Tomoshibi-technology/RCJ-Japan2024-Circuit/diagram/Encoder.pdf

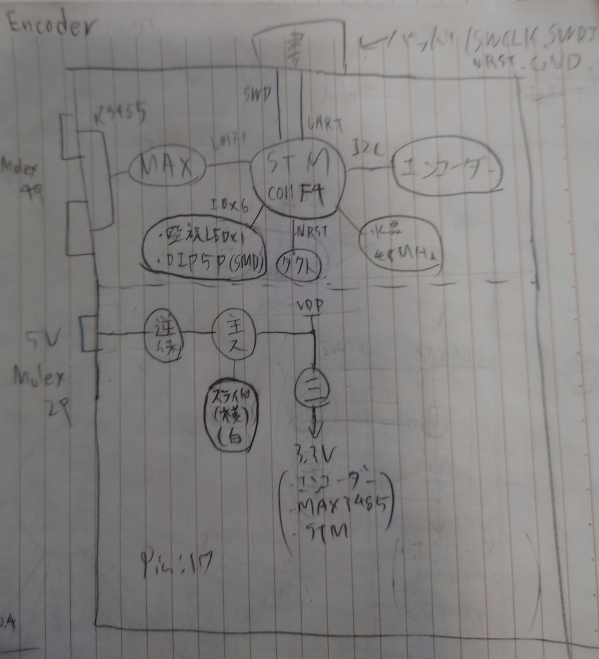
[picture p1: page 1]
