Tomoshibi-technology/RCJ-Japan2024-Circuit/diagram/IR.pdf

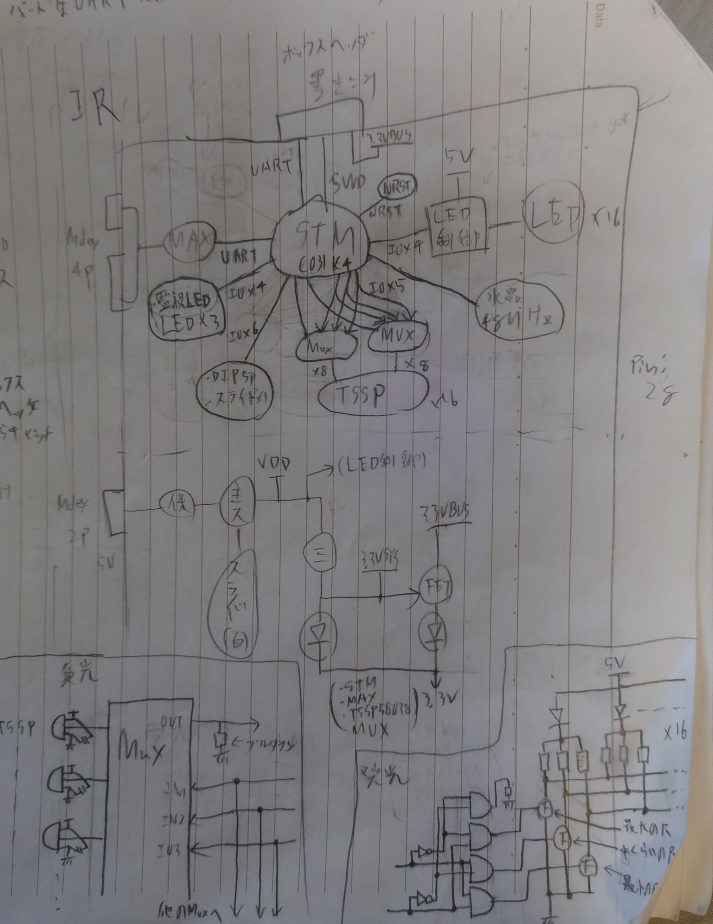
[picture p2: page 1]
