Tomoshibi-technology/RCJ-Japan2024-Circuit/diagram/LargeMD.pdf

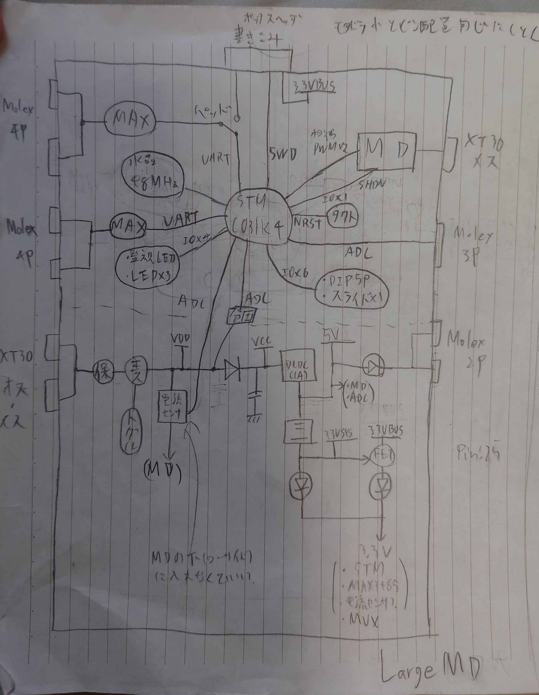
[picture p3: page 1]
