Tomoshibi-technology/RCJ-Japan2024-Circuit/diagram/Mother.pdf

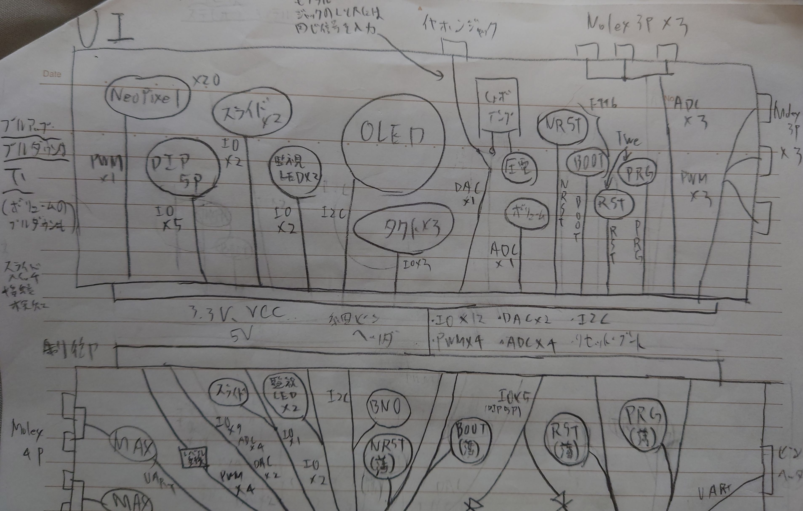
[picture p4: page 1]
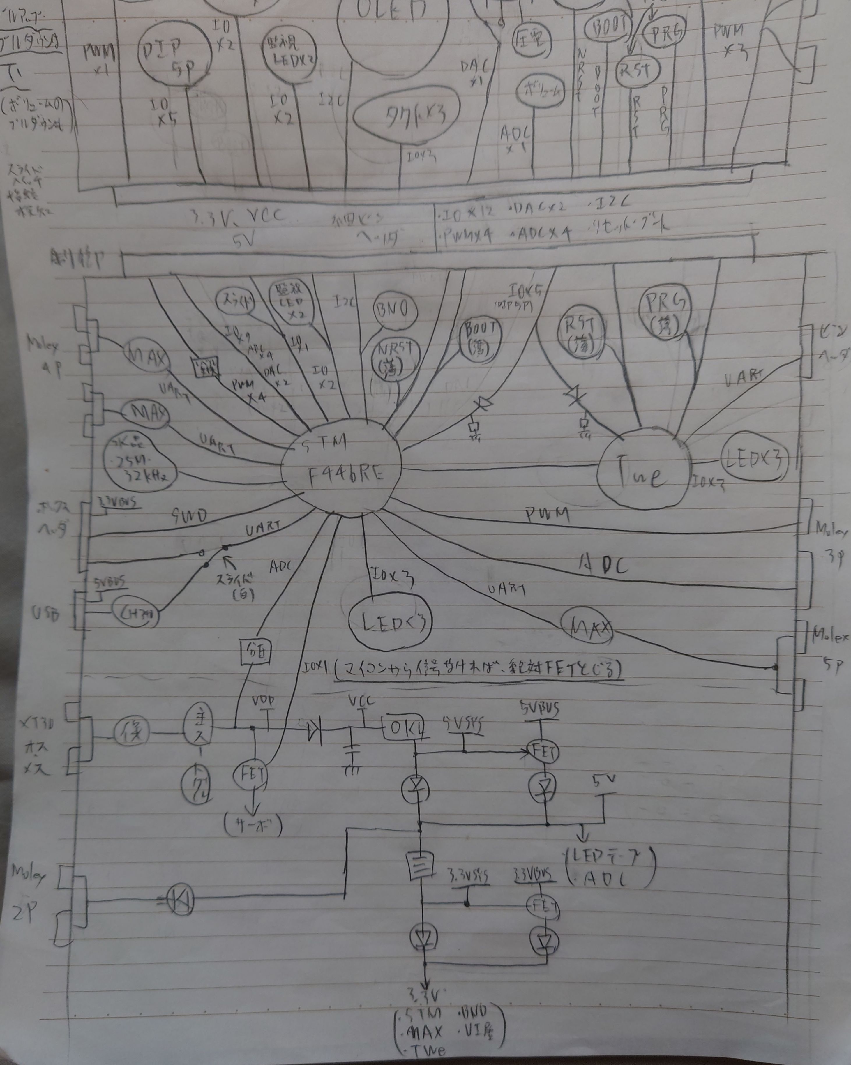
[picture p5: page 2]
