Tomoshibi-technology/RCJ-Japan2024-Circuit/diagram/Pannel.pdf

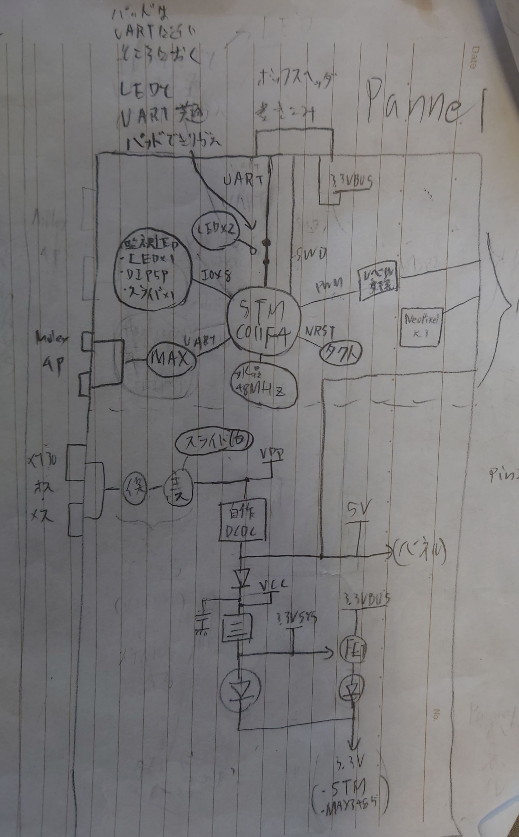
[picture p6: page 1]
