Tomoshibi-technology/RCJ-Japan2024-Circuit/diagram/SmallMD.pdf

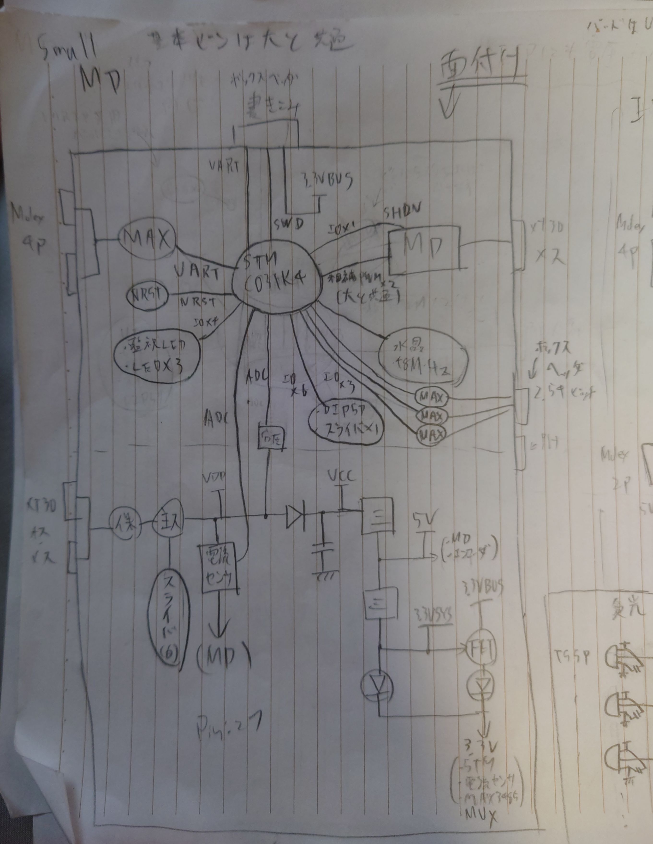
[picture p7: page 1]
