Tomoshibi-technology/RCJ-Japan2024-Circuit/diagram/SmallPW.pdf

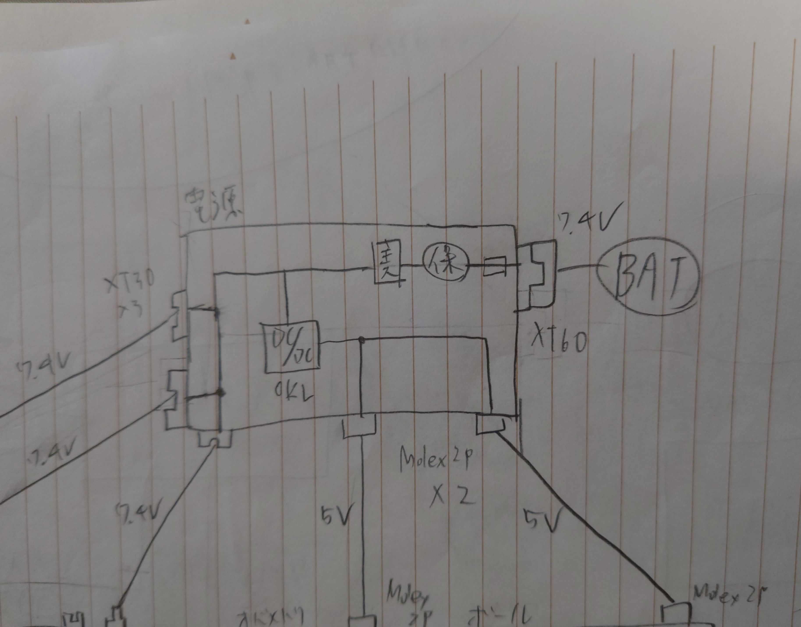
[picture p8: page 1]
