Tomoshibi-technology/RCJ-Japan2024-Circuit/diagram/LEDPole.pdf

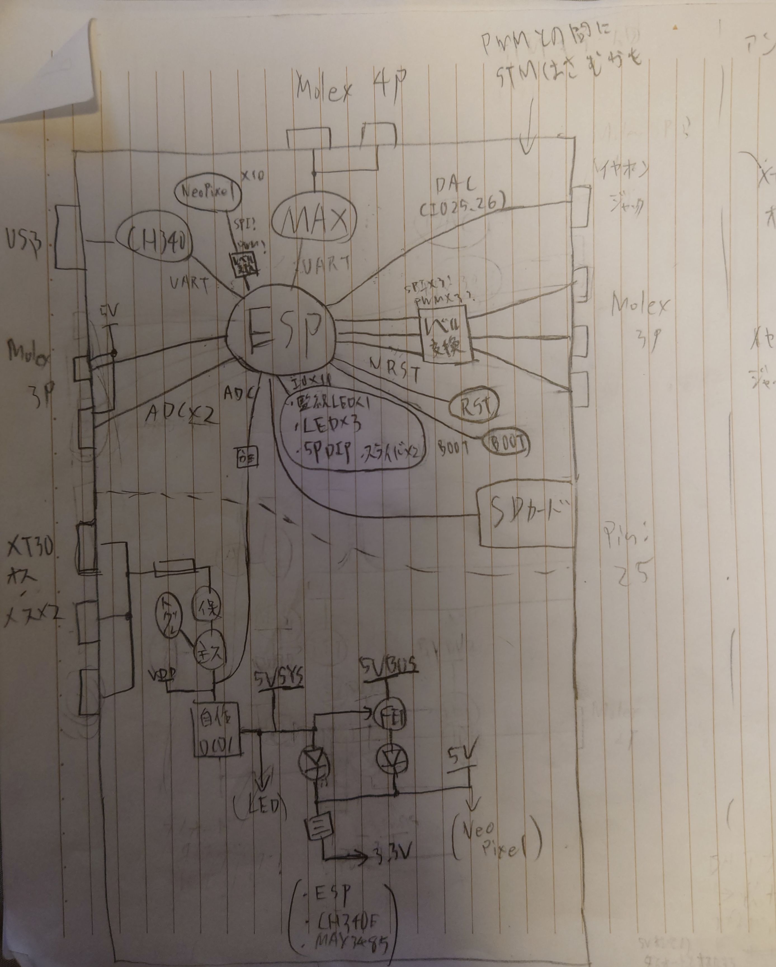
[picture p9: page 1]
