Tomoshibi-technology/RCJ-Japan2024-Circuit/diagram/RobotArm.pdf

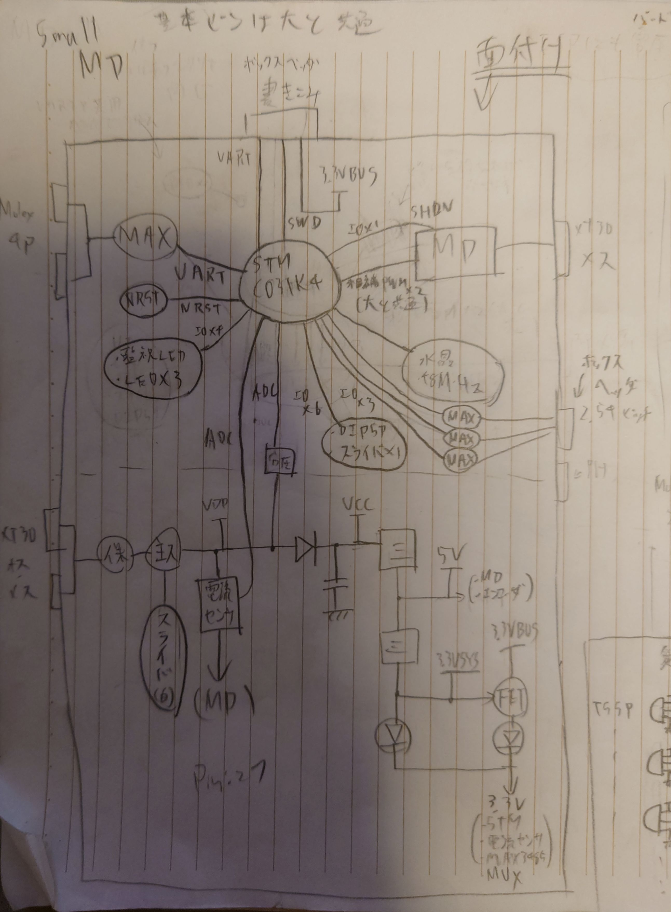
[picture p10: page 1]
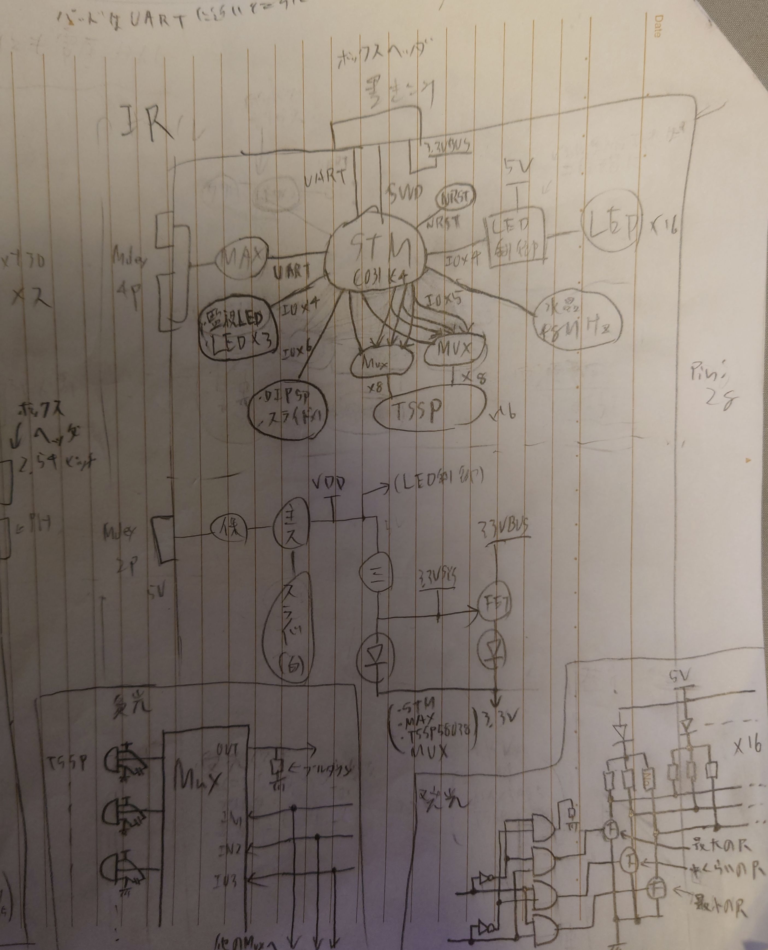
[picture p11: page 2]
