Tomoshibi-technology/RCJ-Japan2024-Circuit/LargeMD/MV2_MD_PIC2.png

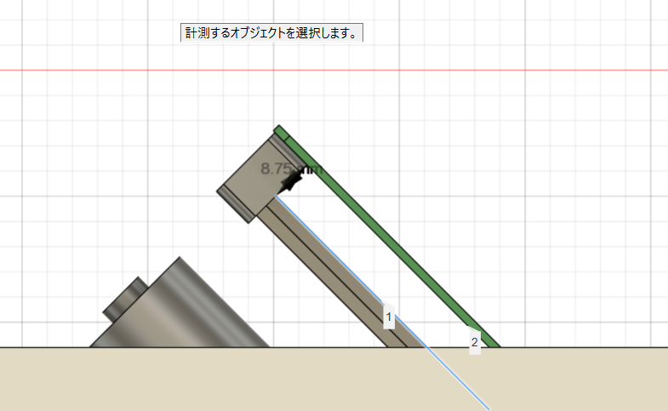
LargeMD/MV2_MD_PIC2.png
