Tomoshibi-technology/RCJ-Japan2024-Circuit/LargeMD/MV2_MD_PIC.png

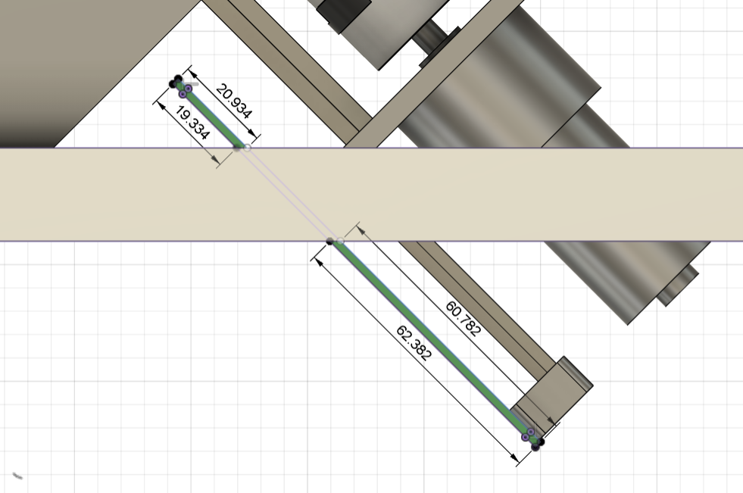
LargeMD/MV2_MD_PIC.png
