Tomoshibi-technology/RCJ-Japan2024-Circuit/Pole/jlcpcb/production_files/BOM-Pole.csv

Comment | Designator | Footprint | LCSC
1k | R1,R18,R19,R22,R23,R27,R29,R33,R42,R43,R44,R45 | R_0402_1005Metric | C11702
SSM3J332R | Q12,Q14,Q4,Q7 | SOT-23W | C146367
ADJ_ST | C7 | C_0603_1608Metric | C14663
100pF | C30 | C_0603_1608Metric | C14858
10uF | C19,C27,C3,C34,C8 | C_0805_2012Metric | C15850
CH340K | U2 | CH340K | C18208922
1N5819WS | D11,D16,D17,D2,D29,D9 | D_SOD-323_HandSoldering | C191023
1.5k | R68 | R_0603_1608Metric | C22843
10 | R59 | R_0603_1608Metric | C22859
2k | R72 | R_0603_1608Metric | C22975
2.2uH | L1 | ETQ-P4M_KVK | C230663
5.1k | R70 | R_0603_1608Metric | C23186
7.5k | R48,R71 | R_0603_1608Metric | C23234
120 | R58 | R_0402_1005Metric | C25079
510 | R32 | R_0402_1005Metric | C25123
100k | R3,R35 | R_0402_1005Metric | C25741
10k | R11,R12,R13,R16,R17,R2,R21,R24,R25,R26,R28,R30,R31,R36,R37,R38,R39,R4,R40,R46,R47,R5,R50,R51,R52,R53,R54,R55,R6,R60,R69,R7,R8 | R_0402_1005Metric | C25744
20k | R49 | R_0402_1005Metric | C25765
10k | R10 | R_0603_1608Metric | C25804
2.2k | R56,R57 | R_0402_1005Metric | C25879
5.1k | R14,R15,R73 | R_0402_1005Metric | C25905
WS2812C-2020-V1 | D18,D19,D20,D21,D22,D23,D24,D25,D26,D27 | WS2812C-2020-V1 | C2976072
S8050 | Q11,Q13,Q15,Q17,Q6 | SOT-23 | C3011093
0.1uF | C14,C15,C16,C21,C22,C23,C24,C25,C26,C29,C31,C4,C5,C6 | C_0402_1005Metric | C307331
33k | R9 | R_0603_1608Metric | C4216
22uF | C13 | C_0805_2012Metric | C45783
BSS138 | Q10,Q16,Q18,Q19,Q2,Q20,Q9 | SOT-23 | C5224274
1uF | C1,C10,C11,C12 | C_0402_1005Metric | C52923
4700pF | C2 | C_0603_1608Metric | C53987
MAX3485 | U5 | SOP-8_3.9x4.9mm_P1.27mm | C558792
MC34063AD | U6 | SOIC-8_3.9x4.9mm_P1.27mm | C71111
USB_C_Receptacle_USB2.0 | J4 | USB_C_Receptacle_G-Switch_GT-USB-7010ASV | C963412
SW_SPDT | SW2 | 3P_SPDT_5Pin_ToggleSwitch
Green | D14 | LED_0603_1608Metric_Pad1.05x0.95mm_HandSolder
Yellow | D7 | LED_0603_1608Metric_Pad1.05x0.95mm_HandSolder
Conn_01x04_Male | J13 | Molex_SPOX_5268-04A_1x04_P2.50mm_Horizontal
R_snub | R67 | R_0603_1608Metric
AudioJack3 | J6 | Jack_3.5mm_Switronic_ST-005-G_horizontal
C_snub | C36 | C_0603_1608Metric
C_snub | C9 | C_0603_1608Metric
Conn_01x03_Male | J11 | Molex_SPOX_5267-03A_1x03_P2.50mm_Vertical
C_snub | C32 | C_0603_1608Metric
TestPoint | TP5 | TestPoint_THTPad_D2.0mm_Drill1.0mm
SW_SPST | SW4 | SW_SPST_Omron_B3FS-100xP
Red | D5 | LED_0603_1608Metric_Pad1.05x0.95mm_HandSolder
AZ1084CD-3.3 | U3 | TO-252-2
SW_SPDT | SW6 | 3P_SPDT_SlideSwitch
M51957B | U1 | SOP-8_3.9x4.9mm_P1.27mm
SS2040FL | D8 | D_SOD-123
C | C17 | C_0603_1608Metric_Pad1.08x0.95mm_HandSolder
470uF | C18 | C_Elec_8x10.2
R_snub | R20 | R_0603_1608Metric
Jumper_2_Open | JP3 | SolderJumper-2_P1.3mm_Open_TrianglePad1.0x1.5mm
MountingHole_Pad | H5 | TestPoint_Pad_1.5x1.5mm
D_Zener | D10 | D_SOD-323_HandSoldering
Conn_01x04_Male | J12 | Molex_SPOX_5268-04A_1x04_P2.50mm_Horizontal
470uF | C28 | C_Elec_8x10.2
MTP4835I3 | Q3 | TO-252-2
Conn_01x03_Male | J10 | Molex_SPOX_5267-03A_1x03_P2.50mm_Vertical
470uF | C35 | CP_Radial_D10.0mm_P2.50mm_P5.00mm
LED | D1 | LED_0603_1608Metric_Pad1.05x0.95mm_HandSolder
MTP4835I3 | Q1 | TO-252-2
SW_SPDT | SW3 | 3P_SPDT_SlideSwitch
Conn_01x03_Male | J9 | Molex_SPOX_5267-03A_1x03_P2.50mm_Vertical
Conn_01x02_Male | J1 | AMASS_XT30PW-M_1x02_P2.50mm_Horizontal
Fuse | F1 | FUC_03A
Green | D12 | LED_0603_1608Metric_Pad1.05x0.95mm_HandSolder
SW_DIP_x05 | SW1 | DIP-10_W7.62mm
Conn_01x02_Female | J3 | AMASS_XT30PW-F_1x02_P2.50mm_Horizontal
MTP4835I3 | Q8 | TO-252-2
CBD20150VCT | D28 | TO-220-3_Horizontal_TabDown
2SC3265 | Q5 | SOT-23
Conn_01x03_Male | J8 | Molex_SPOX_5268-03A_1x03_P2.50mm_Horizontal
Jumper_2_Open | JP2 | PinHeader_1x02_P2.54mm_Vertical
Conn_01x02_Female | J2 | AMASS_XT30PW-F_1x02_P2.50mm_Horizontal
MTP4835I3 | Q21 | TO-252-2
Red | D4 | LED_0603_1608Metric_Pad1.05x0.95mm_HandSolder
470 | RV1 | PVZ3A
Green | D13 | LED_0603_1608Metric_Pad1.05x0.95mm_HandSolder
R_snub | R61 | R_0603_1608Metric
Conn_01x03_Male | J7 | Molex_SPOX_5268-03A_1x03_P2.50mm_Horizontal
Red | D6 | LED_0603_1608Metric_Pad1.05x0.95mm_HandSolder
ESP32-WROOM-32 | U4 | ESP32-WROOM-32
SW_SPST | SW5 | SW_SPST_Omron_B3FS-100xP
Green | D15 | LED_0603_1608Metric_Pad1.05x0.95mm_HandSolder
SS2040FL | D3 | D_SOD-123
MountingHole_Pad | H7 | TestPoint_Pad_1.5x1.5mm
MountingHole_Pad | H6 | TestPoint_Pad_1.5x1.5mm
Jumper_2_Open | JP1 | SolderJumper-2_P1.3mm_Open_TrianglePad1.0x1.5mm
MountingHole_Pad | H4 | TestPoint_Pad_1.5x1.5mm
MountingHole_Pad | H3 | TestPoint_Pad_1.5x1.5mm
