Tomoshibi-technology/RCJ-Japan2024-Circuit/connect/jlcpcb/production_files/BOM-connect.csv

Comment | Designator | Footprint | LCSC
Conn_01x03_Pin | J2 | JST_PH_B3B-PH-K_1x03_P2.00mm_Vertical
Conn_01x03_Pin | J4 | Molex_SPOX_5267-03A_1x03_P2.50mm_Vertical
