Tomoshibi-technology/RCJ-Japan2024-Circuit/部品表.xlsx

 |  |  |  |  |  |  |  |  |  |  | 必要個数 | 必要個数 | 必要個数 | 必要個数 | 必要個数 | 必要個数 | 必要個数 | 必要個数 | 必要個数
 | 種類 | 備考 | 備考 | 備考 | 総必要数 | 在庫 | 購入数 | 単価 | 小計 | URL | SmallPW | SmallMD | Pole | Panel | Mother | LargePW | LargeMD | IR | Encoder
 | 積セラ | 10uF | 2012 |  | 10 | 13 | 1 | 150 | 150 | https://akizukidenshi.com/catalog/g/g113336/ |  |  |  |  | 1
 | 積セラ | 22uF | 2012 |  | 10 | 10 | 1 | 120 | 120 | https://akizukidenshi.com/catalog/g/g108240/ |  |  |  |  | 1
 | 電解コン | 470uF |  |  | 161 | 28 | 10 | 120 | 1200 | https://akizukidenshi.com/catalog/g/g116891/ | 1 | 2 | 2 | 4 | 4 |  | 4 | 2
 | 高分子コン | 470uF | DCDCのみ |  | 19 | 0 | 20 | 80 | 1600 | https://akizukidenshi.com/catalog/g/g108292/ |  |  | 1 | 1
 | LED | 赤外線 | IRうち1枚のみ |  | 16 | 0 | 2 | 200 | 400 | https://akizukidenshi.com/catalog/g/g104313/ |  |  |  |  |  |  |  | 16
 | LED | 赤 |  |  | 222 | 25 | 1 | 980 | 980 | https://akizukidenshi.com/catalog/g/g111809/ |  | 5 | 3 | 3 | 5 |  | 5 | 3
 | LED | 緑 |  |  | 170 | 6 | 10 | 100 | 1000 | https://akizukidenshi.com/catalog/g/g111878/ |  | 2 | 5 | 2 | 4 |  | 2 | 2 | 2
 | LED | 黄 |  |  | 100 | 22 | 5 | 200 | 1000 | https://akizukidenshi.com/catalog/g/g103984/ |  | 1 | 1 | 1 | 5 |  | 1 | 1 | 1
 | ショットキー | 10A |  | MA10EB045 | 15 | 5 | 10 | 80 | 800 | https://akizukidenshi.com/catalog/g/g117496/ |  |  |  |  | 1 |  | 1
 | ショットキー | 20A | DCDCのみ | CBD20150VCT | 19 | 0 | 20 | 50 | 1000 | https://akizukidenshi.com/catalog/g/g106169/ |  |  | 1 | 1
 | ショットキー | 2A |  | SS2040FL | 182 | 14 | 8 | 480 | 3840 | https://akizukidenshi.com/catalog/g/g102073/ |  | 7 | 2 | 3 |  |  | 6
 | ショットキー | 信号用 |  | CUS10F30(1N5819WS) | 210 | 0 | 1 | 150 | 150 | https://akizukidenshi.com/catalog/g/g107687/ | 1 | 4 | 6 | 4 |  | 2 | 5 | 2 | 2
 | XT30 | 基板用 | オス |  | 34 | 27 | 10 | 60 | 600 | https://akizukidenshi.com/catalog/g/g117949/ |  |  | 1 | 1 | 1 |  | 1
 | XT30 | 基板用 | メス |  | 49 | 0 | 50 | 60 | 3000 | https://akizukidenshi.com/catalog/g/g117948/ |  |  | 2 | 1 | 1 |  | 2
 | XT30 | ケーブル用 | オス |  | 101 | 26 | 80 | 50 | 4000 | https://akizukidenshi.com/catalog/g/g117951/ | 5 | 2 | 2 | 1 |  | 12 | 1
 | XT30 | ケーブル用 | メス |  | 101 | 27 | 80 | 50 | 4000 | https://akizukidenshi.com/catalog/g/g117950/ | 5 | 2 | 1 | 1 | 1 | 12 | 1
 | イヤホンジャック | 3.5mm |  |  | 20 | 0 | 20 | 50 | 1000 | https://akizukidenshi.com/catalog/g/g102460/ |  |  | 1 |  | 1
 | ピンソケット | 12P | V | 細ピン | 30 | 0 | 10 | 80 | 800 | https://akizukidenshi.com/catalog/g/g110073/ |  |  |  |  | 3
 | ピンソケット | 10P | H |  | 10 | 5 | 7 | 40 | 280 | https://akizukidenshi.com/catalog/g/g112984/ |  |  |  |  | 1
 | スピーカー |  |  |  | 10 | 0 | 10 | 100 | 1000 | https://akizukidenshi.com/catalog/g/g105723/ |  |  |  |  | 1
 | NPN | 小電流用 |  | 2SC3265-Y | 19 | 0 | 1 | 200 | 200 | https://akizukidenshi.com/catalog/g/g108448/ |  |  | 1 | 1
 | PchFET | 超大電流用 |  | TJ60S04M3L | 14 | 10 | 5 | 90 | 450 | https://akizukidenshi.com/catalog/g/g116297/ |  |  |  |  |  | 4 | 2
 | PchFET | 大電流用 |  | MTP4835 | 116 | 9 | 110 | 30 | 3300 | https://akizukidenshi.com/catalog/g/g116096/ | 2 |  | 4 | 4 | 3
 | PchFET | 中電流用 | 中耐圧 | SSM6J808R | 30 | 23 | 2 | 100 | 200 | https://akizukidenshi.com/catalog/g/g115504/ |  | 2
 | NchFET | 中電流用 | デュアルFET | uPA2753 | 30 | 0 | 8 | 100 | 800 | https://akizukidenshi.com/catalog/g/g100983/ |  | 2
 | NchFET | 中電流用 | 低耐圧 | SSM3K345R | 4 | 0 | 1 | 100 | 100 | https://akizukidenshi.com/catalog/g/g117477/ |  |  |  |  |  |  |  | 4
 | 可変抵抗 | 470 |  | SMD | 19 | 0 | 2 | 200 | 400 | https://akizukidenshi.com/catalog/g/g109364/ |  |  | 1 | 1
 | 可変抵抗 |  |  | THT | 10 | 0 | 10 | 50 | 500 | https://akizukidenshi.com/catalog/g/g106109/ |  |  |  |  | 1
 | シャント抵抗 | 20mΩ | 1W |  | 40 | 0 | 4 | 100 | 400 | https://akizukidenshi.com/catalog/g/g106668/ |  | 2 |  |  |  |  | 2
 | スイッチ | タクト | SPST |  | 85 | 20 | 70 | 15 | 1050 | https://akizukidenshi.com/catalog/g/g103647/ |  |  | 2 | 1 | 4 |  | 1 | 1 | 1
 | スイッチ | タクト | SPST | 薄型 | 55 | 0 | 11 | 100 | 1100 | https://akizukidenshi.com/catalog/g/g106185/ |  | 1 |  |  | 4
 | スイッチ | スライド | SPDT |  | 93 | 23 | 70 | 20 | 1400 | https://akizukidenshi.com/catalog/g/g115707/ |  | 1 | 2 | 2 | 3 |  | 1 | 1
 | スイッチ | スライド | SPDT | 白 | 45 | 0 | 50 | 25 | 1250 | https://akizukidenshi.com/catalog/g/g115367/ |  | 1 |  | 1 | 1 |  |  | 1 | 1
 | スイッチ | トグル | SPDT | 低背 | 25 | 0 | 25 | 80 | 2000 | https://akizukidenshi.com/catalog/g/g112407/ |  |  | 1 |  | 1 |  | 1
 | スイッチ | 5PDIP | SPST*5 | THT | 54 | 0 | 55 | 110 | 6050 | https://akizukidenshi.com/catalog/g/g108924/ |  | 1 | 1 | 1 | 1 |  | 1 | 1
 | スイッチ | 5PDIP | SPST*5 | SMD | 6 | 0 | 6 | 150 | 900 | https://akizukidenshi.com/catalog/g/g118019/ |  |  |  |  |  |  |  |  | 1
 | スイッチ | ロッカー |  |  | 6 | 1 | 5 | 140 | 700 | https://akizukidenshi.com/catalog/g/g115740/ | 1 |  |  |  |  | 1
 | NeoPixel |  |  | WS2812B | 10 | 1 | 4 | 50 | 200 | https://akizukidenshi.com/catalog/g/g107915/ |  |  |  |  | 1
 | OLED |  |  |  | 10 | 2 | 8 | 580 | 4640 | https://akizukidenshi.com/catalog/g/g112031/ |  |  |  |  | 1
 | フォトIC |  |  | TLP2361 | 40 | 0 | 40 | 50 | 2000 | https://akizukidenshi.com/catalog/g/g111004/ |  | 2 |  |  |  |  | 2
 | オペアンプ |  |  | NJM4580 | 10 | 0 | 2 | 120 | 240 | https://akizukidenshi.com/catalog/g/g107100/ |  |  |  |  | 1
 | 水晶発振IC |  |  | NJU6319AE | 34 | 0 | 9 | 100 | 900 | https://akizukidenshi.com/catalog/g/g110494/ |  | 1 |  | 1 |  |  | 1 | 1
 | 電流センサ |  |  | LT6106 | 20 | 0 | 20 | 320 | 6400 | https://akizukidenshi.com/catalog/g/g107300/ |  | 1 |  |  |  |  | 1
 | 電圧監視 |  |  | M51957B | 19 | 0 | 5 | 200 | 1000 | https://akizukidenshi.com/catalog/g/g102284/ |  |  | 1 | 1
 | DCDC IC |  |  | MC34063AD | 19 |  | 5 | 40 | 200 | https://akizukidenshi.com/catalog/g/g117573/ |  |  | 1 | 1
 | 三端子 | 5V |  |  | 15 | 0 | 15 | 50 | 750 | https://akizukidenshi.com/catalog/g/g117599/ |  | 1
 | 三端子 | 3.3V |  |  | 60 | 7 | 50 | 50 | 2500 | https://akizukidenshi.com/catalog/g/g117598/ |  | 1 | 1 | 1 | 1 |  | 1 | 1 | 1
 | DCDC | 5V | 1A | BP5293 | 5 | 5 | 3 | 240 | 720 | https://akizukidenshi.com/catalog/g/g111188/ |  |  |  |  |  |  | 1
 | DCDC | 5V | 6A | OKL | 10 | 2 | 8 | 880 | 7040 | https://akizukidenshi.com/catalog/g/g106187/ |  |  |  |  | 1
 | アンテナ |  |  |  | 10 | 0 |  |  | 0
 | TweLite |  |  | アンテナ別付け | 10 | 0 | 10 | 1450 | 14500 | https://akizukidenshi.com/catalog/g/g108263/ |  |  |  |  | 1
 | BNO055 |  |  |  | 10 | 1 | 5 | 2450 | 12250 | https://akizukidenshi.com/catalog/g/g116996/ |  |  |  |  | 1
 | ESP32 |  |  |  | 10 | 8 | 5 | 480 | 2400 | https://akizukidenshi.com/catalog/g/g115675/ |  |  | 1
 | 水晶 | 48MHz |  | SMD | 6 | 0 | 2 | 100 | 200 | https://akizukidenshi.com/catalog/g/g106573/ |  |  |  |  |  |  |  |  | 1
 | 水晶 | 16MHz |  | SMD | 44 | 0 | 1 | 200 | 200 | https://akizukidenshi.com/catalog/g/g102457/ |  | 1 |  | 1 | 1 |  | 1 | 1
 | 水晶 | 32.768kHz |  | SMD | 10 | 0 | 3 | 200 | 600 | https://akizukidenshi.com/catalog/g/g107195/ |  |  |  |  | 1
 | 電圧計 |  |  |  | 6 | 3 | 3 | 330 | 990 | https://akizukidenshi.com/catalog/g/g108468/ | 1 |  |  |  |  | 1
 | ヒューズホルダー |  | ミゼット |  | 20 | 14 | 10 | 20 | 200 | https://akizukidenshi.com/catalog/g/g110521/ |  |  | 2
 |  |  |  |  |  |  |  |  | 105650
 | 非常停止
 | ボックスヘッダ | 2×5P/1.27mm | H |  | 5 | 0 | 7 | 276.9 | 1938.3 | https://www.mouser.jp/ProductDetail/Wurth-Elektronik/62701021721?qs=1Kr7Jg1SGW%2FQWdVcBDZJJw%3D%3D |  |  |  |  |  |  | 1
マイコン | コイル | 2.2uH |  | JLCに実装頼む | 19 | 0 | 10 | 111.1 | 1111 | https://www.mouser.jp/ProductDetail/Panasonic/ETQ-P4M2R2KVK?qs=DddhjTRTMKxtDEQdd9aMKQ%3D%3D |  |  | 1 | 1
 | ヒューズホルダー |  |  |  | 6 | 0 | 10 | 165.2 | 1652 | https://www.mouser.jp/ProductDetail/Keystone-Electronics/3568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 | 1 |  |  |  |  | 1
 | ヒューズ | ブレード | 15A |  | 5 | 8+α | 0 |  | 0 | https://www.mouser.jp/ProductDetail/Littelfuse/0297015.WXNV?qs=ar9f0rk5DXBnu3UWIatUjA%3D%3D | 1
 | ヒューズ | ブレード | 30A |  | 1 | 3 | 0 |  | 0 | https://www.mouser.jp/ProductDetail/Littelfuse/0297030.WXNV?qs=KOeOmFnJLToFnmcWtFRk4A%3D%3D |  |  |  |  |  | 1
 | NchFET | TPH3R704PL |  |  | 20 | 0 | 30 | 120.1 | 3603 | https://www.mouser.jp/ProductDetail/Toshiba/TPH3R704PLL1Q?qs=vniZgrqwd6g%2Fd%2FpdbCUXQQ%3D%3D |  |  |  |  |  |  | 4
 | AS5600 |  |  | JLCに実装頼む | 6 | 5 | 0 |  | 0 |  |  |  |  |  |  |  |  |  | 1
 | IR2302 |  |  |  | 40 | 0 | 50 | 219.8 | 10990 | https://www.digikey.jp/ja/products/detail/infineon-technologies/IR2302STRPBF/1928470 |  | 2 |  |  |  |  | 2
 | MiniSPOX | ポスト | H/5P | 22057055 | 20 | 28 | 0 |  | 0 | https://www.mouser.jp/ProductDetail/Molex/22-05-7055?qs=xrDmMQn67Z5hmxzhkkBWYQ%3D%3D |  |  |  |  | 2
 | MiniSPOX | ポスト | H/4P | 22057045 | 100 | 19 | 100 | 26.6 | 2660 | https://www.mouser.jp/ProductDetail/Molex/22-05-7045?qs=xrDmMQn67Z7IIk77EGZFzA%3D%3D |  |  | 2 | 2 | 4 |  | 2 |  | 2
 | MiniSPOX | ポスト | H/3P | 22057035 | 105 | 8 | 120 | 21.9 | 2628 | https://www.mouser.jp/ProductDetail/Molex/22-05-7035?qs=Crveo0%2FlhpeTQWWlghVCyA%3D%3D |  |  | 2 |  | 8 |  | 1
 | MiniSPOX | ポスト | H/2P | 22057025 | 16 | 46 | 0 | 17.6 | 0 | https://www.mouser.jp/ProductDetail/Molex/22-05-7025?qs=sGAEpiMZZMvlX3nhDDO4AGLycyQkHHQV4kHU9oALxLo%3D |  |  |  |  | 1 |  |  |  | 1
 | MiniSPOX | ポスト | V/5P | 22035055 | 0 | 6 | 0 |  | 0 | https://www.mouser.jp/ProductDetail/Molex/22-03-5055?qs=AplfTeSvkkD4m3TF5HmOBQ%3D%3D
 | MiniSPOX | ポスト | V/4P | 22035045 | 50 | 0 | 100 | 22 | 2200 | https://www.mouser.jp/ProductDetail/Molex/22-03-5045?qs=ZDXmSm13592ymm0ujoo9aQ%3D%3D |  | 2 |  |  |  |  | 2 | 2
 | MiniSPOX | ポスト | V/3P | 22035035 | 30 | 大量 | 0 |  | 0 | https://www.mouser.jp/ProductDetail/Molex/22-03-5035?qs=VKrXD49J9Ep%252Bv2WwbOoiPA%3D%3D |  |  | 3
 | MiniSPOX | ポスト | V/2P | 22035025 | 11 | 10 | 10 | 15.1 | 151 | https://www.mouser.jp/ProductDetail/Molex/22-03-5025 |  |  |  |  |  | 1 | 1 | 1
 | MiniSPOX | ハウジング | 5P | 50375053 | 20 | 46 | 0 |  | 0 | https://www.mouser.jp/ProductDetail/Molex/50-37-5053?qs=uJX40y%2BSWqiDzEW%2BqN%2BlGA%3D%3D
 | MiniSPOX | ハウジング | 4P | 50375043 | 150 | 0 | 200 | 13.5 | 2700 | https://www.mouser.jp/ProductDetail/Molex/50-37-5043?qs=uJX40y%2BSWqhAd9T97yqkvw%3D%3D
 | MiniSPOX | ハウジング | 3P | 50375033 | 135 | 118 | 30 | 15.1 | 453 | https://www.mouser.jp/ProductDetail/Molex/50-37-5033?qs=AplfTeSvkkCfnVdKv8UuEg%3D%3D
 | MiniSPOX | ハウジング | 2P | 50375023 | 27 | 56 | 0 |  | 0 | https://www.mouser.jp/ProductDetail/Molex/50-37-5023?qs=ZDXmSm13592S7lD6I%2BYObw%3D%3D
 | MiniSPOX | コンタクト |  | 8701039 | 1159 | 400 | 1000 | 8.9 | 8900 | https://www.mouser.jp/ProductDetail/Molex/08-70-1039-Mouser-Reel?qs=Y0K5pK5Q%2FZEpgThNnEYnNQ%3D%3D
 | F446RE |  |  | JLCに実装頼む | 10 | 4 | 0 |  | 0 | https://www.mouser.jp/ProductDetail/STMicroelectronics/STM32F446RET6?qs=Ok1pvOkw6%2FqpQsWf8F4wtQ%3D%3D |  |  |  |  | 1
 | G030K6 |  |  | JLCに実装頼む | 34 | 0 | 10 | 205 | 2050 | https://www.mouser.jp/ProductDetail/STMicroelectronics/STM32G030K6T6?qs=uwxL4vQweFPeOf7U32Wkbw%3D%3D |  | 1 |  | 1 |  |  | 1 | 1
 | C011F6 |  |  |  | 6 | 0 | 10 | 203.5 | 2035 | https://www.mouser.jp/ProductDetail/STMicroelectronics/STM32C011F6P6?qs=IPgv5n7u5Qb445hYVpG9pg%3D%3D |  |  |  |  |  |  |  |  | 1
 |  |  |  |  |  |  |  |  | 0
 | ボックスヘッダ | 2×5P/1.27mm | V |  | 39 | 0 | 50 | 33 | 1650 | https://www.aitendo.com/product/18518 |  | 1 |  | 1 | 1 |  |  | 1
 | マルチプレクサ |  |  |  | 10 | 0 | 10 | 50.8 | 508 | https://www.mouser.jp/ProductDetail/Nexperia/74HC4051PW118?qs=P62ublwmbi9HhBEGmubfjA%3D%3D |  |  |  |  |  |  |  | 2
 | TSSP58038 |  |  |  | 80 | 0 | 100 | 134 | 13400 | https://www.mouser.jp/ProductDetail/Vishay-Semiconductors/TSSP58038?qs=lgjwDzixuo29LR1eAo9EoA%3D%3D |  |  |  |  |  |  |  | 16
 |  |  |  |  |  |  |  | 総計 | 58629.3
