Tomoshibi-technology/RCJ-Japan2024-Circuit/connect/connect.step

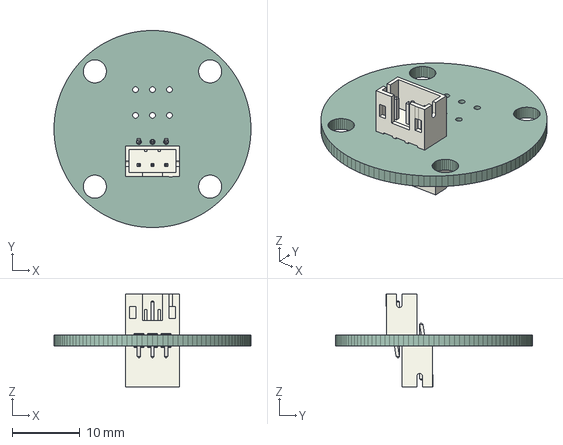
[picture p14: CAD file, 2024-02-10]
connect/connect.step
29.0 x 29.0 x 13.7 mm
PCB
