Tomoshibi-technology/RCJ-Japan2024-Circuit/Encoder/MV2_Encoder_OUTLINE.dxf

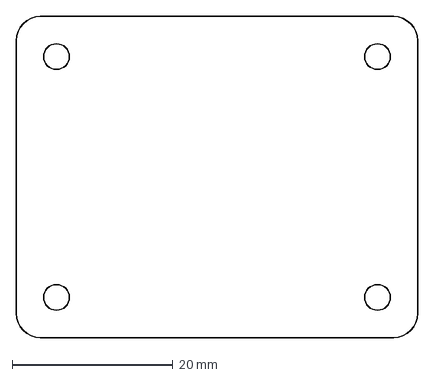
[picture p15: CAD file, 2024-01-30]
Encoder/MV2_Encoder_OUTLINE.dxf
50.0 x 40.0 mm
