Tomoshibi-technology/RCJ-Japan2024-Circuit/IR/IR_Silkscreen.dxf

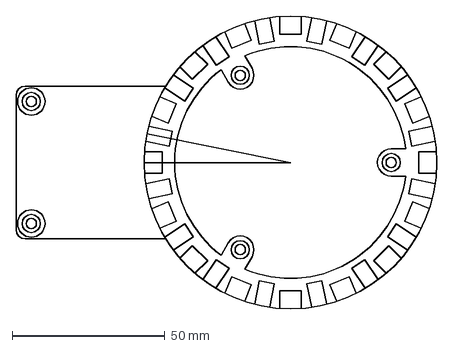
[picture p16: CAD file, 2024-02-07]
IR/IR_Silkscreen.dxf
138.0 x 96.0 mm
