Tomoshibi-technology/RCJ-Japan2024-Circuit/LargeMD/MV2_MD_BK_SILK2.dxf

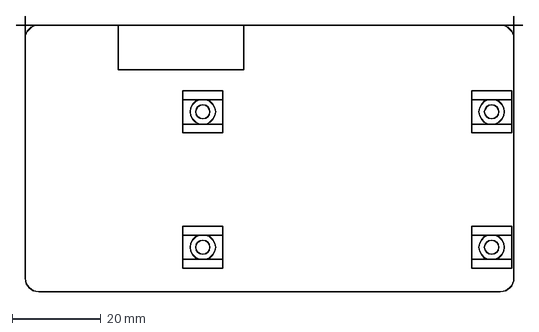
[picture p17: CAD file, 2024-01-30]
LargeMD/MV2_MD_BK_SILK2.dxf
114.0 x 62.0 mm
