Tomoshibi-technology/RCJ-Japan2024-Circuit/LargePW/MV2_PW_OUTLINE.dxf

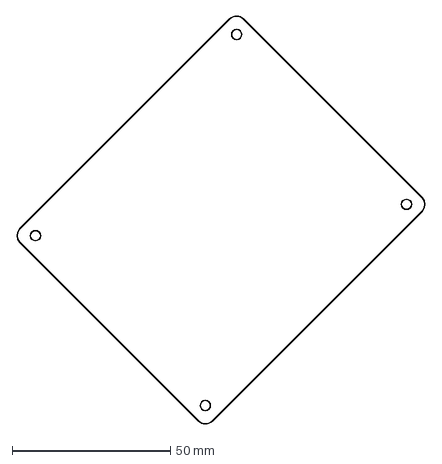
[picture p18: CAD file, 2024-02-16]
LargePW/MV2_PW_OUTLINE.dxf
129.6 x 129.0 mm
