Tomoshibi-technology/RCJ-Japan2024-Circuit/LED_lighting_large/LED_lighting_large.step

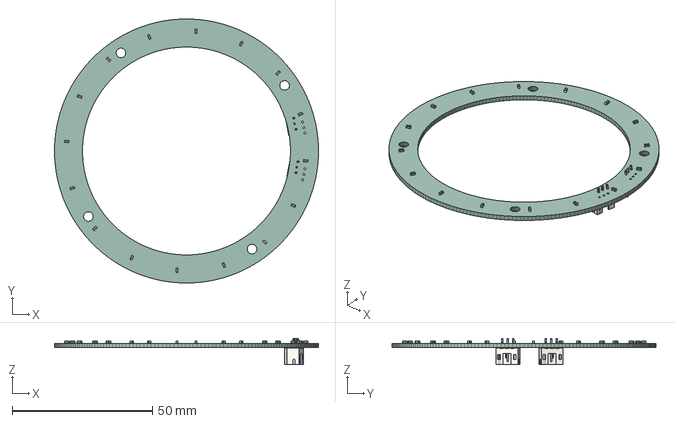
[picture p19: CAD file, 2024-02-10]
LED_lighting_large/LED_lighting_large.step
94.0 x 94.0 x 9.40 mm
PCB
