Tomoshibi-technology/RCJ-Japan2024-Circuit/Mother/mother.dxf

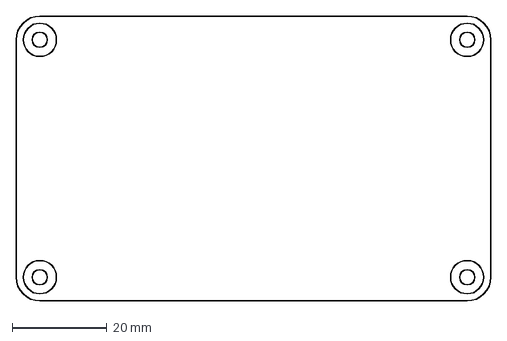
[picture p20: CAD file, 2024-02-06]
Mother/mother.dxf
100.0 x 60.0 mm
