Tomoshibi-technology/RCJ-Japan2024-Circuit/Mother_Ctrl/Mother_Ctrl-Edge_Cuts.dxf

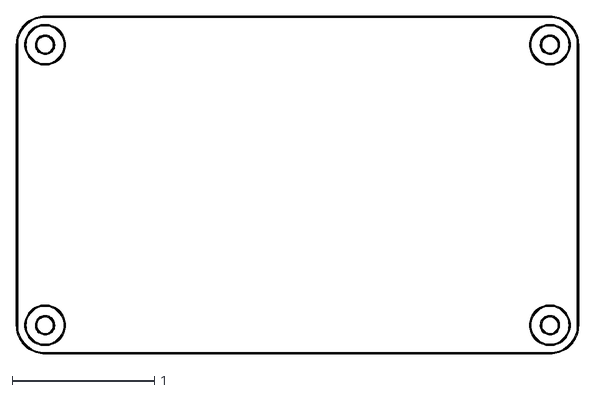
[picture p21: CAD file, 2024-02-26]
Mother_Ctrl/Mother_Ctrl-Edge_Cuts.dxf
3.94 x 2.37
