Tomoshibi-technology/RCJ-Japan2024-Circuit/Panel/MV2_Panel_FW_SILK.dxf

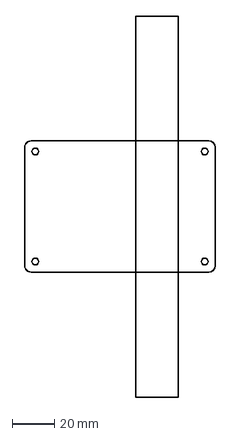
[picture p22: CAD file, 2024-02-02]
Panel/MV2_Panel_FW_SILK.dxf
90.0 x 180.0 mm
