Tomoshibi-technology/RCJ-Japan2024-Circuit/SmallMD/SmallMD_Silkscreen_B.dxf

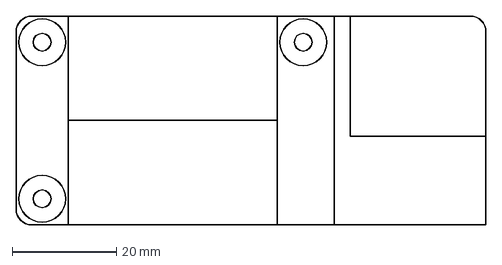
[picture p23: CAD file, 2024-02-07]
SmallMD/SmallMD_Silkscreen_B.dxf
90.0 x 40.0 mm
