Tomoshibi-technology/RCJ-Japan2024-Circuit/SmallPW/SmallPW_Silkscreen_B.dxf

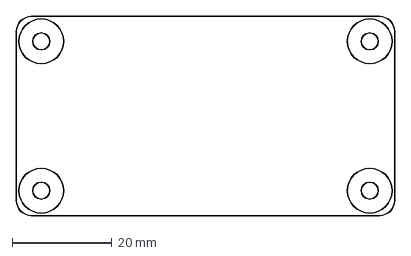
[picture p24: CAD file, 2024-02-07]
SmallPW/SmallPW_Silkscreen_B.dxf
76.0 x 40.0 mm
