Tomoshibi-technology/RCJ-Japan2024-Circuit/Encoder/MV2_Encoder_SILK.dxf

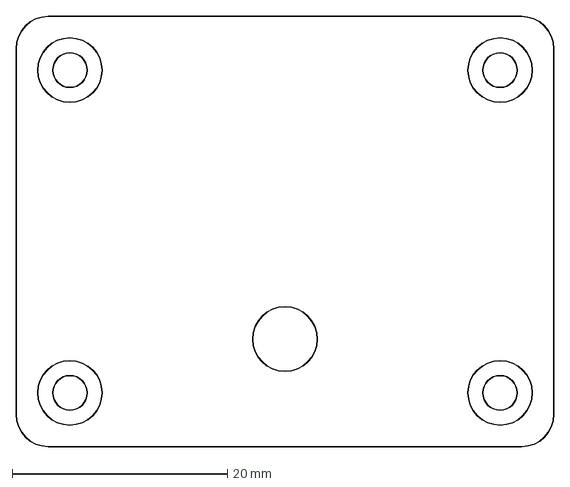
[picture p25: CAD file, 2024-01-30]
Encoder/MV2_Encoder_SILK.dxf
50.0 x 40.0 mm
