Tomoshibi-technology/RCJ-Japan2024-Circuit/IR/IR_EdgeCuts.dxf

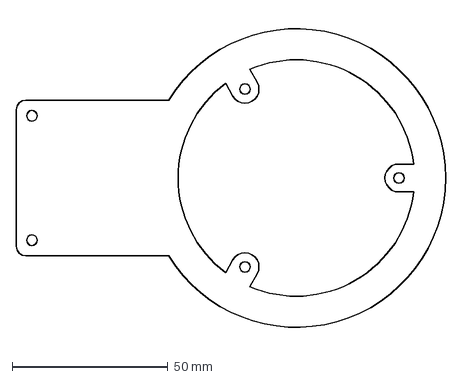
[picture p26: CAD file, 2024-02-07]
IR/IR_EdgeCuts.dxf
138.0 x 104.1 mm
