Tomoshibi-technology/RCJ-Japan2024-Circuit/LargePW/MV2_PW_SILK.dxf

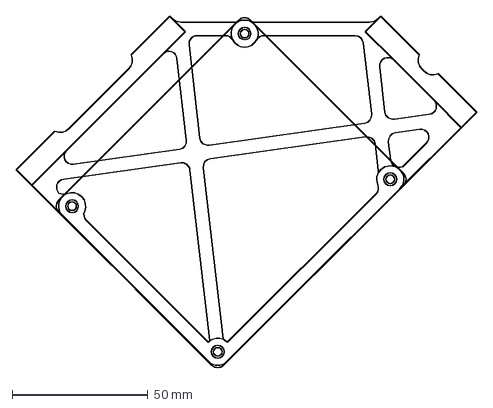
[picture p28: CAD file, 2024-02-16]
LargePW/MV2_PW_SILK.dxf
169.7 x 129.6 mm
