Tomoshibi-technology/RCJ-Japan2024-Circuit/Panel/MV2_Panel_BK_SILK.dxf

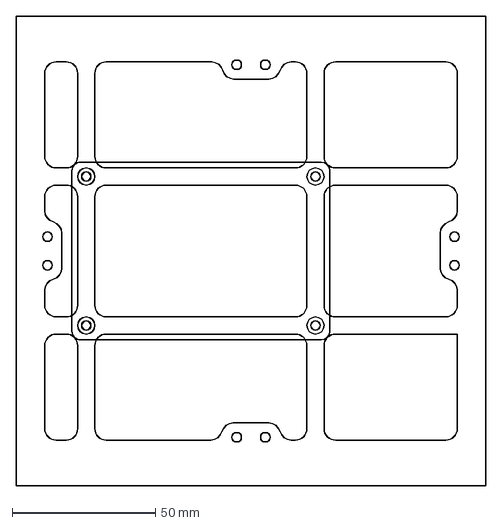
[picture p29: CAD file, 2024-02-02]
Panel/MV2_Panel_BK_SILK.dxf
164.0 x 164.0 mm
