Tomoshibi-technology/RCJ-Japan2024-Circuit/SmallMD/SmallMD_EdgeCuts.dxf

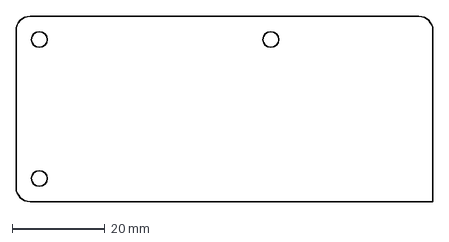
[picture p30: CAD file, 2024-02-07]
SmallMD/SmallMD_EdgeCuts.dxf
90.0 x 40.0 mm
