Tomoshibi-technology/RCJ-Japan2024-Circuit/LargeMD/MV2_MD_OUTLINE.dxf

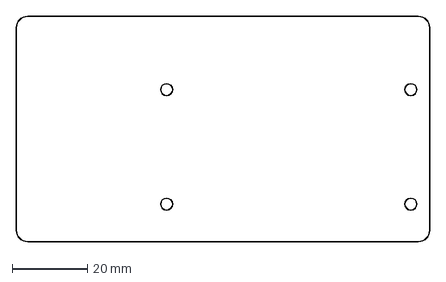
[picture p32: CAD file, 2024-01-30]
LargeMD/MV2_MD_OUTLINE.dxf
110.0 x 60.0 mm
