Tomoshibi-technology/RCJ-Japan2024-Circuit/Panel/MV2_Panel_OUTLINE.dxf

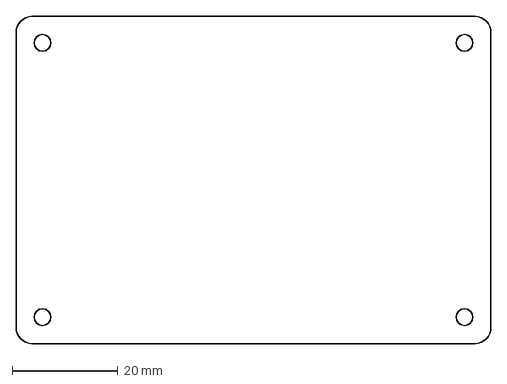
[picture p33: CAD file, 2024-02-02]
Panel/MV2_Panel_OUTLINE.dxf
90.0 x 62.0 mm
