Tomoshibi-technology/RCJ-Japan2024-Circuit/SmallMD/SmallMD_Silkscreen_F.dxf

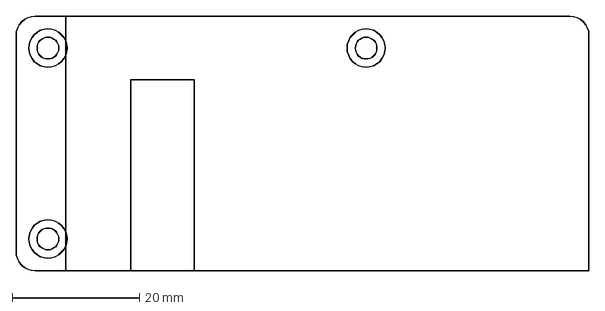
[picture p34: CAD file, 2024-02-07]
SmallMD/SmallMD_Silkscreen_F.dxf
90.0 x 40.0 mm
