Tomoshibi-technology/RCJ-Japan2024-Circuit/SmallPW/SmallPW_EdgeCuts.dxf

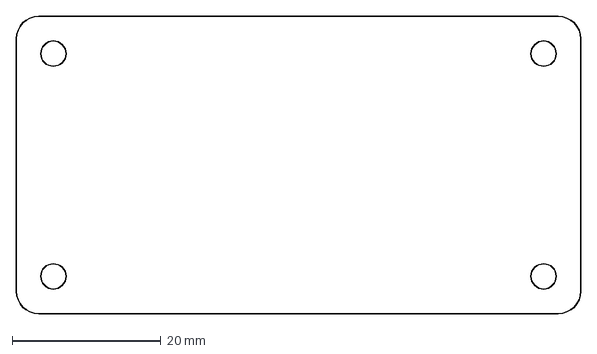
[picture p35: CAD file, 2024-02-07]
SmallPW/SmallPW_EdgeCuts.dxf
76.0 x 40.0 mm
