Tomoshibi-technology/RCJ-Japan2024-Circuit/LargeMD/MV2_MD_BK_SILK.dxf

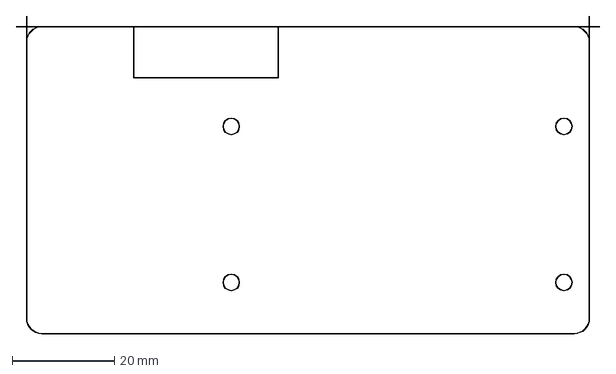
[picture p36: CAD file, 2024-01-30]
LargeMD/MV2_MD_BK_SILK.dxf
114.0 x 62.0 mm
