Tomoshibi-technology/RCJ-Japan2024-Circuit/SmallMD/SmallMD_裏面実装禁止エリア.dxf

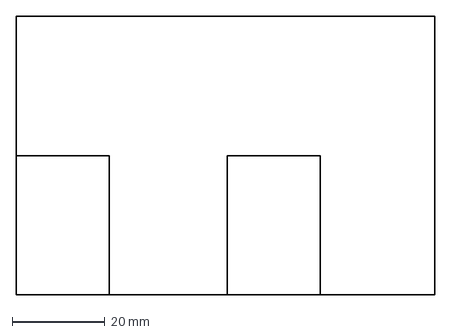
[picture p37: CAD file, 2024-02-01]
SmallMD/SmallMD_裏面実装禁止エリア.dxf
90.0 x 60.0 mm
