Tomoshibi-technology/RCJ-Japan2024-Circuit/SmallPW/SmallPW_背面実装禁止エリア.dxf

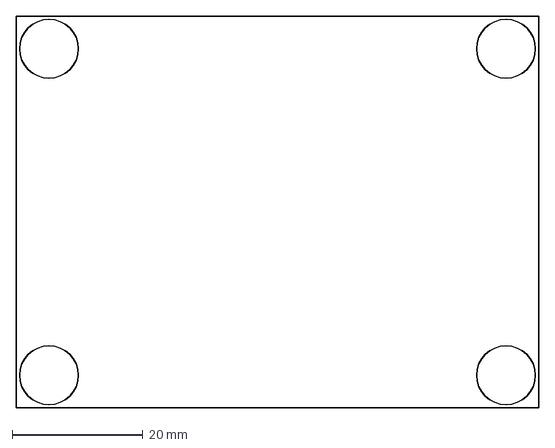
[picture p38: CAD file, 2024-02-01]
SmallPW/SmallPW_背面実装禁止エリア.dxf
80.0 x 60.0 mm
