Tomoshibi-technology/RCJ-Japan2024-Circuit/SmallMD/SmallMD_Silkscreen.dxf

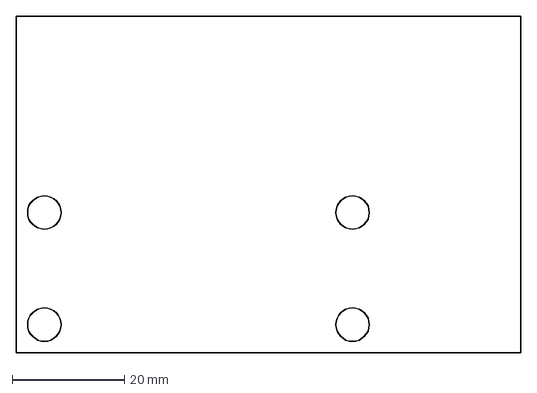
[picture p39: CAD file, 2024-02-01]
SmallMD/SmallMD_Silkscreen.dxf
90.0 x 60.0 mm
