Tomoshibi-technology/RCJ-Japan2024-Circuit/(list of files, cad)

Other CAD files:
Mother_Ctrl/Mother_Ctrl-B_Silkscreen.dxf
Mother_Ctrl/Mother_Ctrl-F_Mask.dxf
Mother_Ctrl/Mother_Ctrl-F_Silkscreen.dxf
