Tomoshibi-technology/RCJ-Japan2024-Circuit/Mother_Ctrl/Mother_Ctrl.pdf

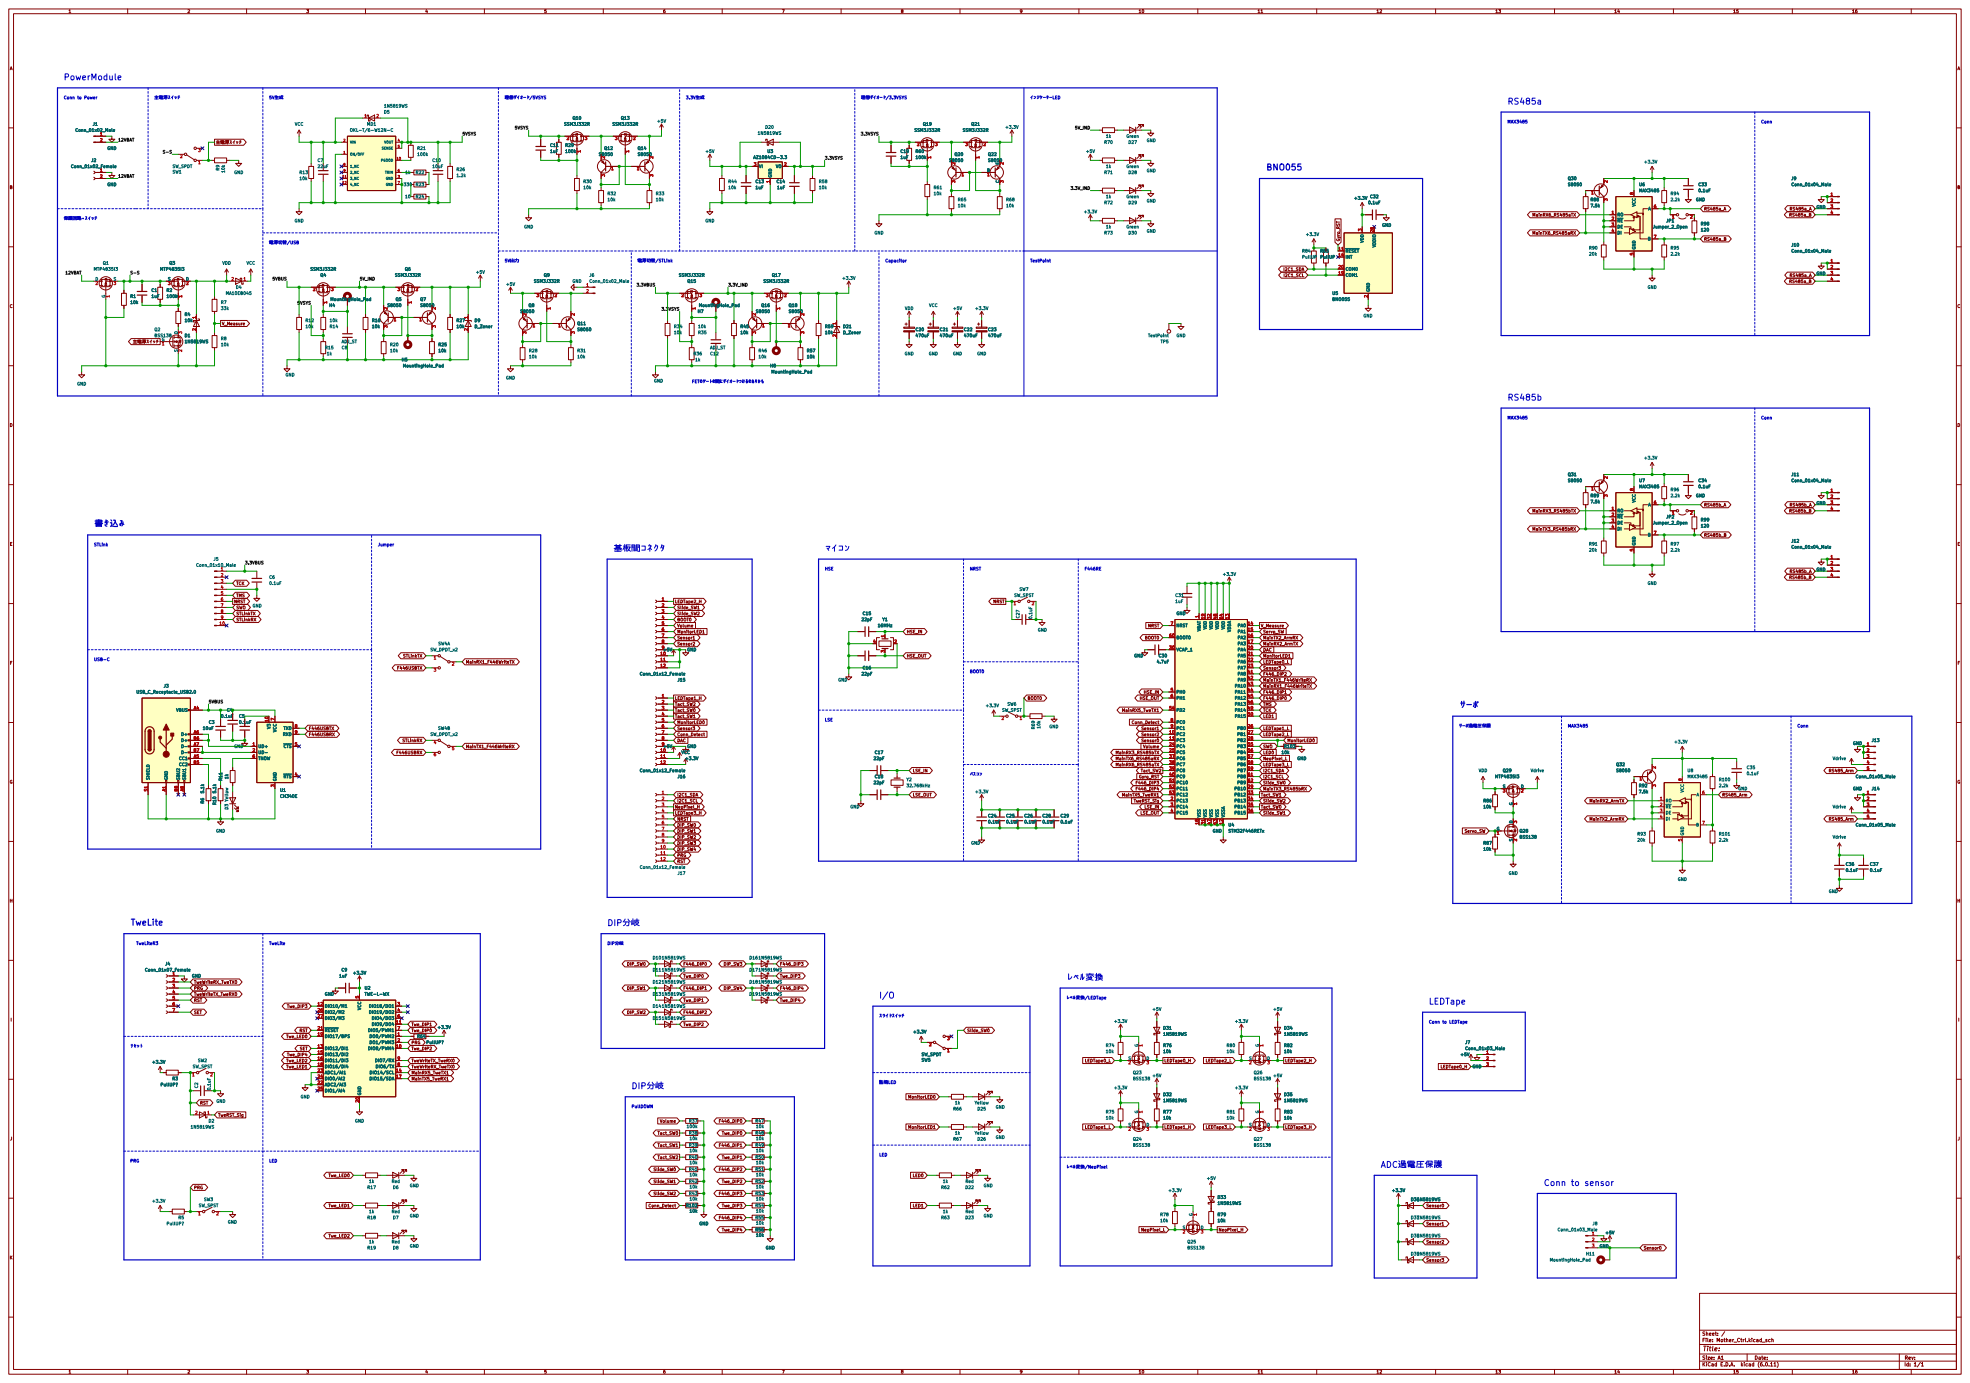
[picture p40: page 1]

5 DIO4/DO3 6 DIO5/PWM1 7 DIO6/TX 8 DIO7/RX 9 U2 GND TWE-L-WX Gyro_RST

3 ~{RTS}4 ~{CTS}5 TNOW 6 VCC

Id: 1/1 Title: File: Mother_Ctrl.kicad_sch Sheet: / +3.3V
