Tomoshibi-technology/RCJ-Japan2024-Circuit/Panel/Panel.pdf

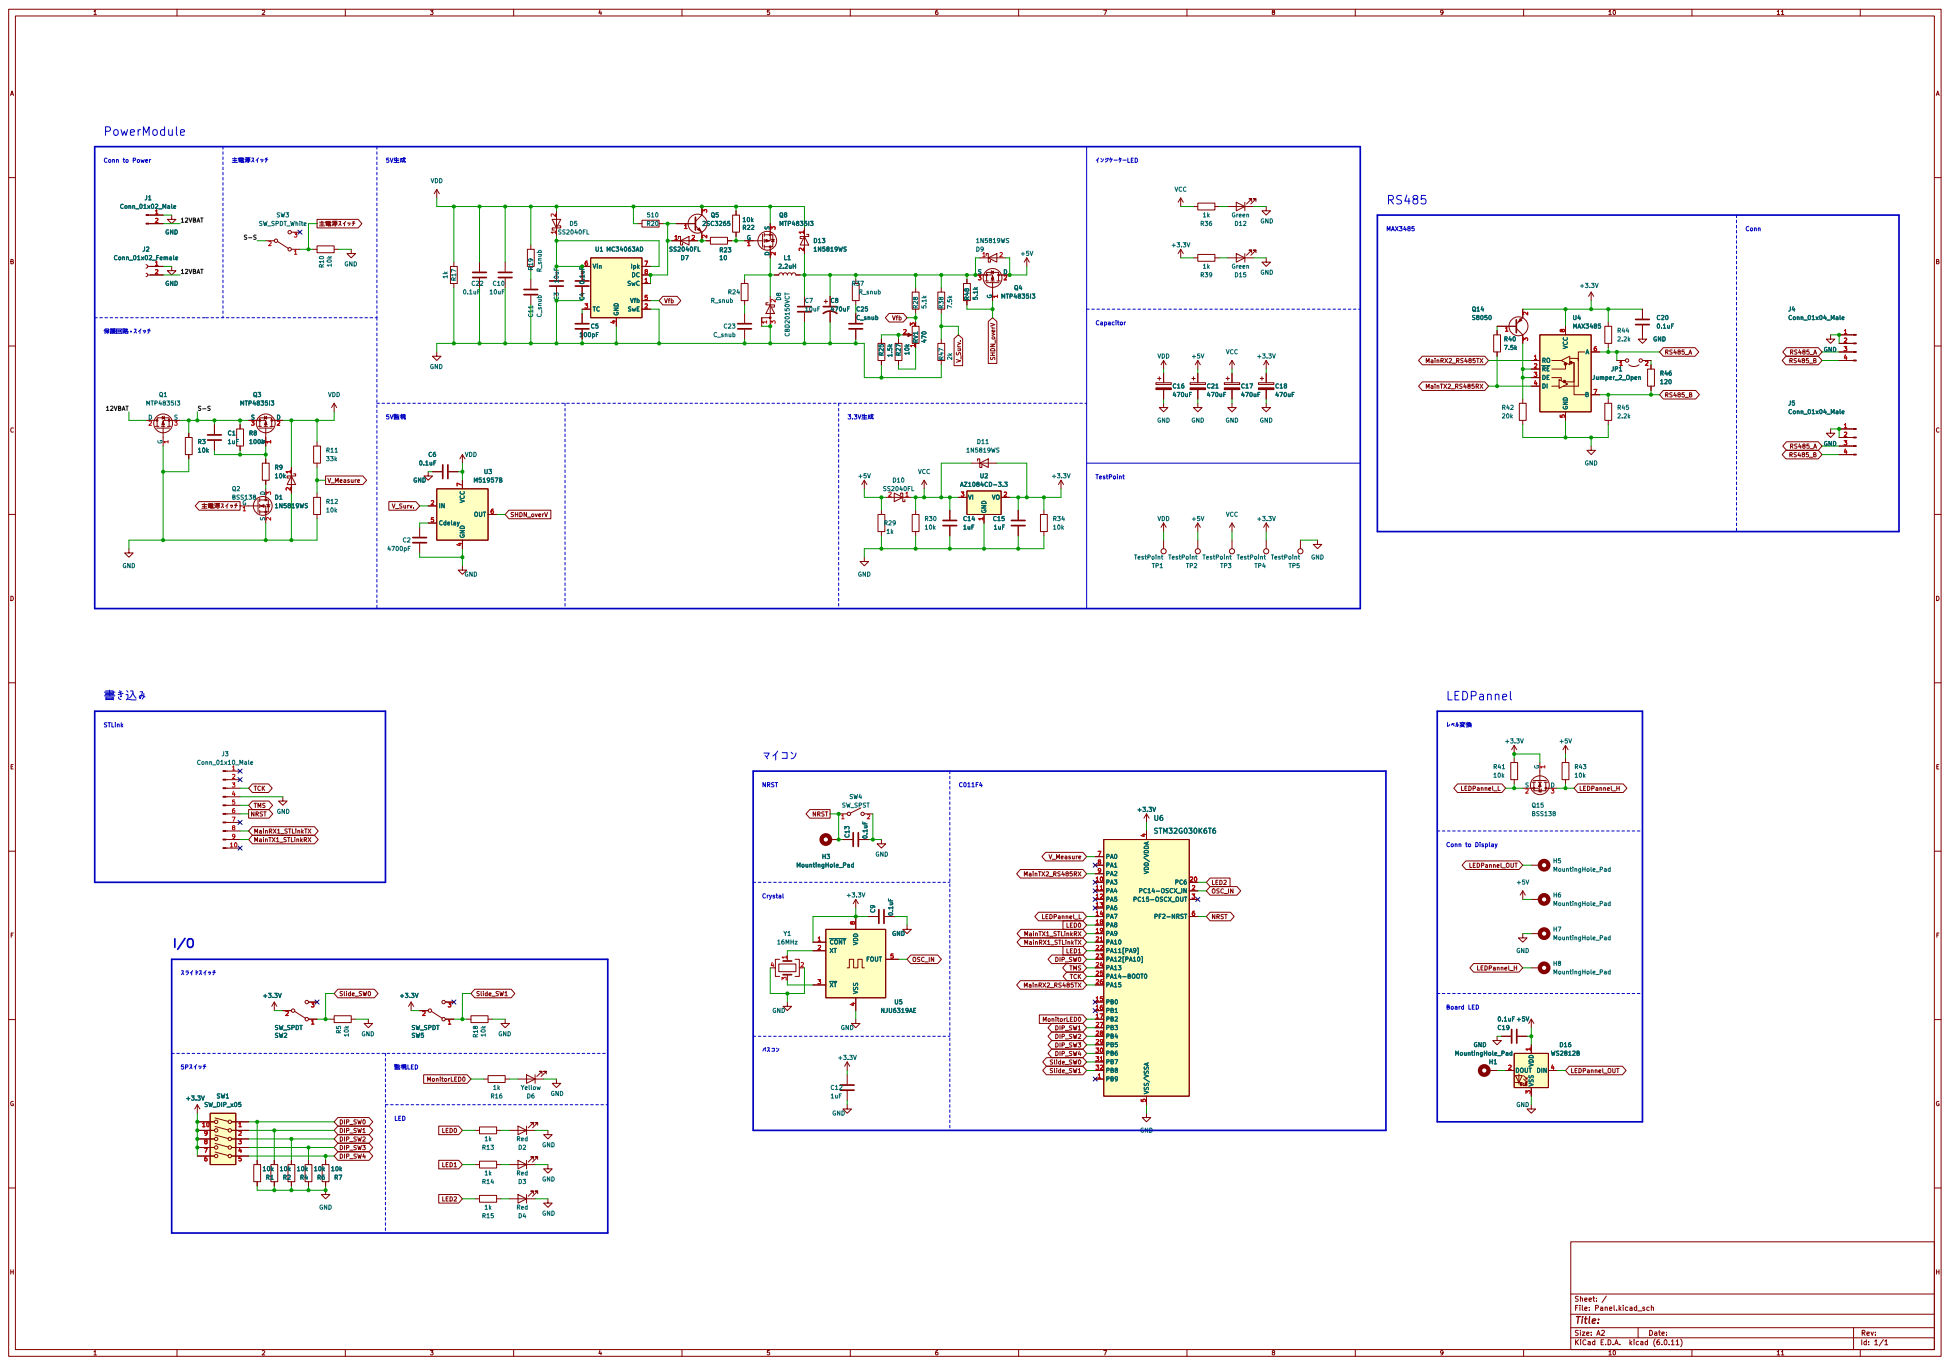
[picture p41: page 1]

Id: 1/1 Title: File: Panel.kicad_sch Sheet: /
