Tomoshibi-technology/RCJ-Japan2024-Circuit/Pole/Pole.pdf

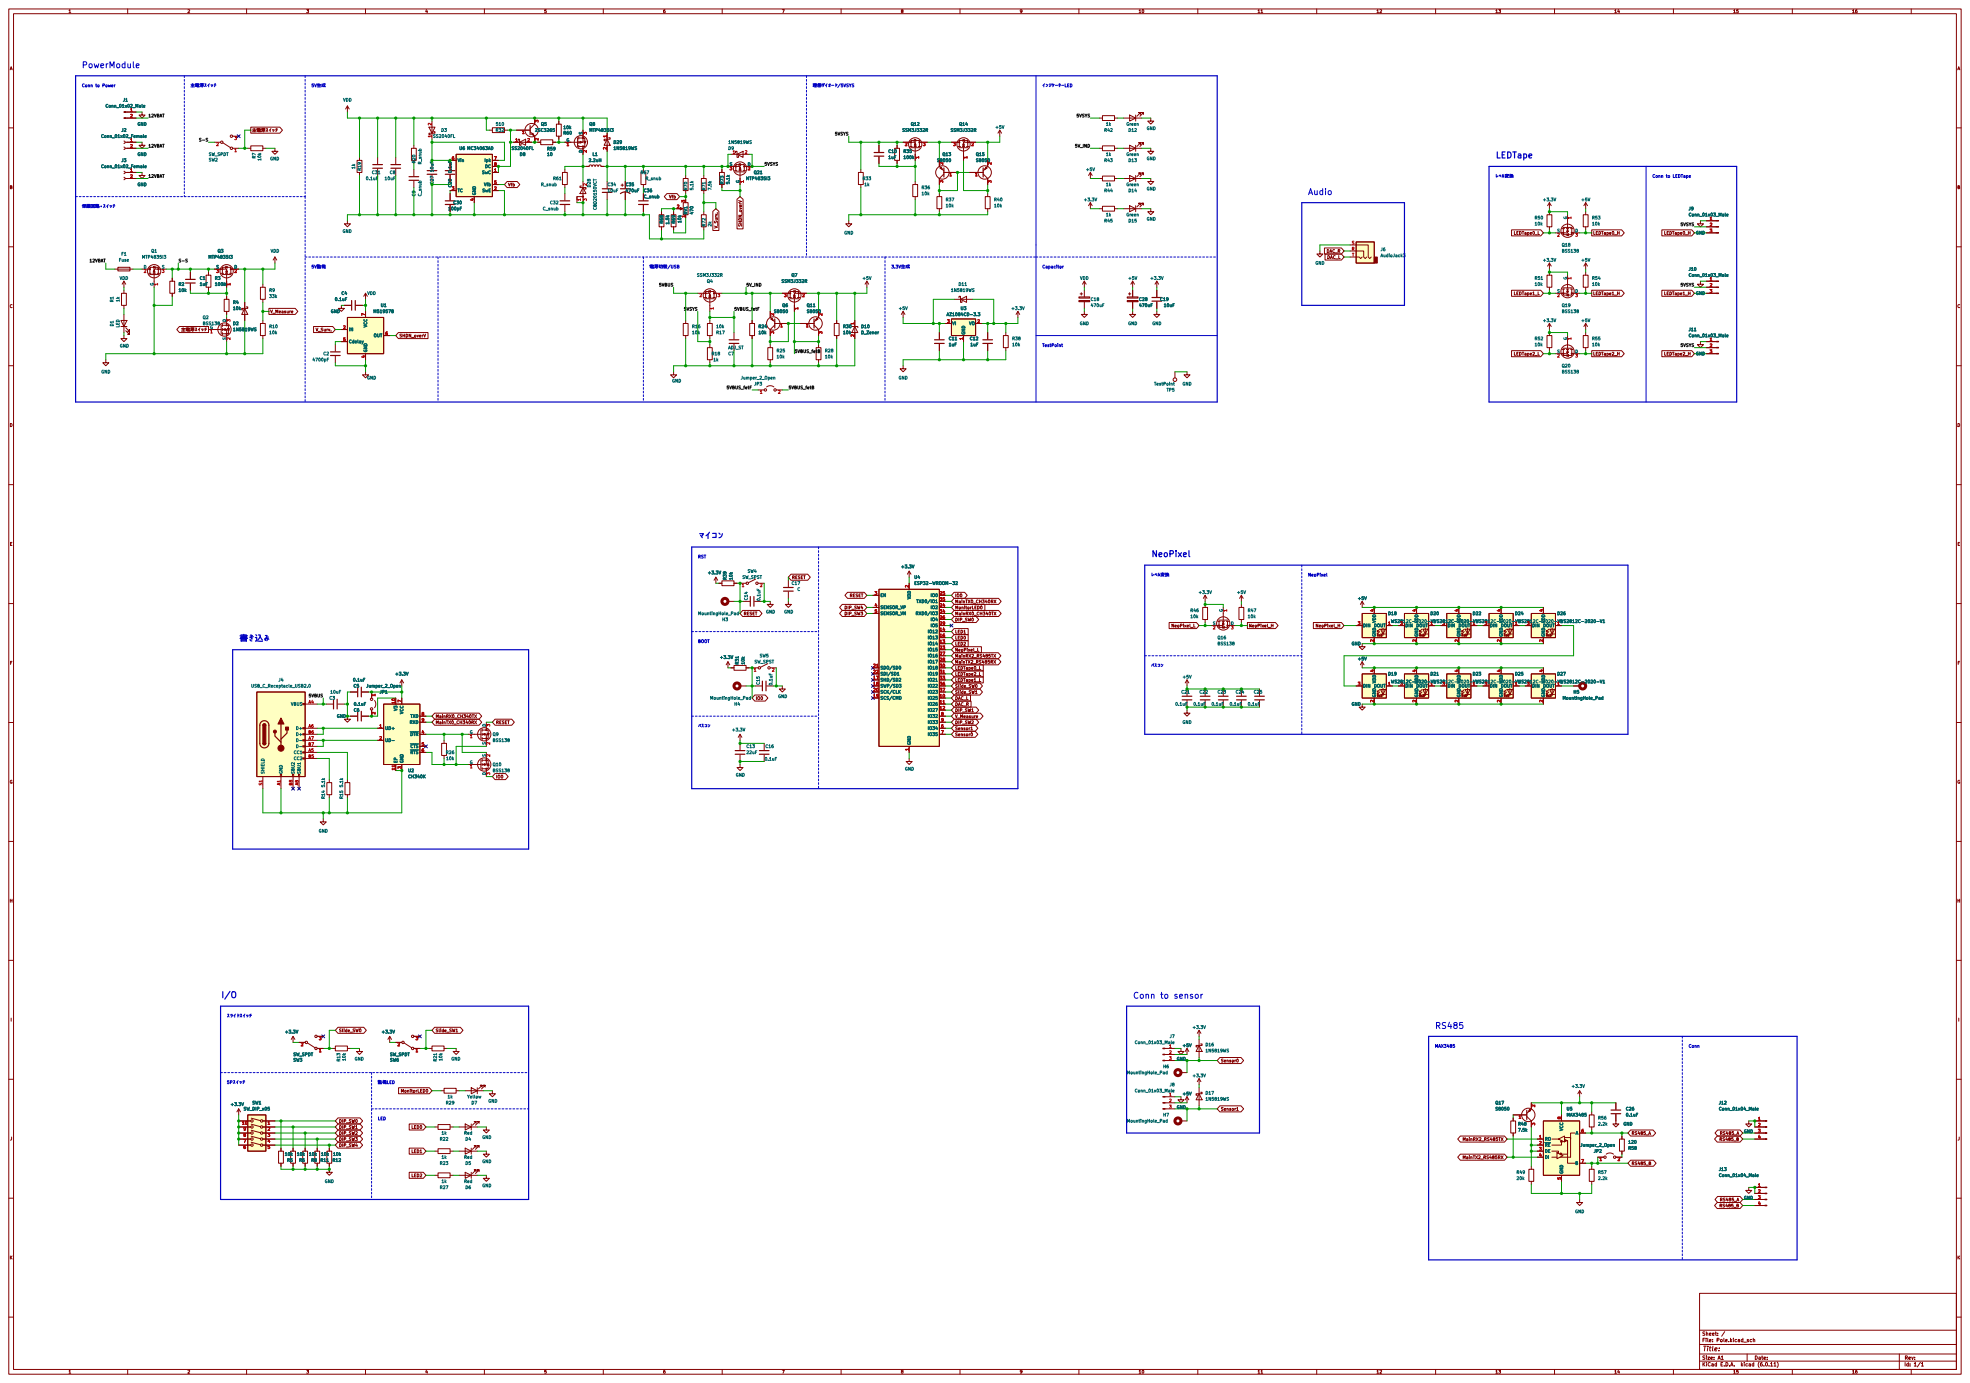
[picture p42: page 1]

Conn to Power PowerModule

3 ~{DTR}4 ~{CTS}5 ~{RTS}6 VCC
8 RXD

Id: 1/1 Title: File: Pole.kicad_sch Sheet: /
