Tomoshibi-technology/RCJ-Japan2024-Circuit/Mother_UI/Mother_UI.pdf

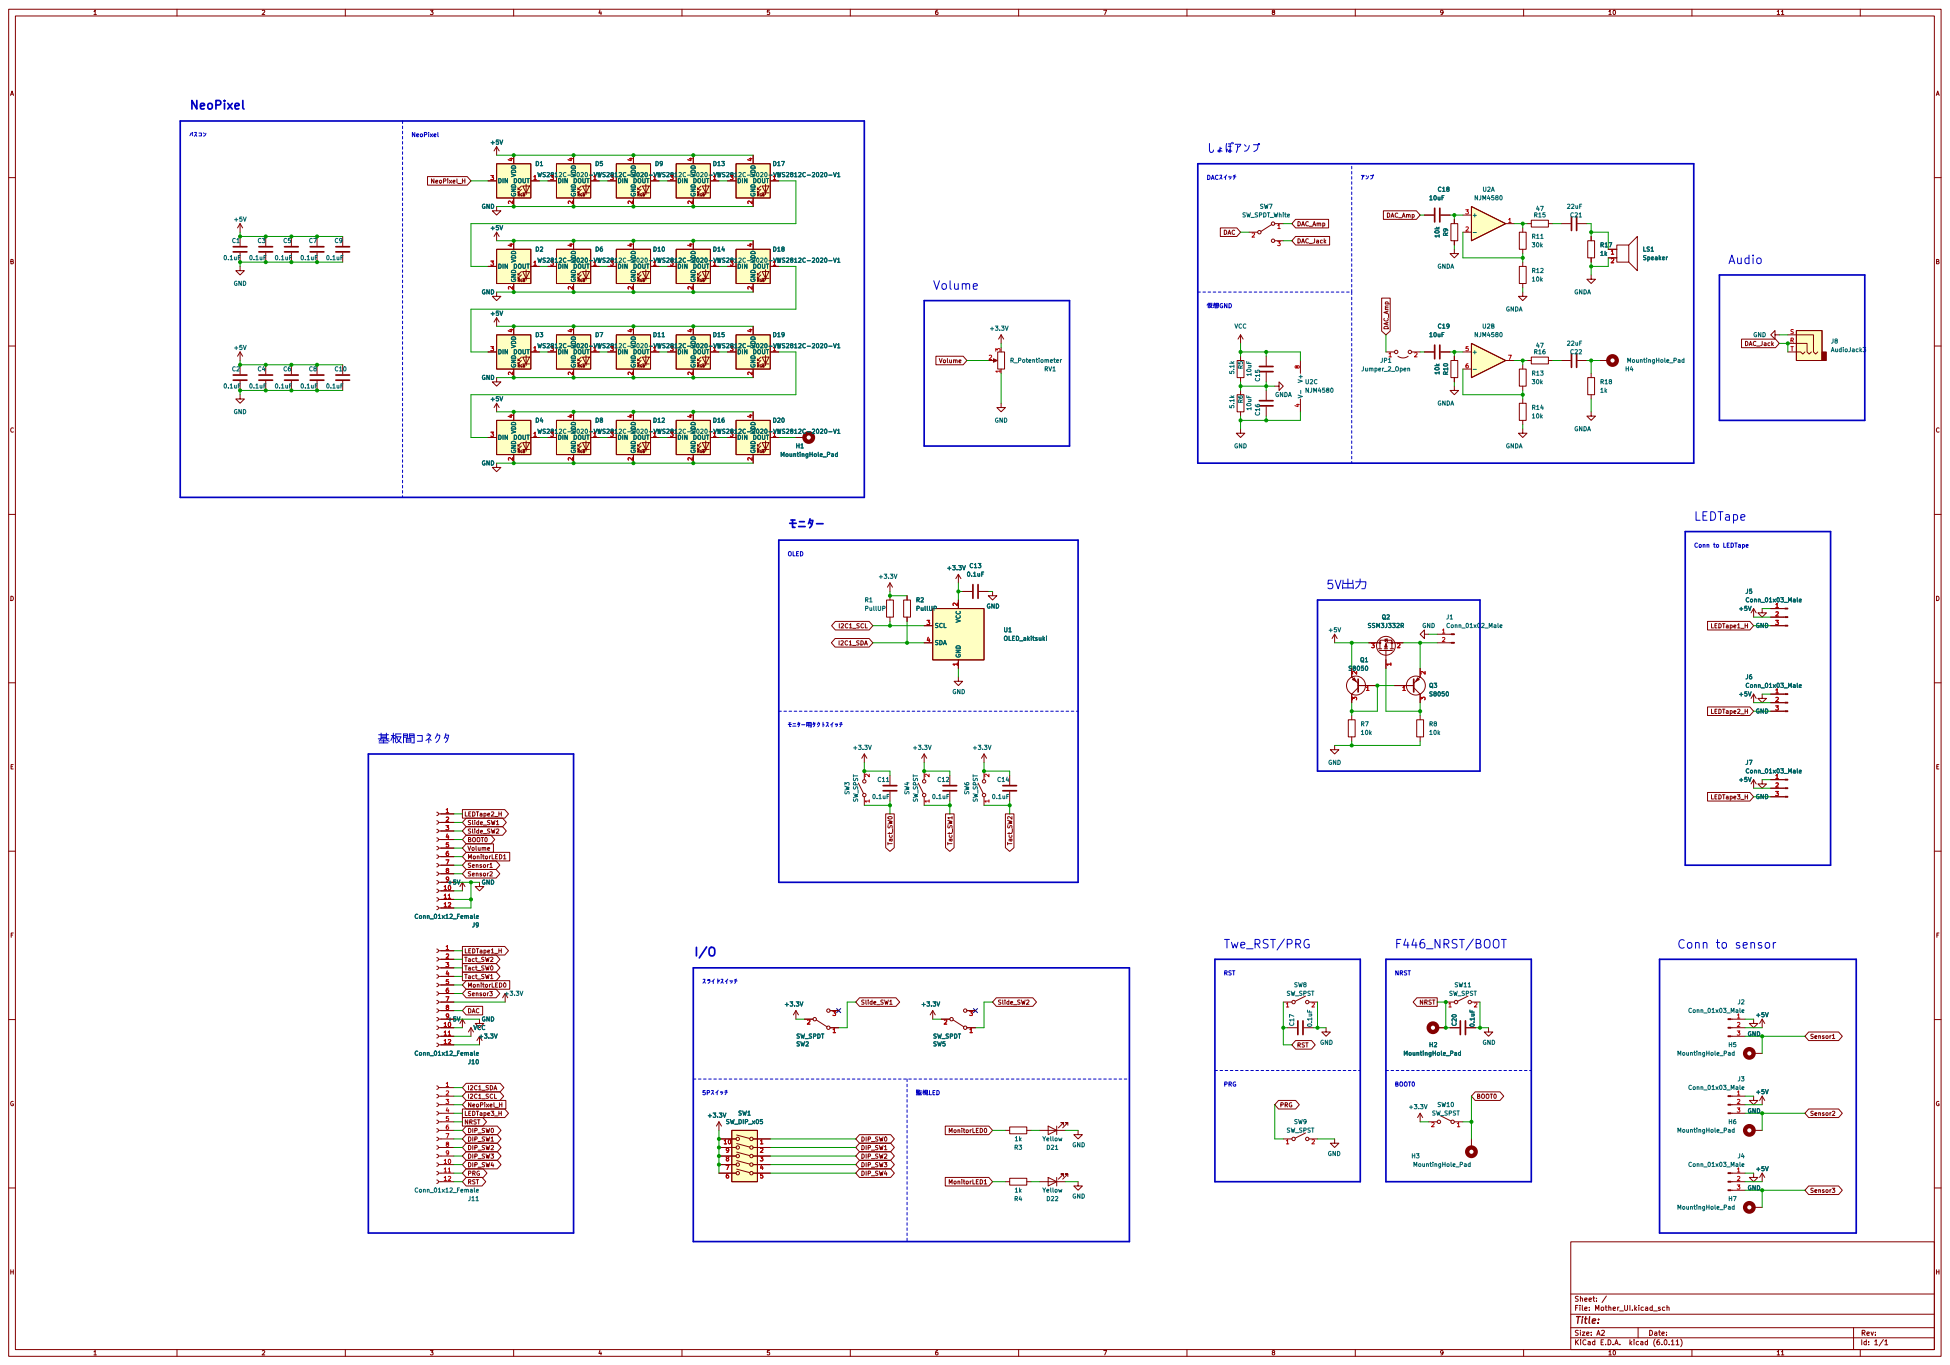
[picture p43: page 1]

þÿ0¹0é0¤0É0¹0¤0Ã0Á 3 SW2 SW_SPDT SW2 SW_SPDT 1 1 | 3 SW5 SW_SPDT 1

þÿ5P0¹0¤0Ã0Á +3.3V SW1 SW_DIP_x05 | þÿvã‰–LED D21 Yellow GND GND D22 Yellow

Id: 1/1 Title: File: Mother_UI.kicad_sch Sheet: /
