Tomoshibi-technology/RCJ-Japan2024-Circuit/Encoder/Encoder.pdf

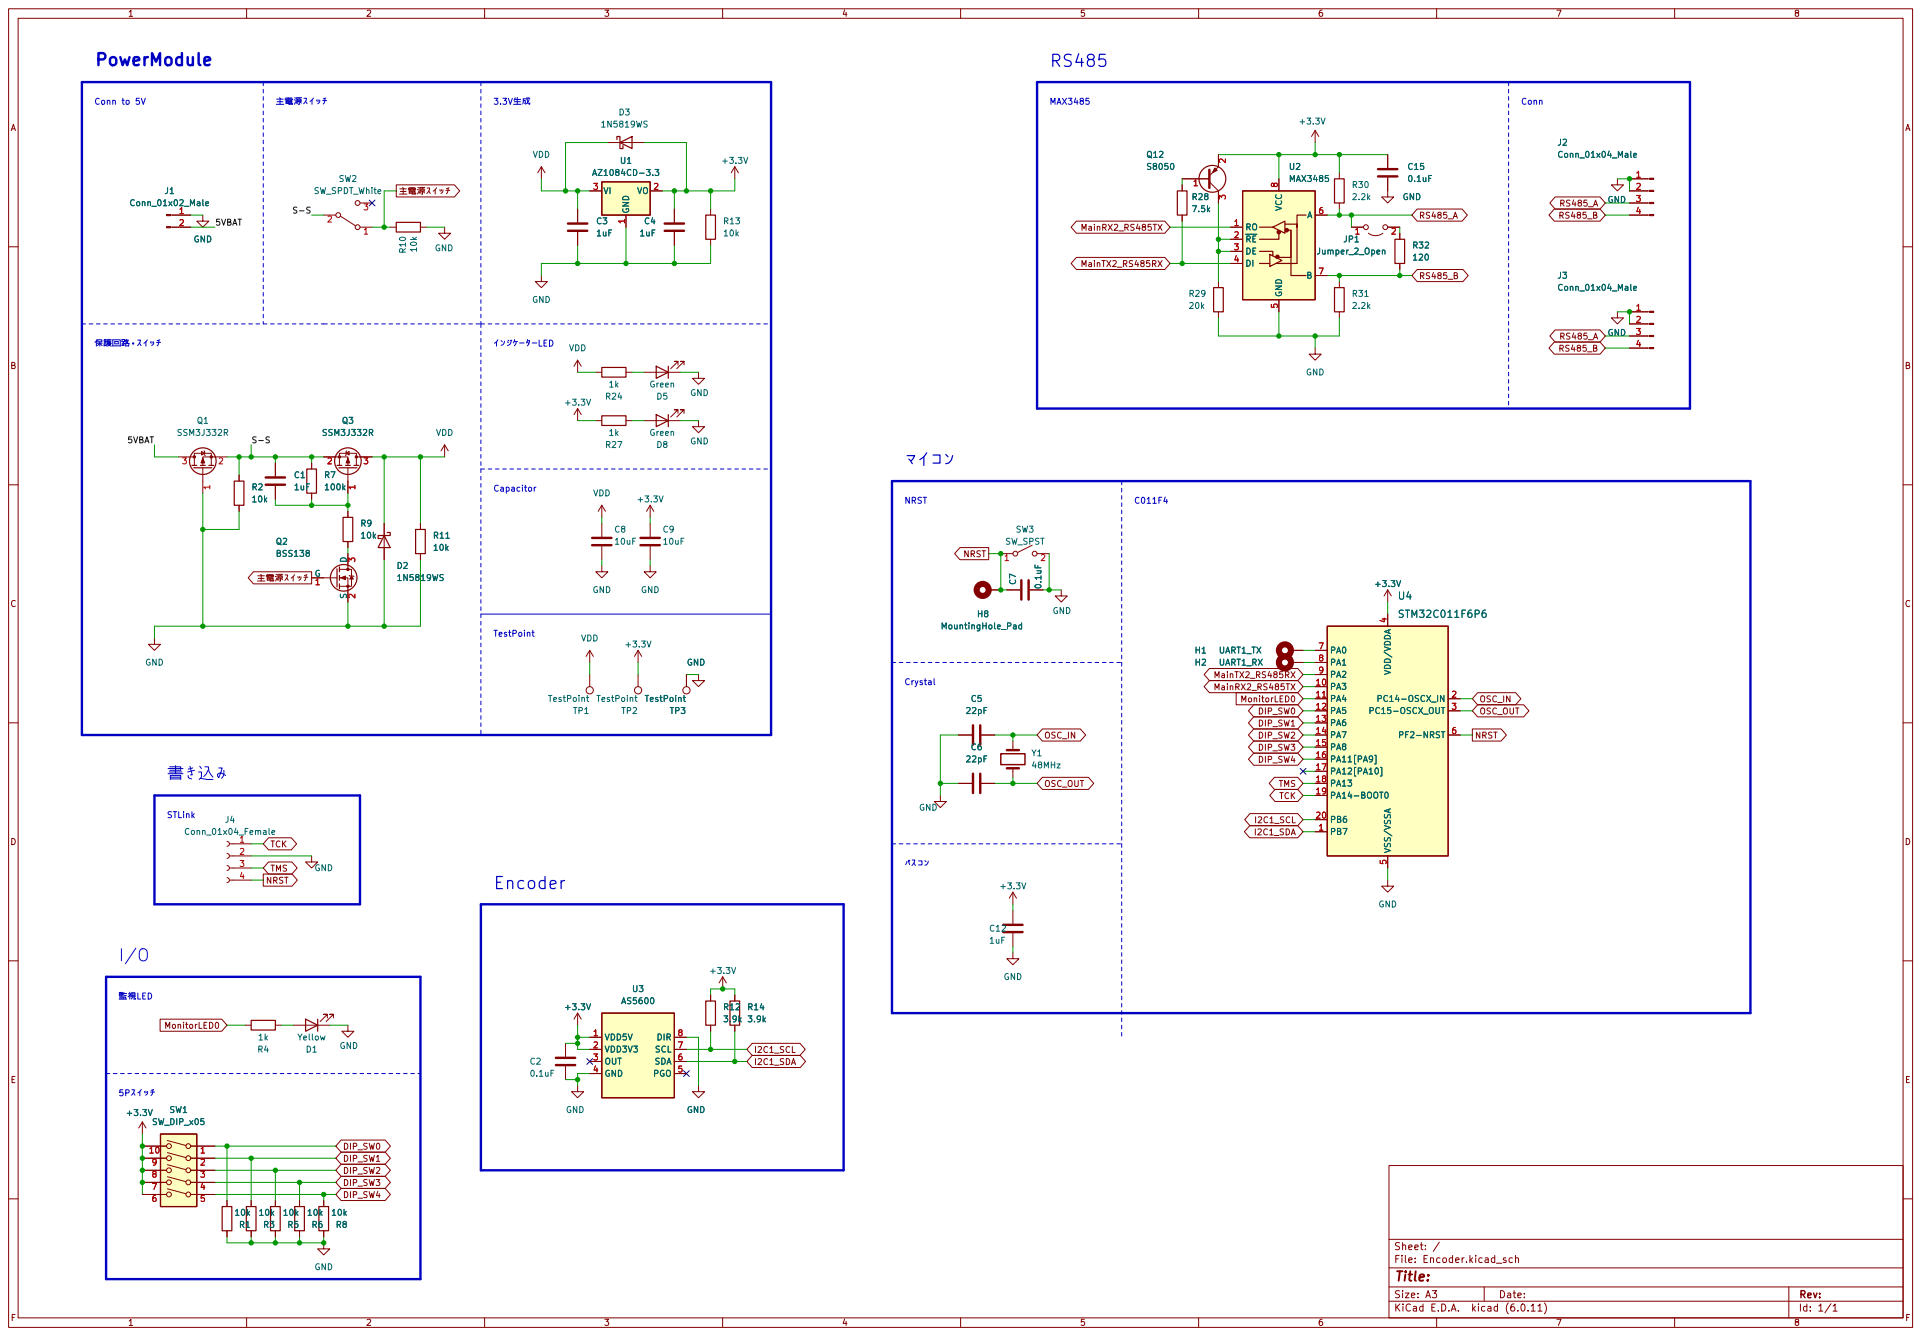
[picture p44: page 1]

þÿOÝ‹wVÞ•ï0û0¹0¤0Ã0Á Conn to 5V

þÿvã‰–LED
