Tomoshibi-technology/RCJ-Japan2024-Circuit/IR/IR.pdf

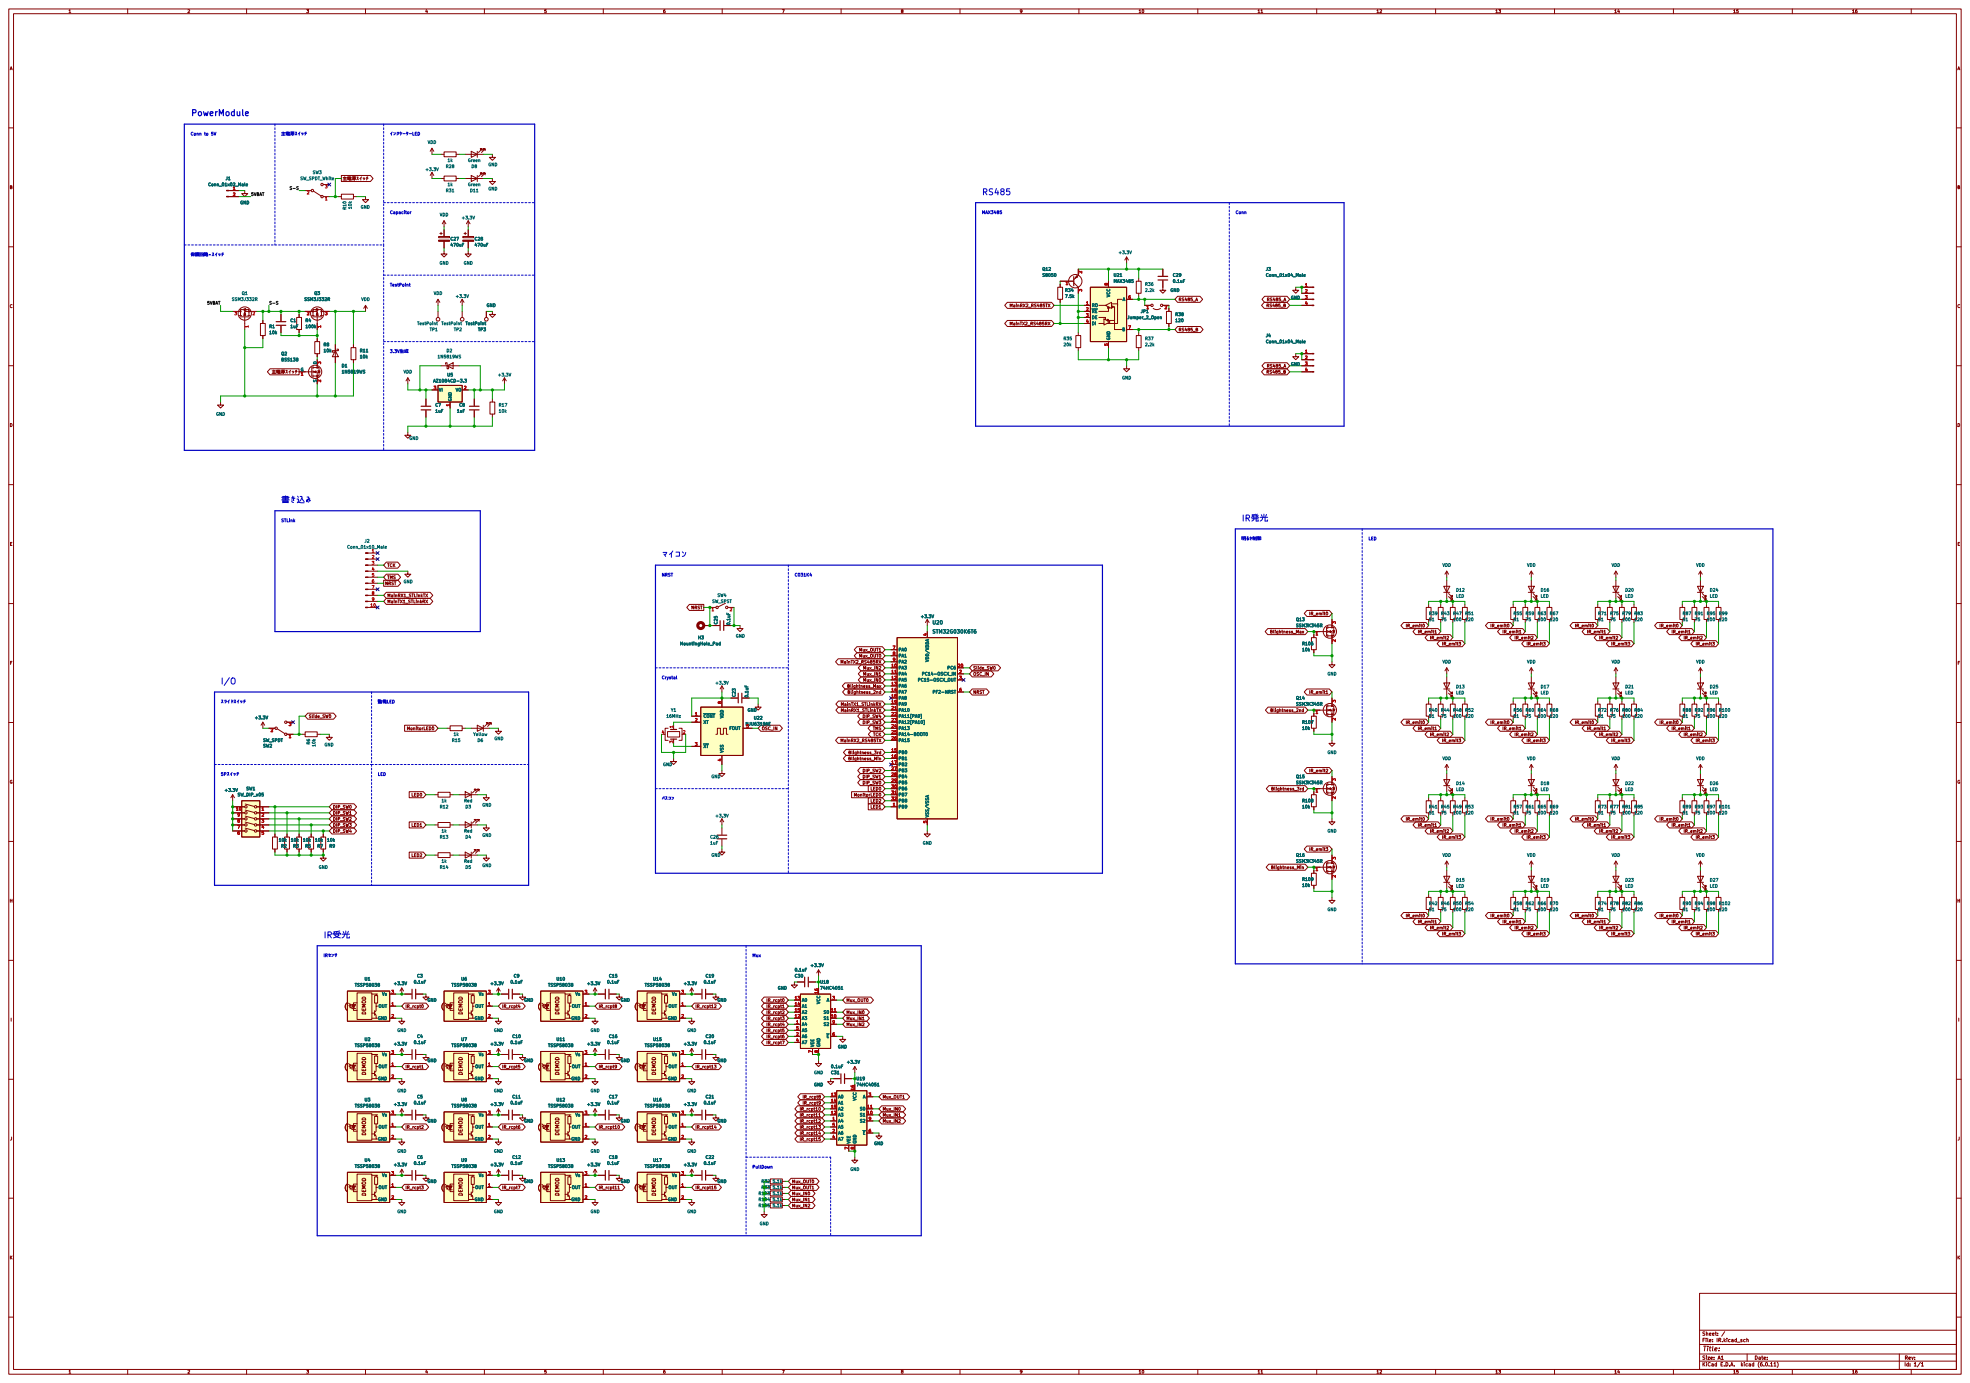
[picture p45: page 1]

IR_emit3 Slide_SW0
LED þÿIRS×QI
