Tomoshibi-technology/RCJ-Japan2024-Circuit/LargePW/LargePW.pdf

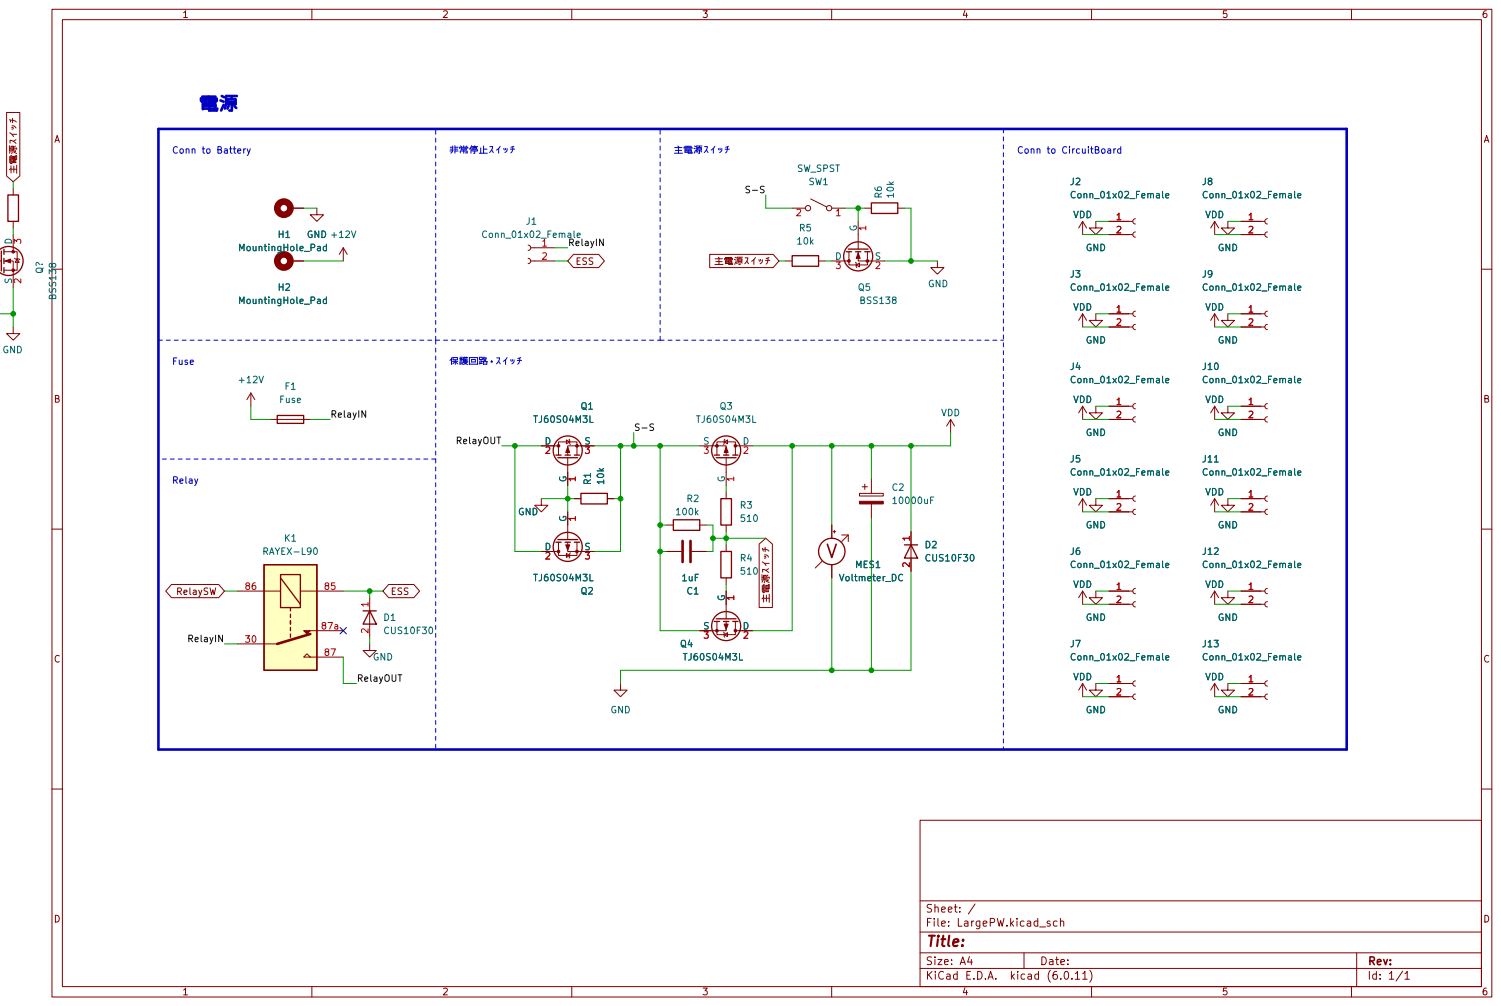
[picture p46: page 1]

Conn to Battery | þÿ—^^8P\kb0¹0¤0Ã0Á 1 2 | 10k G

+12V | | | J13 Conn_01x02_Female VDD GND G J3Conn_01x02_Female R3
