Tomoshibi-technology/RCJ-Japan2024-Circuit/SmallMD/SmallMD.pdf

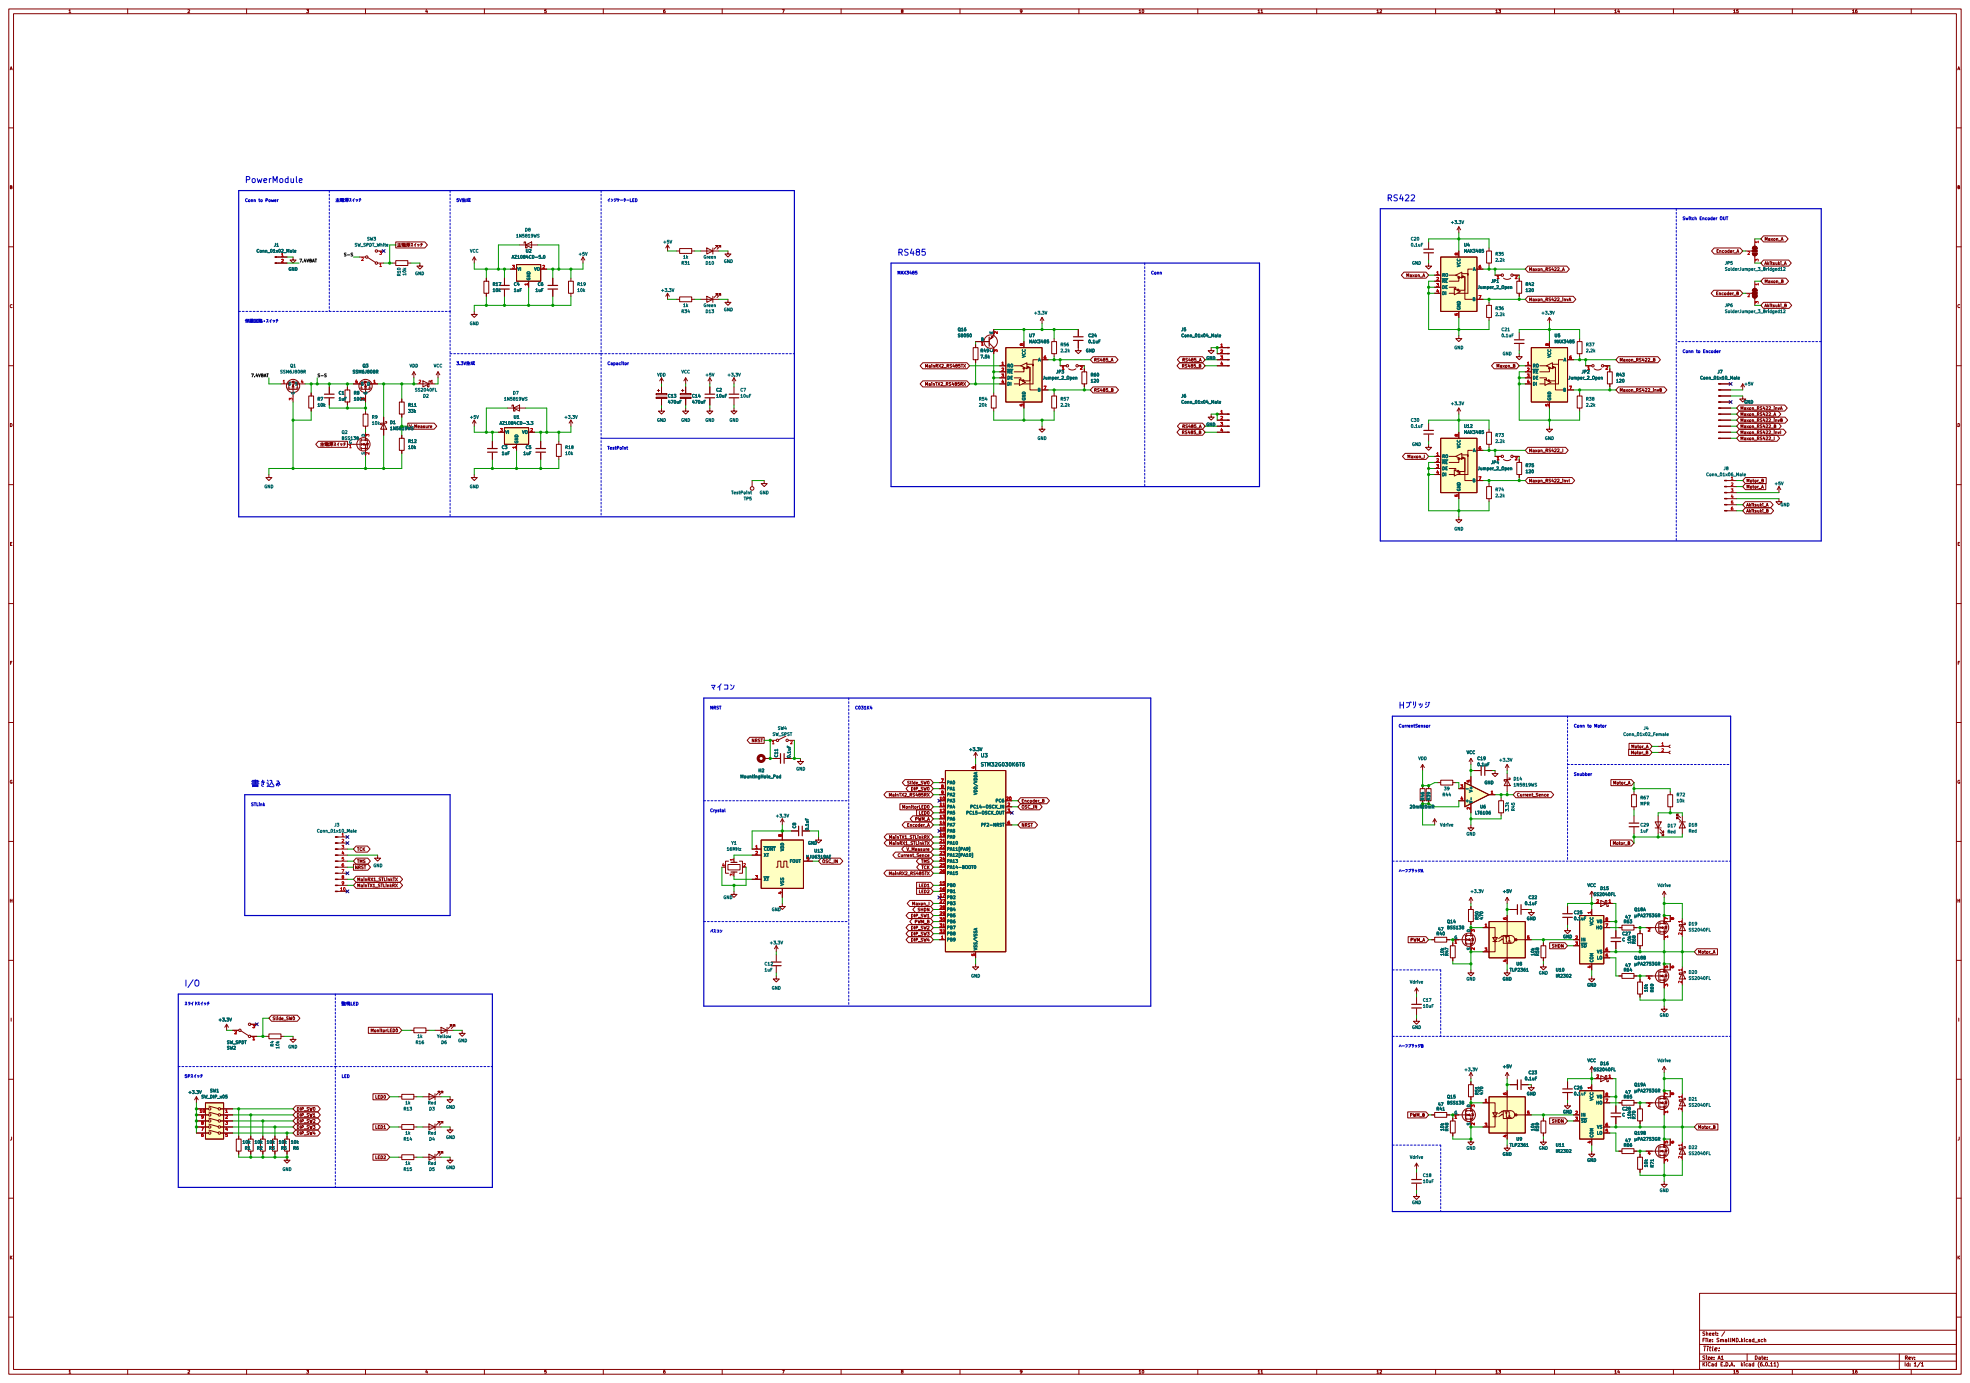
[picture p47: page 1]

Switch Encoder OUT Conn to Encoder RS422
2.2k +3.3V GND

Conn to Motor Snubber þÿvã‰–LED

Id: 1/1 Title: File: SmallMD.kicad_sch Sheet: /
