Tomoshibi-technology/RCJ-Japan2024-Circuit/SmallPW/SmallPW.pdf

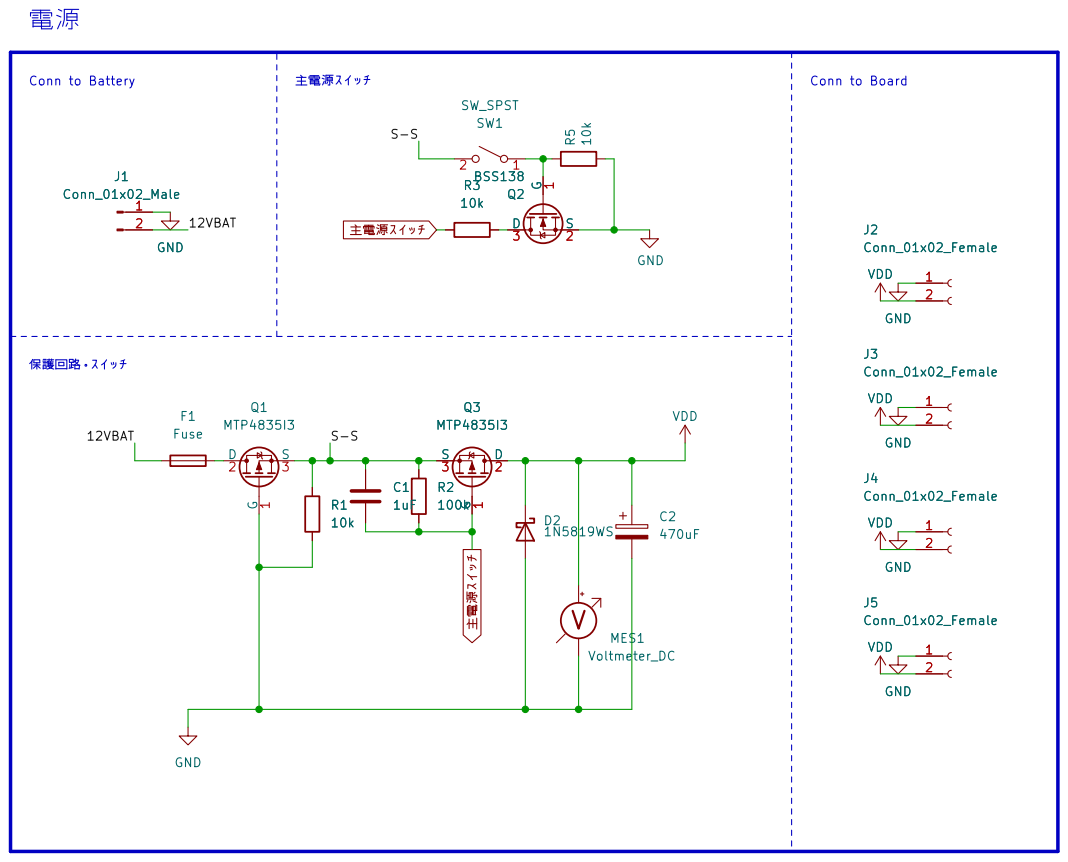
[picture p48: page 1]

Id: 1/1 Title: File: SmallPW.kicad_sch Sheet: /
