Tomoshibi-technology/RCJ-Japan2024-Circuit/LargeMD/LargeMD.pdf

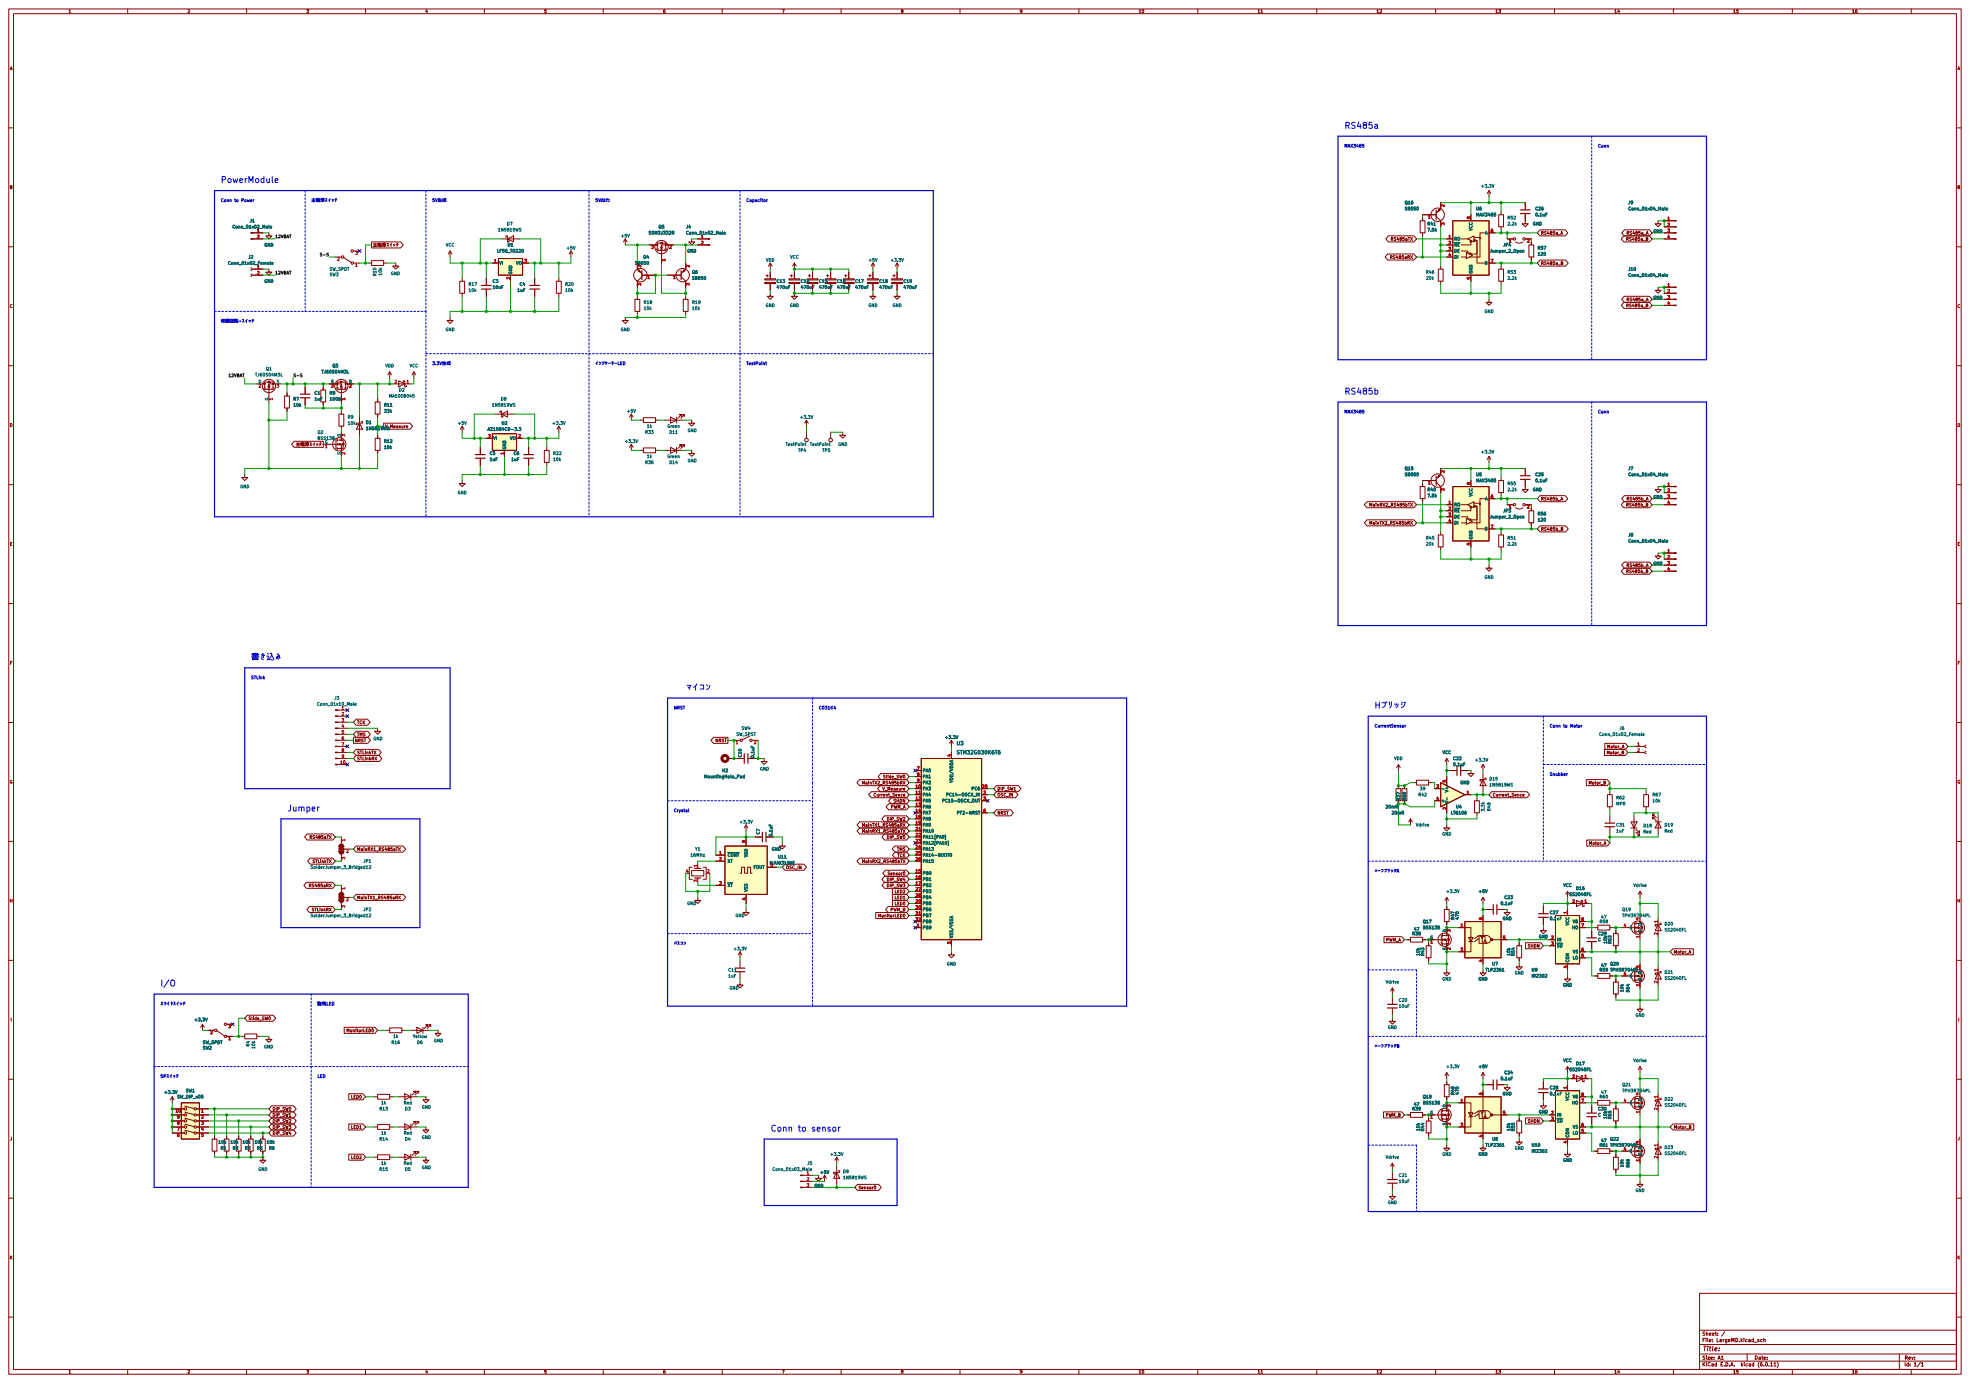
[picture p49: page 1]
