Tomoshibi-technology/RCJ-Japan2024-Circuit/LargePW/LargePW.kicad_pcb

## KiCad design LargePW/LargePW.kicad_pcb (2024-02-28)

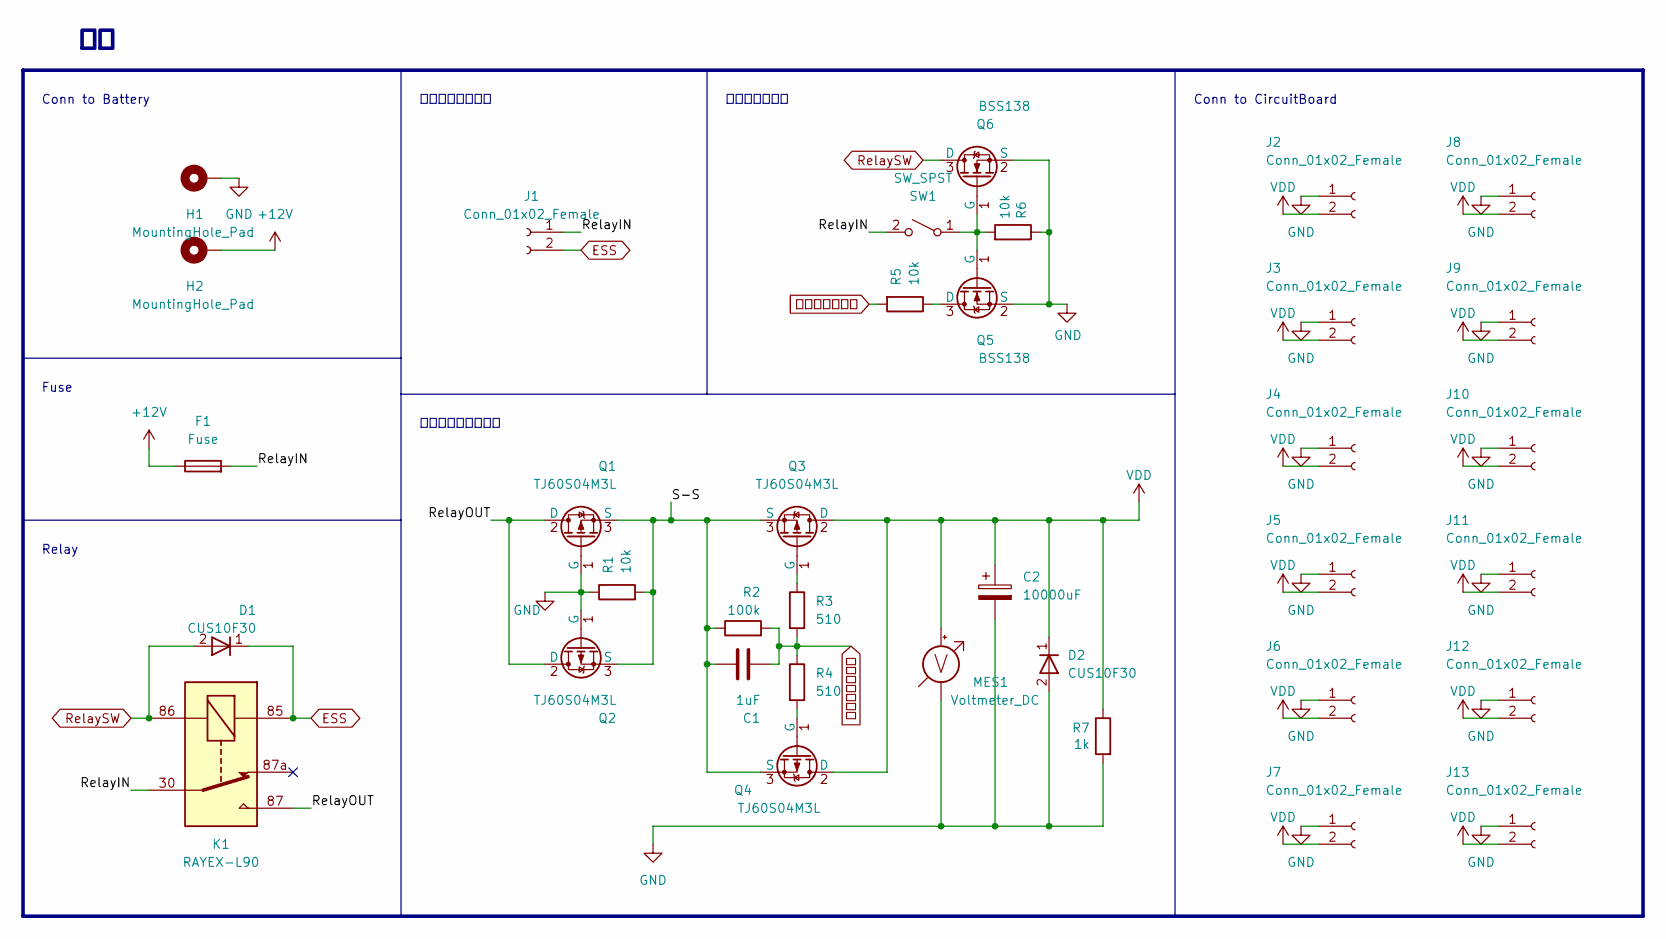
[picture p56: schematic LargePW.kicad_sch]

Parts:
C1: 1uF; C_0603_1608Metric_Pad1.08x0.95mm_HandSolder
C2: 10000uF; CP_Radial_D35.0mm_P10.00mm_SnapIn
D1, D2: CUS10F30; D_SOD-323_HandSoldering
F1: Fuse; Fuseholder_Blade_Mini_Keystone_3568
H1, H2: MountingHole_Pad; TestPoint_THTPad_D4.0mm_Drill2.0mm
J1: Conn_01x02_Female; Molex_SPOX_5267-02A_1x02_P2.50mm_Vertical
J2, J3, J4, J5, J6, J7, J8, J9, J10, J11, J12, J13: Conn_01x02_Female; AMASS_XT30U-F_1x02_P5.0mm_Vertical
K1: RAYEX-L90; TRV4-L-12V-Z-F
MES1: Voltmeter_DC; SuperSmallVoltmeter_twoline
Q1, Q2, Q3, Q4: TJ60S04M3L; TO-252-2
Q5, Q6: BSS138; SOT-23_Handsoldering
R1, R5, R6: 10k; R_0603_1608Metric_Pad0.98x0.95mm_HandSolder
R2: 100k; R_0603_1608Metric_Pad0.98x0.95mm_HandSolder
R3, R4: 510; R_0603_1608Metric_Pad0.98x0.95mm_HandSolder
R7: 1k; R_0603_1608Metric_Pad0.98x0.95mm_HandSolder
SW1: SW_SPST; DS-850K-S-ON

Connections:
+12V: F1.1, H2.1
/RelayIN: F1.2, J1.1, K1.30, SW1.2 (B)
/RelayOUT: K1.87, Q1.2 (D), Q2.2 (D)
/S-S: C1.1, Q1.3 (S), Q2.3 (S), Q3.3 (S), Q4.3 (S), R1.2, R2.1
ESS: D1.1 (K), J1.2, K1.85
GND: C2.2, D2.2 (A), H1.1, J2.1, J3.1, J4.1, J5.1, J6.1, J7.1, J8.1, J9.1, J10.1, J11.1, J12.1, J13.1, MES1.1 (-), Q1.1 (G), Q2.1 (G), Q5.2 (S), Q6.2 (S), R1.1, R6.1, R7.2
unnamed: Q3.1 (G), R3.1
unnamed: Q4.1 (G), R4.2
unnamed: Q5.1 (G), Q6.1 (G), R6.2, SW1.1 (A)
unnamed: Q5.3 (D), R5.1
RelaySW: D1.2 (A), K1.86, Q6.3 (D)
VDD: C2.1, D2.1 (K), J2.2, J3.2, J4.2, J5.2, J6.2, J7.2, J8.2, J9.2, J10.2, J11.2, J12.2, J13.2, MES1.2 (+), Q3.2 (D), Q4.2 (D), R7.1
主電源スイッチ: C1.2, R2.2, R3.2, R4.1, R5.2

Notes on the sheet:
Conn to Battery
保護回路・スイッチ
Conn to CircuitBoard
主電源スイッチ
Fuse
Relay
非常停止スイッチ

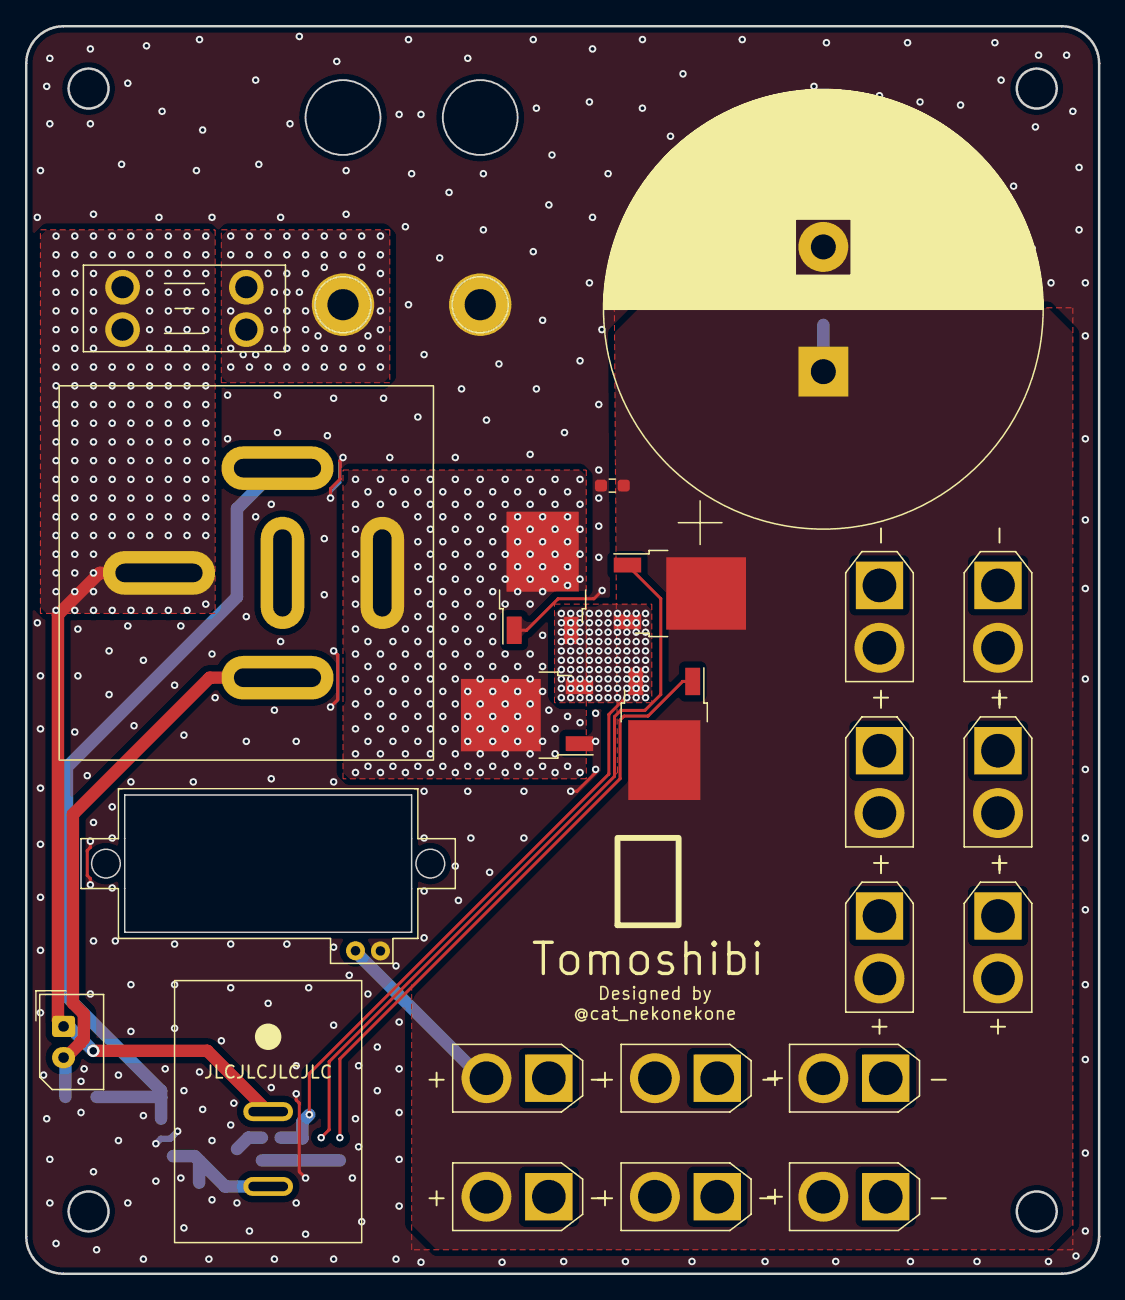
[picture p57: board LargePW.kicad_pcb from above]

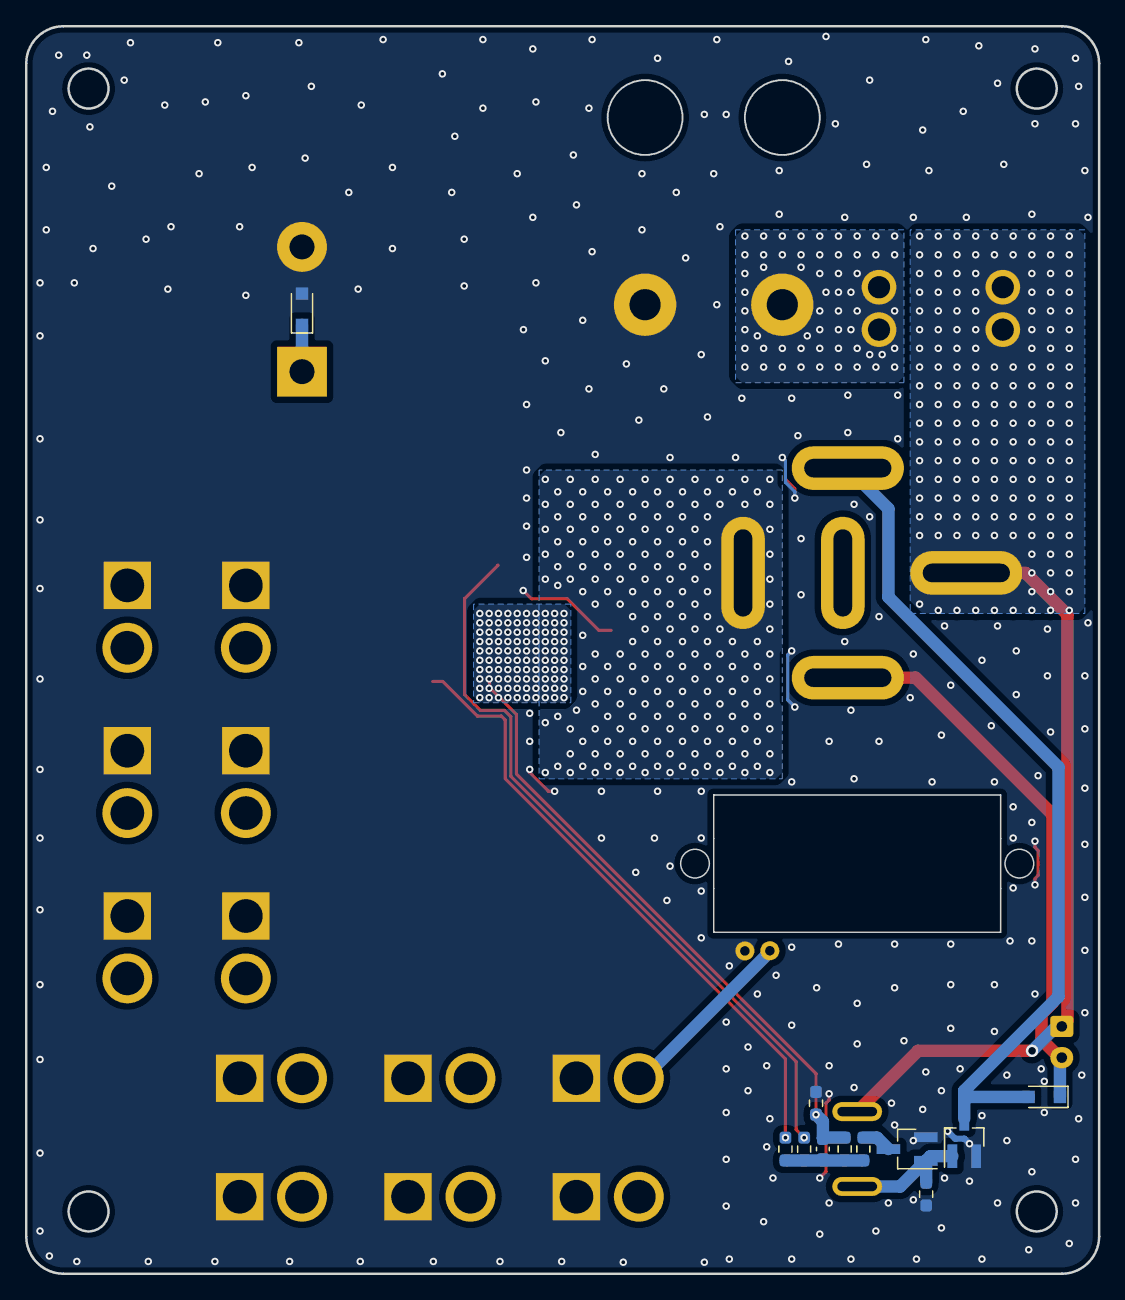
[picture p58: board LargePW.kicad_pcb from below]

Board: 2 copper layers, 86.0 x 100.0 mm, 36 parts (11 on the bottom side), 13 nets.
