Tomoshibi-technology/RCJ-Japan2024-Circuit/Pole/Pole.kicad_pcb

## KiCad design Pole/Pole.kicad_pcb (continued)

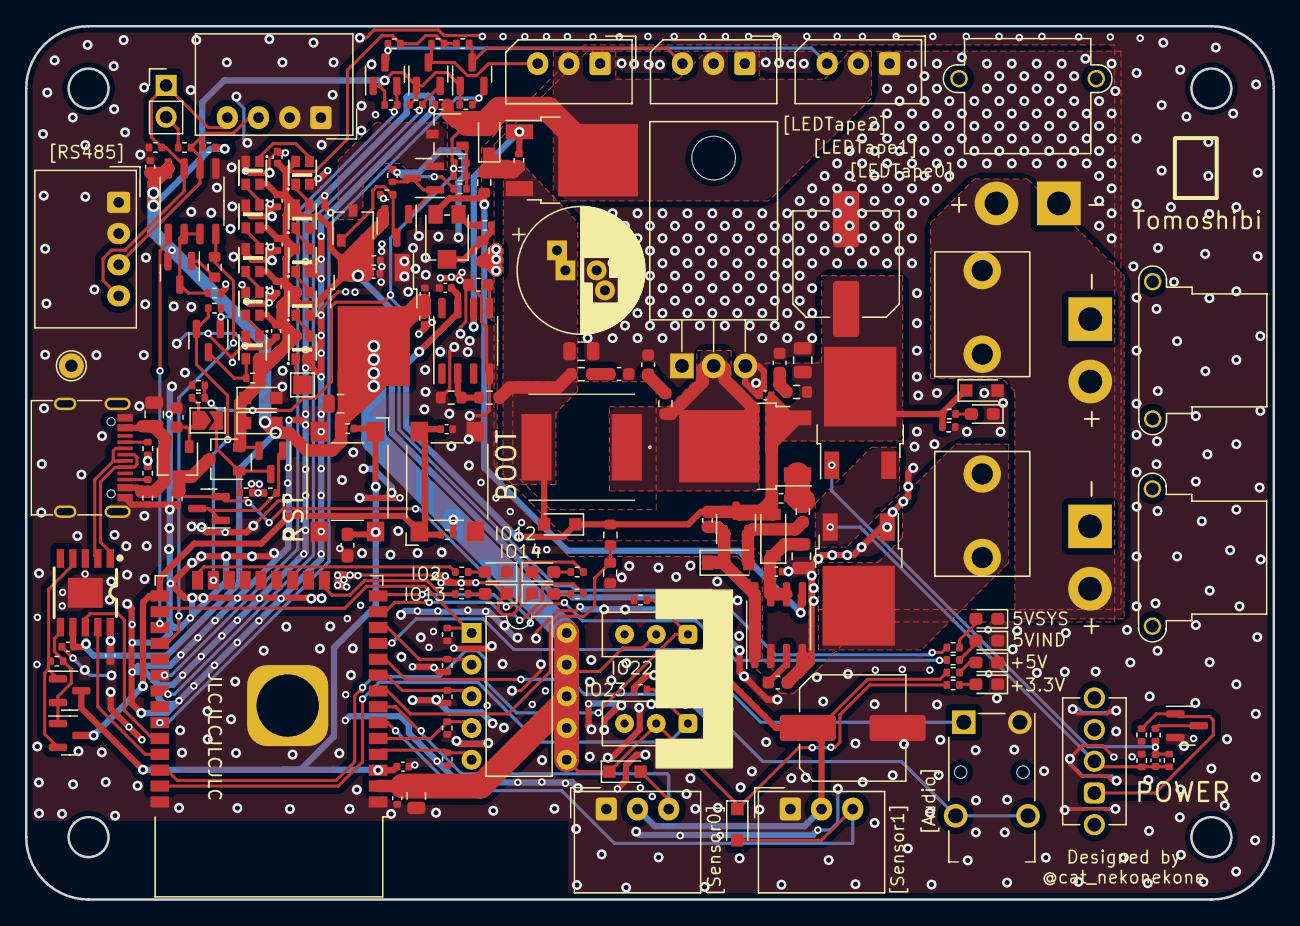
[picture p63: board Pole.kicad_pcb from above]

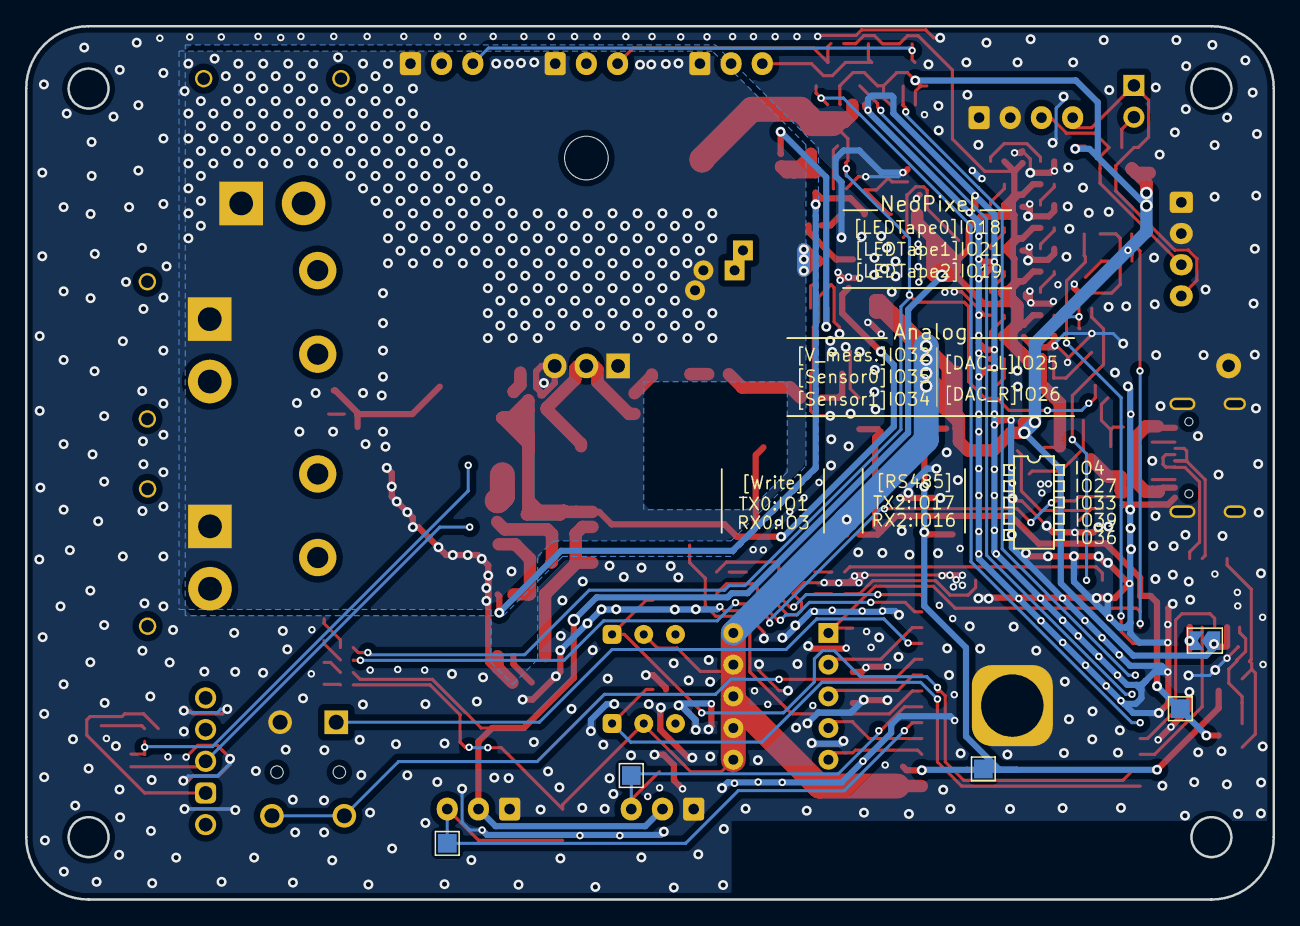
[picture p64: board Pole.kicad_pcb from below]

Board: 2 copper layers, 100.0 x 70.0 mm, 186 parts (5 on the bottom side), 97 nets.
