Tomoshibi-technology/RCJ-Japan2024-Circuit/Mother_UI/Mother_UI.kicad_pcb

## KiCad design Mother_UI/Mother_UI.kicad_pcb (2024-02-28)

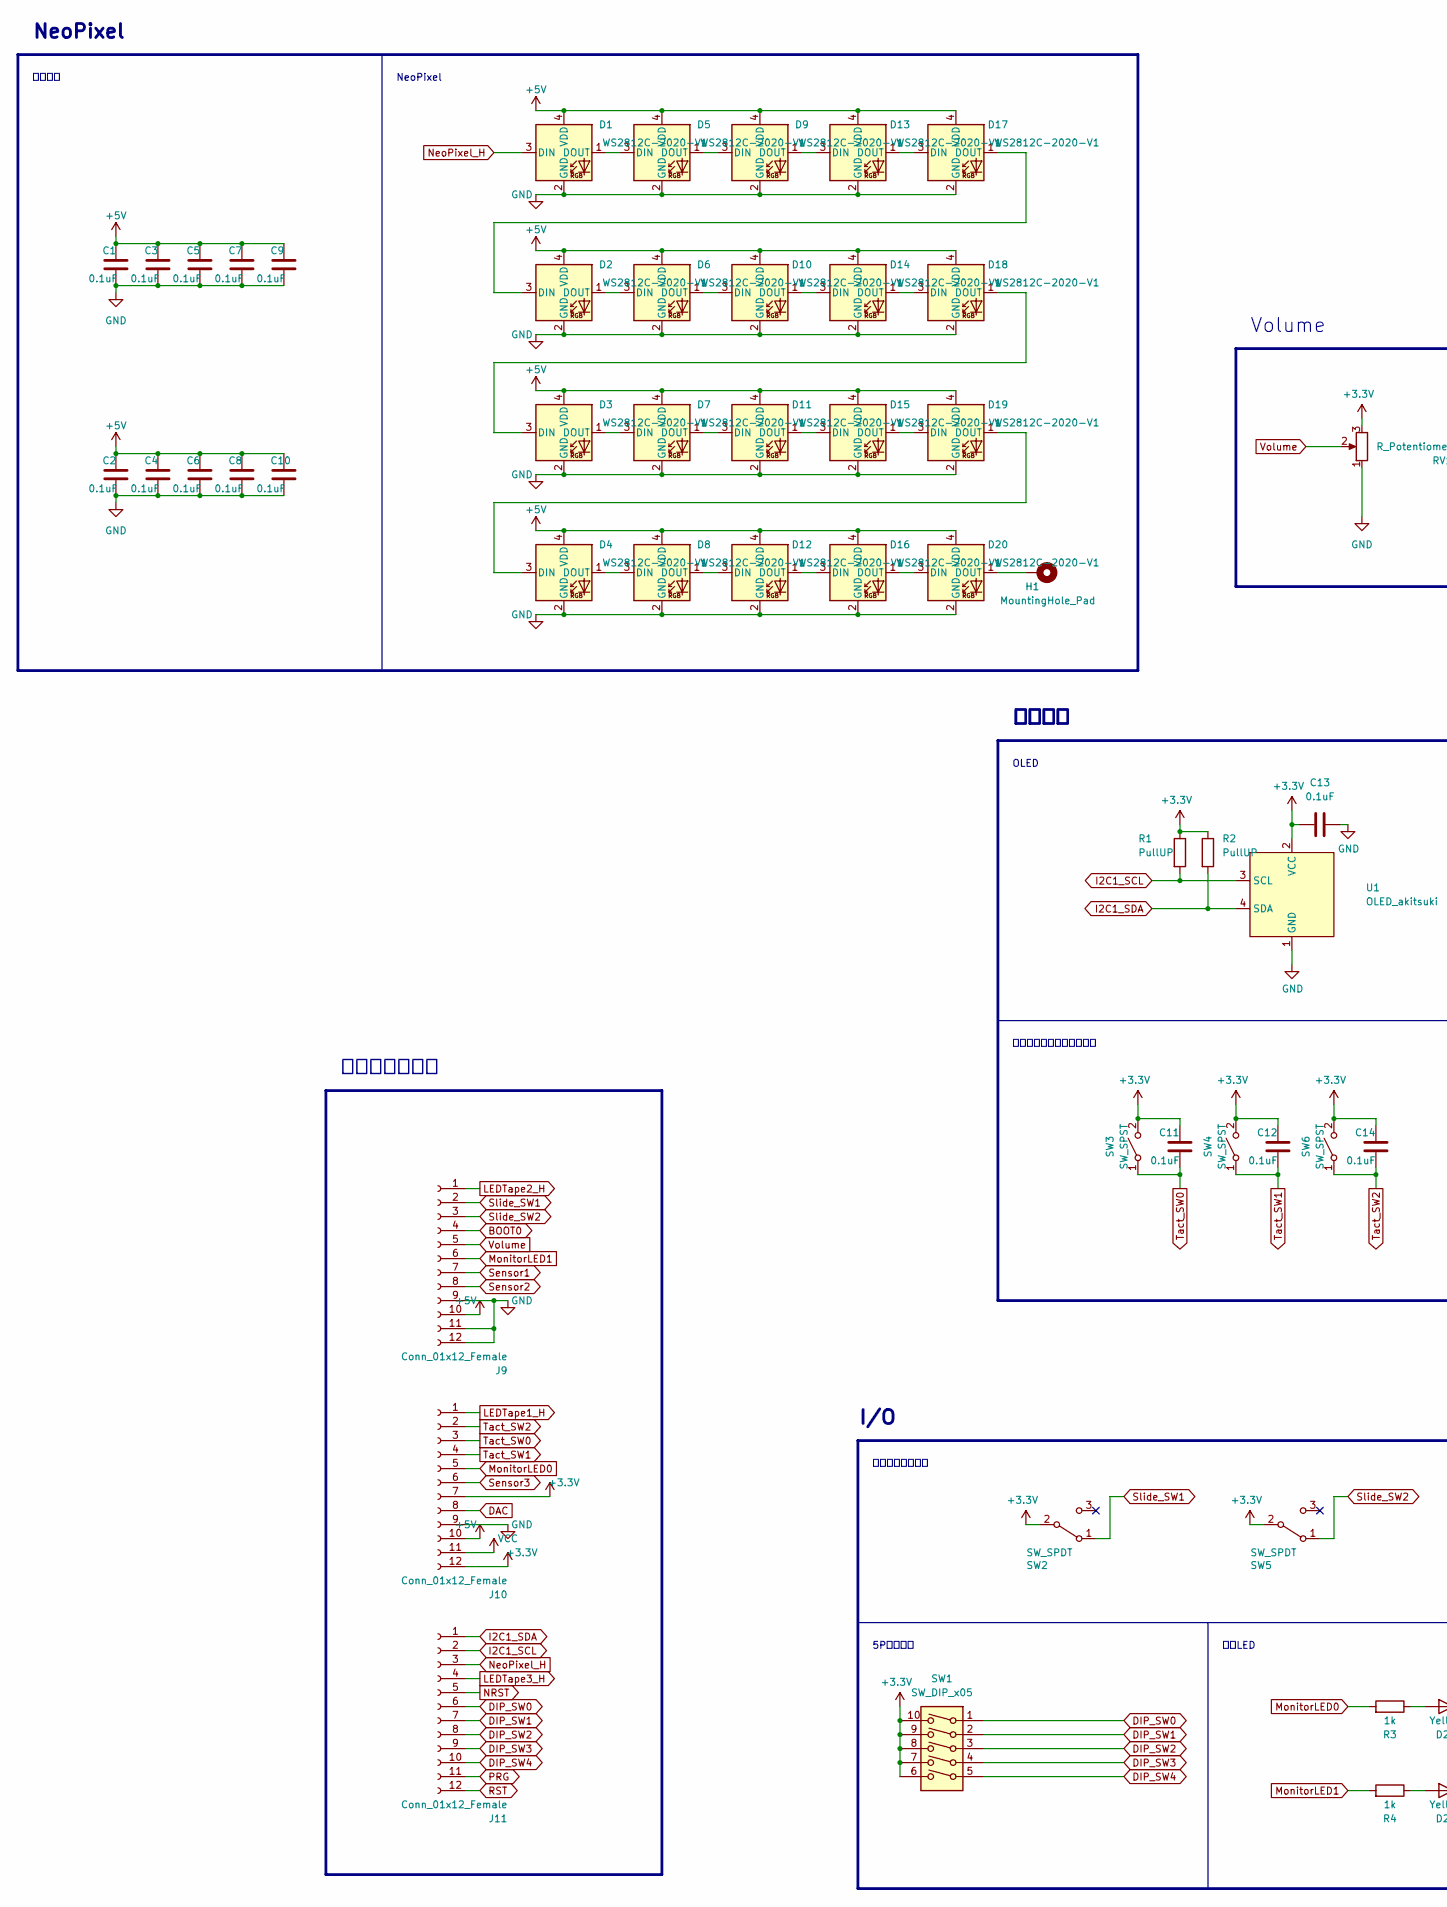
[picture p69: schematic Mother_UI.kicad_sch, part in row 1, column 1]

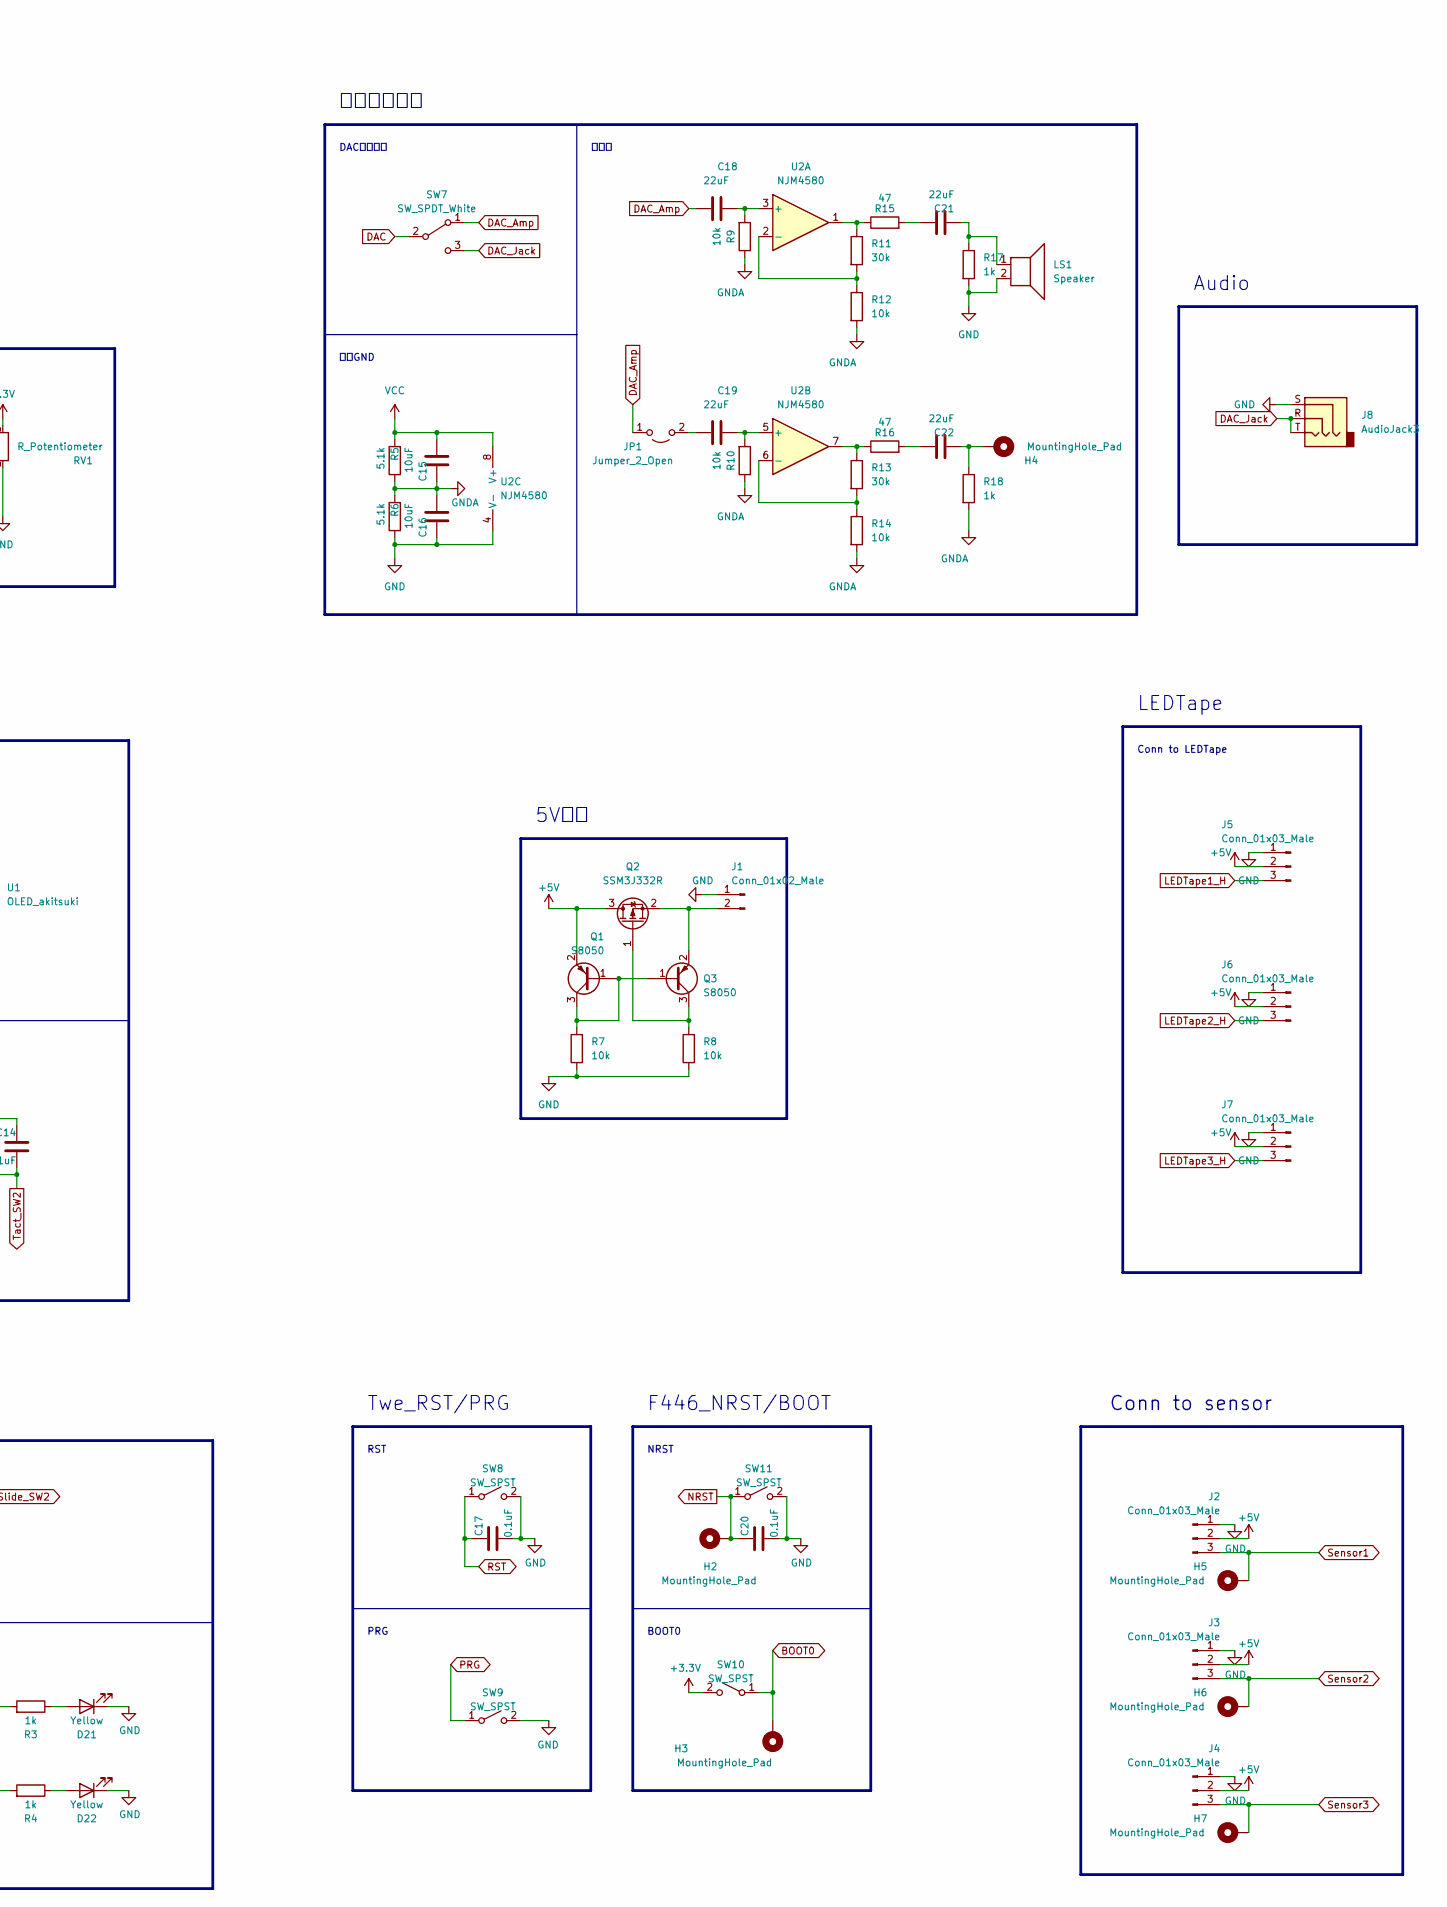
[picture p70: schematic Mother_UI.kicad_sch, part in row 1, column 2]

Parts:
C1, C2, C3, C4, C5, C6, C7, C8, C9, C10, C11, C12, C13, C14, C17, C20: 0.1uF; C_0402_1005Metric
C15, C16: 10uF; C_0805_2012Metric
C18, C19, C21, C22: 22uF; C_0805_2012Metric
D1, D2, D3, D4, D5, D6, D7, D8, D9, D10, D11, D12, D13, D14, D15, D16, D17, D18, D19, D20: WS2812C-2020-V1
D21, D22: Yellow; LED_0603_1608Metric_Pad1.05x0.95mm_HandSolder
H1, H2, H3, H4, H5, H6, H7: MountingHole_Pad; TestPoint_Pad_1.5x1.5mm
J1: Conn_01x02_Male; Molex_SPOX_5268-02A_1x02_P2.50mm_Horizontal
J2, J3, J4, J5, J6, J7: Conn_01x03_Male; Molex_SPOX_5268-03A_1x03_P2.50mm_Horizontal
J8: AudioJack3; Jack_3.5mm_Switronic_ST-005-G_horizontal
J9, J10, J11: Conn_01x12_Female; PinHeader_1x12_P2.54mm_Vertical
JP1: Jumper_2_Open; SolderJumper-2_P1.3mm_Open_TrianglePad1.0x1.5mm
LS1: Speaker; Buzzer_Murata_PKLCS1212E
Q1, Q3: S8050; SOT-23
Q2: SSM3J332R; SOT-23W
R1, R2: PullUP; R_0603_1608Metric_Pad0.98x0.95mm_HandSolder
R3, R4, R17, R18: 1k; R_0402_1005Metric
R5, R6: 5.1k; R_0402_1005Metric
R7, R8, R9, R10: 10k; R_0402_1005Metric
R11, R13: 30k; R_0603_1608Metric
R12, R14: 10k; R_0603_1608Metric
R15, R16: 47; R_0603_1608Metric
RV1: R_Potentiometer; TSR-3386K
SW1: SW_DIP_x05; DIP-10_W7.62mm
SW2, SW5: SW_SPDT; 3P_SPDT_SlideSwitch
SW3, SW4, SW6, SW8, SW9, SW10, SW11: SW_SPST; SW_SPST_Omron_B3FS-100xP
SW7: SW_SPDT_White; SW_Slide_SPDT_White
U1: OLED_akitsuki; 128×64_OLED_White
U2: NJM4580; SOP-8_3.9x4.9mm_P1.27mm

Connections:
+3.3V: C11.1, C12.1, C13.1, C14.1, J10.7, J10.12, R1.1, R2.1, RV1.3, SW1.6, SW1.7, SW1.8, SW1.9, SW1.10, SW2.2 (B), SW3.2 (B), SW4.2 (B), SW5.2 (B), SW6.2 (B), SW10.2 (B), U1.2 (VCC)
+5V: C1.1, C2.1, C3.1, C4.1, C5.1, C6.1, C7.1, C8.1, C9.1, C10.1, D1.4 (VDD), D2.4 (VDD), D3.4 (VDD), D4.4 (VDD), D5.4 (VDD), D6.4 (VDD), D7.4 (VDD), D8.4 (VDD), D9.4 (VDD), D10.4 (VDD), D11.4 (VDD), D12.4 (VDD), D13.4 (VDD), D14.4 (VDD), D15.4 (VDD), D16.4 (VDD), D17.4 (VDD), D18.4 (VDD), D19.4 (VDD), D20.4 (VDD), J2.2, J3.2, J4.2, J5.2, J6.2, J7.2, J9.10, J10.10, Q1.2 (E), Q2.3 (D)
BOOT0: H3.1, J9.4, SW10.1 (A)
DAC: J10.8, SW7.2 (B)
DAC_Amp: C18.1, JP1.1 (A), SW7.1 (A)
DAC_Jack: J8.R, J8.T, SW7.3 (C)
DIP_SW0: J11.6, SW1.1
DIP_SW1: J11.7, SW1.2
DIP_SW2: J11.8, SW1.3
DIP_SW3: J11.9, SW1.4
DIP_SW4: J11.10, SW1.5
GND: C1.2, C2.2, C3.2, C4.2, C5.2, C6.2, C7.2, C8.2, C9.2, C10.2, C13.2, C16.2, C17.2, C20.2, D1.2 (GND), D2.2 (GND), D3.2 (GND), D4.2 (GND), D5.2 (GND), D6.2 (GND), D7.2 (GND), D8.2 (GND), D9.2 (GND), D10.2 (GND), D11.2 (GND), D12.2 (GND), D13.2 (GND), D14.2 (GND), D15.2 (GND), D16.2 (GND), D17.2 (GND), D18.2 (GND), D19.2 (GND), D20.2 (GND), D21.1 (K), D22.1 (K), J1.1, J2.1, J3.1, J4.1, J5.1, J6.1, J7.1, J8.S, J9.9, J9.11, J9.12, J10.9, LS1.2, R6.1, R7.1, R8.1, R17.2, RV1.1, SW8.2 (B), SW9.2 (B), SW11.2 (B), U1.1 (GND), U2.4 (V-)
GNDA: C15.2, C16.1, R5.1, R6.2, R9.1, R10.1, R12.2, R14.2, R18.2
I2C1_SCL: J11.2, R1.2, U1.3 (SCL)
I2C1_SDA: J11.1, R2.2, U1.4 (SDA)
LEDTape1_H: J5.3, J10.1
LEDTape2_H: J6.3, J9.1
LEDTape3_H: J7.3, J11.4
MonitorLED0: J10.5, R3.2
MonitorLED1: J9.6, R4.2
NRST: C20.1, H2.1, J11.5, SW11.1 (A)
NeoPixel_H: D1.3 (DIN), J11.3
unnamed: C18.2, R9.2, U2.3 (+)
unnamed: C19.1, JP1.2 (B)
unnamed: C19.2, R10.2, U2.5 (+)
unnamed: C21.1, R15.2
unnamed: C21.2, LS1.1, R17.1
unnamed: C22.1, R16.2
unnamed: C22.2, H4.1, R18.1
unnamed: D1.1 (DOUT), D5.3 (DIN)
unnamed: D2.1 (DOUT), D6.3 (DIN)
unnamed: D3.1 (DOUT), D7.3 (DIN)
unnamed: D4.1 (DOUT), D8.3 (DIN)
unnamed: D5.1 (DOUT), D9.3 (DIN)
unnamed: D10.1 (DOUT), D14.3 (DIN)
unnamed: D6.1 (DOUT), D10.3 (DIN)
unnamed: D11.1 (DOUT), D15.3 (DIN)
unnamed: D7.1 (DOUT), D11.3 (DIN)
unnamed: D12.1 (DOUT), D16.3 (DIN)
unnamed: D8.1 (DOUT), D12.3 (DIN)
unnamed: D13.1 (DOUT), D17.3 (DIN)
unnamed: D9.1 (DOUT), D13.3 (DIN)
unnamed: D14.1 (DOUT), D18.3 (DIN)
unnamed: D15.1 (DOUT), D19.3 (DIN)
unnamed: D16.1 (DOUT), D20.3 (DIN)
unnamed: D2.3 (DIN), D17.1 (DOUT)
unnamed: D3.3 (DIN), D18.1 (DOUT)
unnamed: D4.3 (DIN), D19.1 (DOUT)
unnamed: D20.1 (DOUT), H1.1
unnamed: D21.2 (A), R3.1
unnamed: D22.2 (A), R4.1
unnamed: J1.2, Q2.2 (S), Q3.2 (E)
unnamed: Q1.1 (B), Q1.3 (C), Q3.1 (B), R7.2
unnamed: Q2.1 (G), Q3.3 (C), R8.2
unnamed: R11.1, R15.1, U2.1
unnamed: R11.2, R12.1, U2.2 (-)
unnamed: R13.1, R16.1, U2.7
unnamed: R13.2, R14.1, U2.6 (-)
PRG: J11.11, SW9.1 (A)
RST: C17.1, J11.12, SW8.1 (A)
Sensor1: H5.1, J2.3, J9.7
Sensor2: H6.1, J3.3, J9.8
Sensor3: H7.1, J4.3, J10.6
Slide_SW1: J9.2, SW2.1 (A)
Slide_SW2: J9.3, SW5.1 (A)
Tact_SW0: C11.2, J10.3, SW3.1 (A)
Tact_SW1: C12.2, J10.4, SW4.1 (A)
Tact_SW2: C14.2, J10.2, SW6.1 (A)
VCC: C15.1, J10.11, R5.2, U2.8 (V+)
Volume: J9.5, RV1.2

Notes on the sheet:
仮想GND
RST
F446_NRST/BOOT
NeoPixel
Conn to sensor
BOOT0
I/O
OLED
5V出力
しょぼアンプ
スライドスイッチ
PRG
監視LED
Conn to LEDTape
DACスイッチ
Twe_RST/PRG
NRST
アンプ
基板間コネクタ
LEDTape
モニター
5Pスイッチ
モニター用タクトスイッチ
パスコン
Volume
Audio
