Tomoshibi-technology/RCJ-Japan2024-Circuit/Mother_UI/Mother_UI.kicad_pcb

## KiCad design Mother_UI/Mother_UI.kicad_pcb (continued)

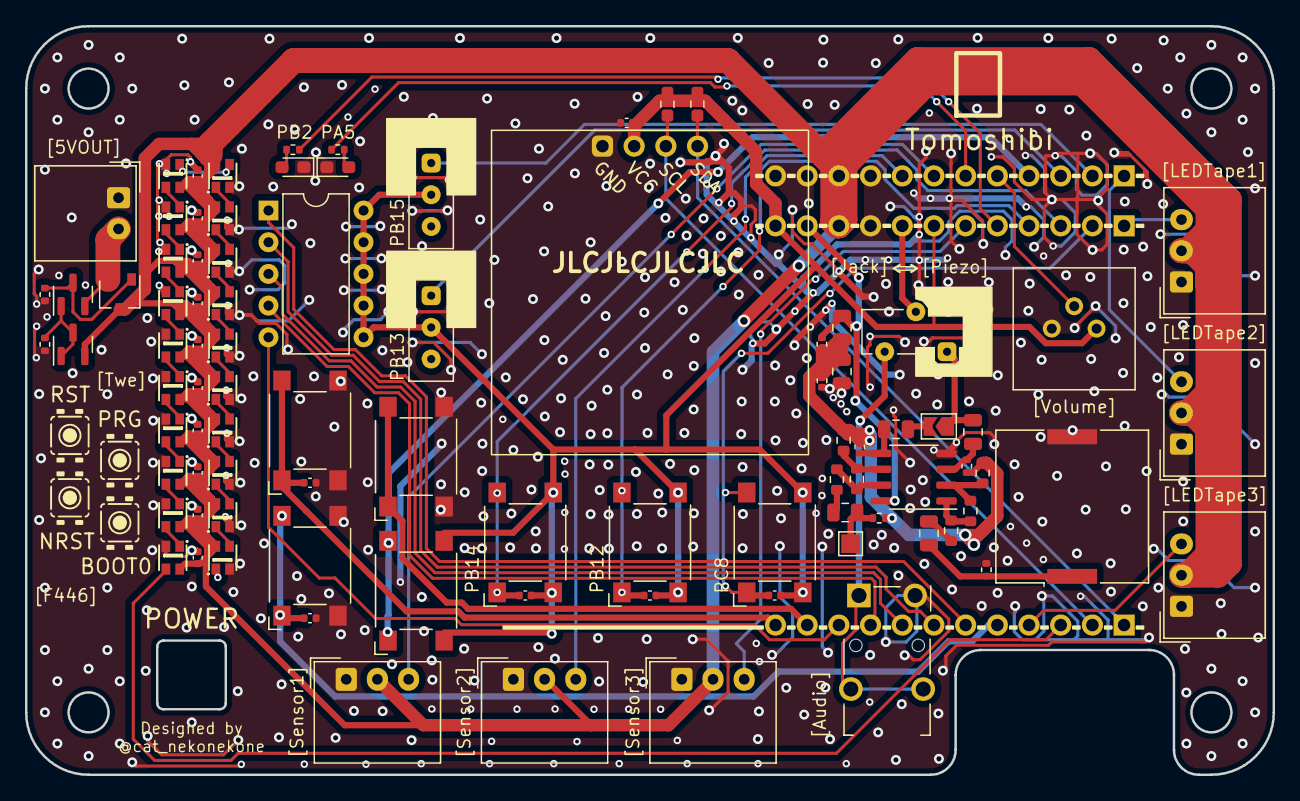
[picture p71: board Mother_UI.kicad_pcb from above]

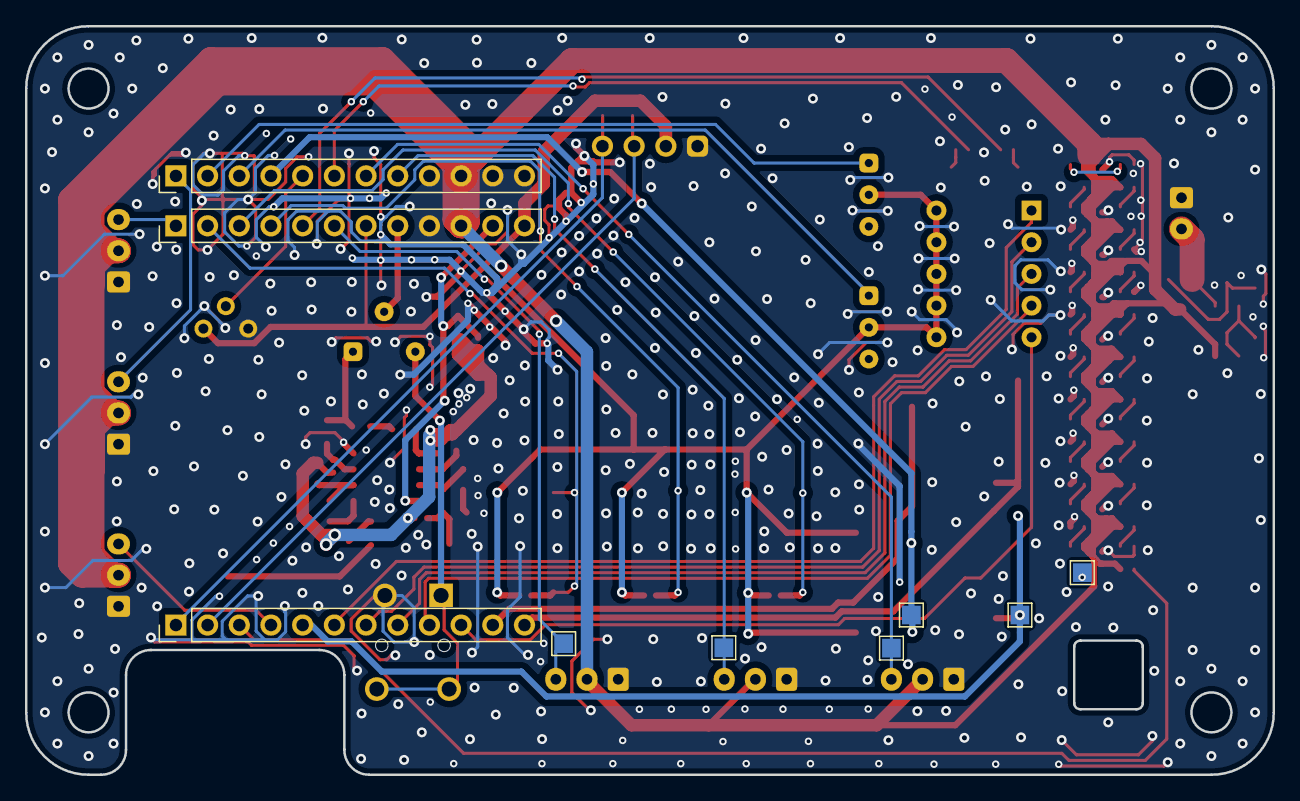
[picture p72: board Mother_UI.kicad_pcb from below]

Board: 2 copper layers, 100.0 x 60.0 mm, 99 parts (9 on the bottom side), 70 nets.
