Tomoshibi-technology/RCJ-Japan2024-Circuit/LED_lighting_large/LED_lighting_large.kicad_pcb

## KiCad design LED_lighting_large/LED_lighting_large.kicad_pcb (2024-02-10)

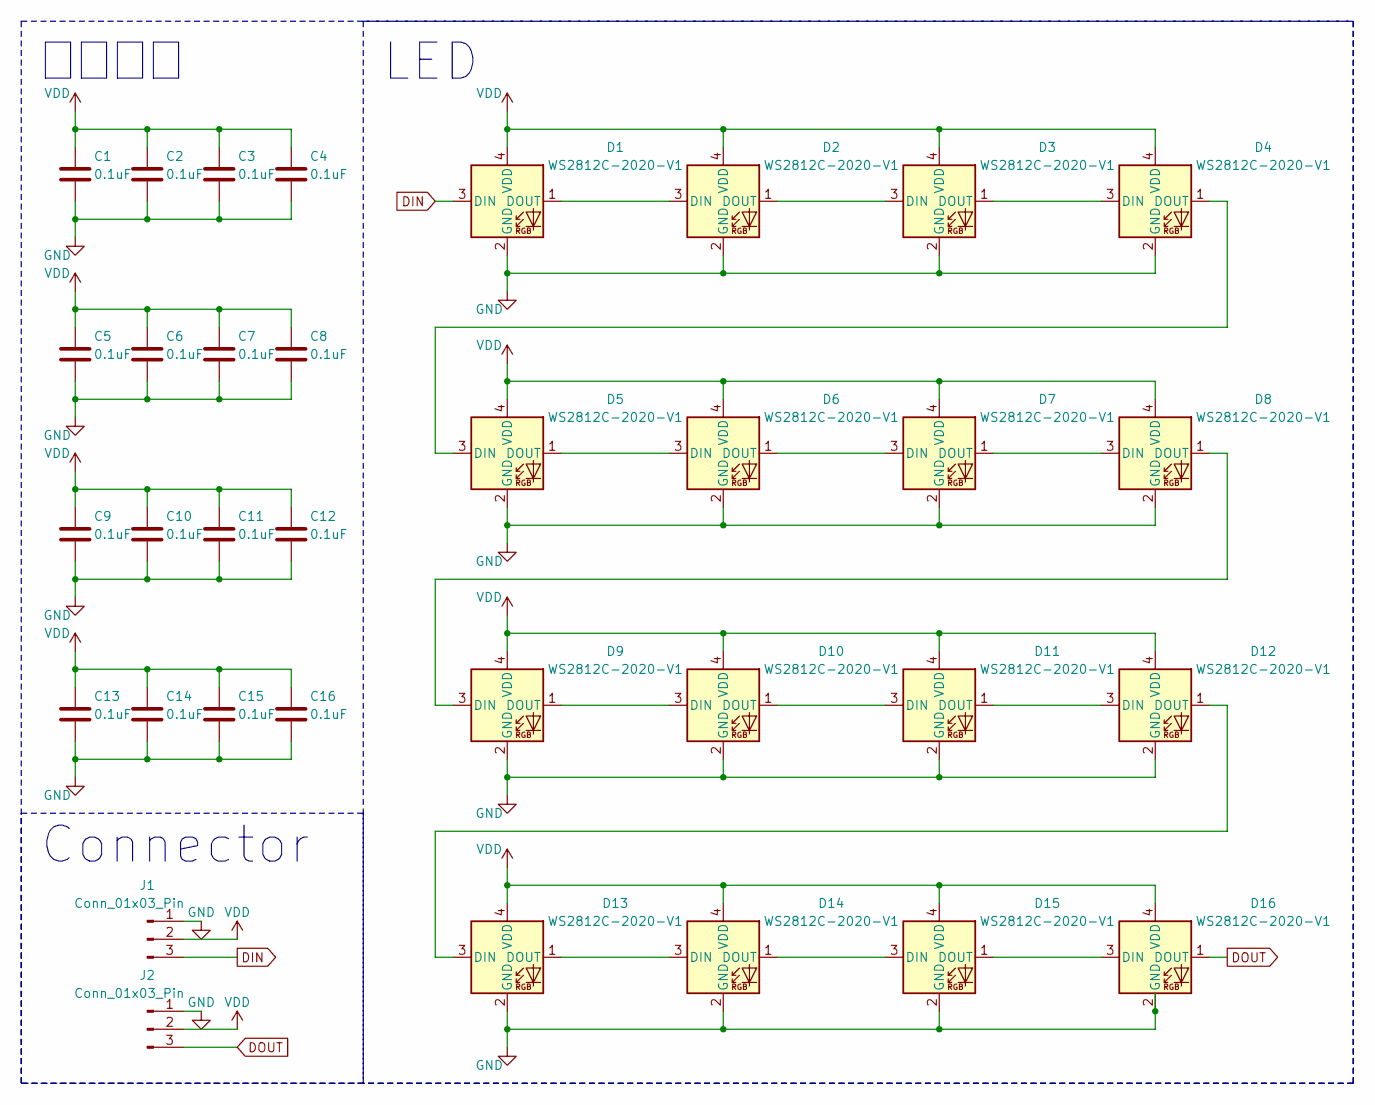
[picture p73: schematic LED_lighting_large.kicad_sch]

Parts:
C1, C2, C3, C4, C5, C6, C7, C8, C9, C10, C11, C12, C13, C14, C15, C16: 0.1uF; C_0603_1608Metric_Pad1.08x0.95mm_HandSolder
D1, D2, D3, D4, D5, D6, D7, D8, D9, D10, D11, D12, D13, D14, D15, D16: WS2812C-2020-V1
J1, J2: Conn_01x03_Pin; JST_PH_B3B-PH-K_1x03_P2.00mm_Vertical

Connections:
DIN: D1.3 (DIN), J1.3
DOUT: D16.1 (DOUT), J2.3
GND: C1.2, C2.2, C3.2, C4.2, C5.2, C6.2, C7.2, C8.2, C9.2, C10.2, C11.2, C12.2, C13.2, C14.2, C15.2, C16.2, D1.2 (GND), D2.2 (GND), D3.2 (GND), D4.2 (GND), D5.2 (GND), D6.2 (GND), D7.2 (GND), D8.2 (GND), D9.2 (GND), D10.2 (GND), D11.2 (GND), D12.2 (GND), D13.2 (GND), D14.2 (GND), D15.2 (GND), D16.2 (GND), J1.1, J2.1
unnamed: D1.1 (DOUT), D2.3 (DIN)
unnamed: D2.1 (DOUT), D3.3 (DIN)
unnamed: D3.1 (DOUT), D4.3 (DIN)
unnamed: D4.1 (DOUT), D5.3 (DIN)
unnamed: D5.1 (DOUT), D6.3 (DIN)
unnamed: D6.1 (DOUT), D7.3 (DIN)
unnamed: D7.1 (DOUT), D8.3 (DIN)
unnamed: D8.1 (DOUT), D9.3 (DIN)
unnamed: D9.1 (DOUT), D10.3 (DIN)
unnamed: D10.1 (DOUT), D11.3 (DIN)
unnamed: D11.1 (DOUT), D12.3 (DIN)
unnamed: D12.1 (DOUT), D13.3 (DIN)
unnamed: D13.1 (DOUT), D14.3 (DIN)
unnamed: D14.1 (DOUT), D15.3 (DIN)
unnamed: D15.1 (DOUT), D16.3 (DIN)
VDD: C1.1, C2.1, C3.1, C4.1, C5.1, C6.1, C7.1, C8.1, C9.1, C10.1, C11.1, C12.1, C13.1, C14.1, C15.1, C16.1, D1.4 (VDD), D2.4 (VDD), D3.4 (VDD), D4.4 (VDD), D5.4 (VDD), D6.4 (VDD), D7.4 (VDD), D8.4 (VDD), D9.4 (VDD), D10.4 (VDD), D11.4 (VDD), D12.4 (VDD), D13.4 (VDD), D14.4 (VDD), D15.4 (VDD), D16.4 (VDD), J1.2, J2.2

Notes on the sheet:
LED
Connector
パスコン

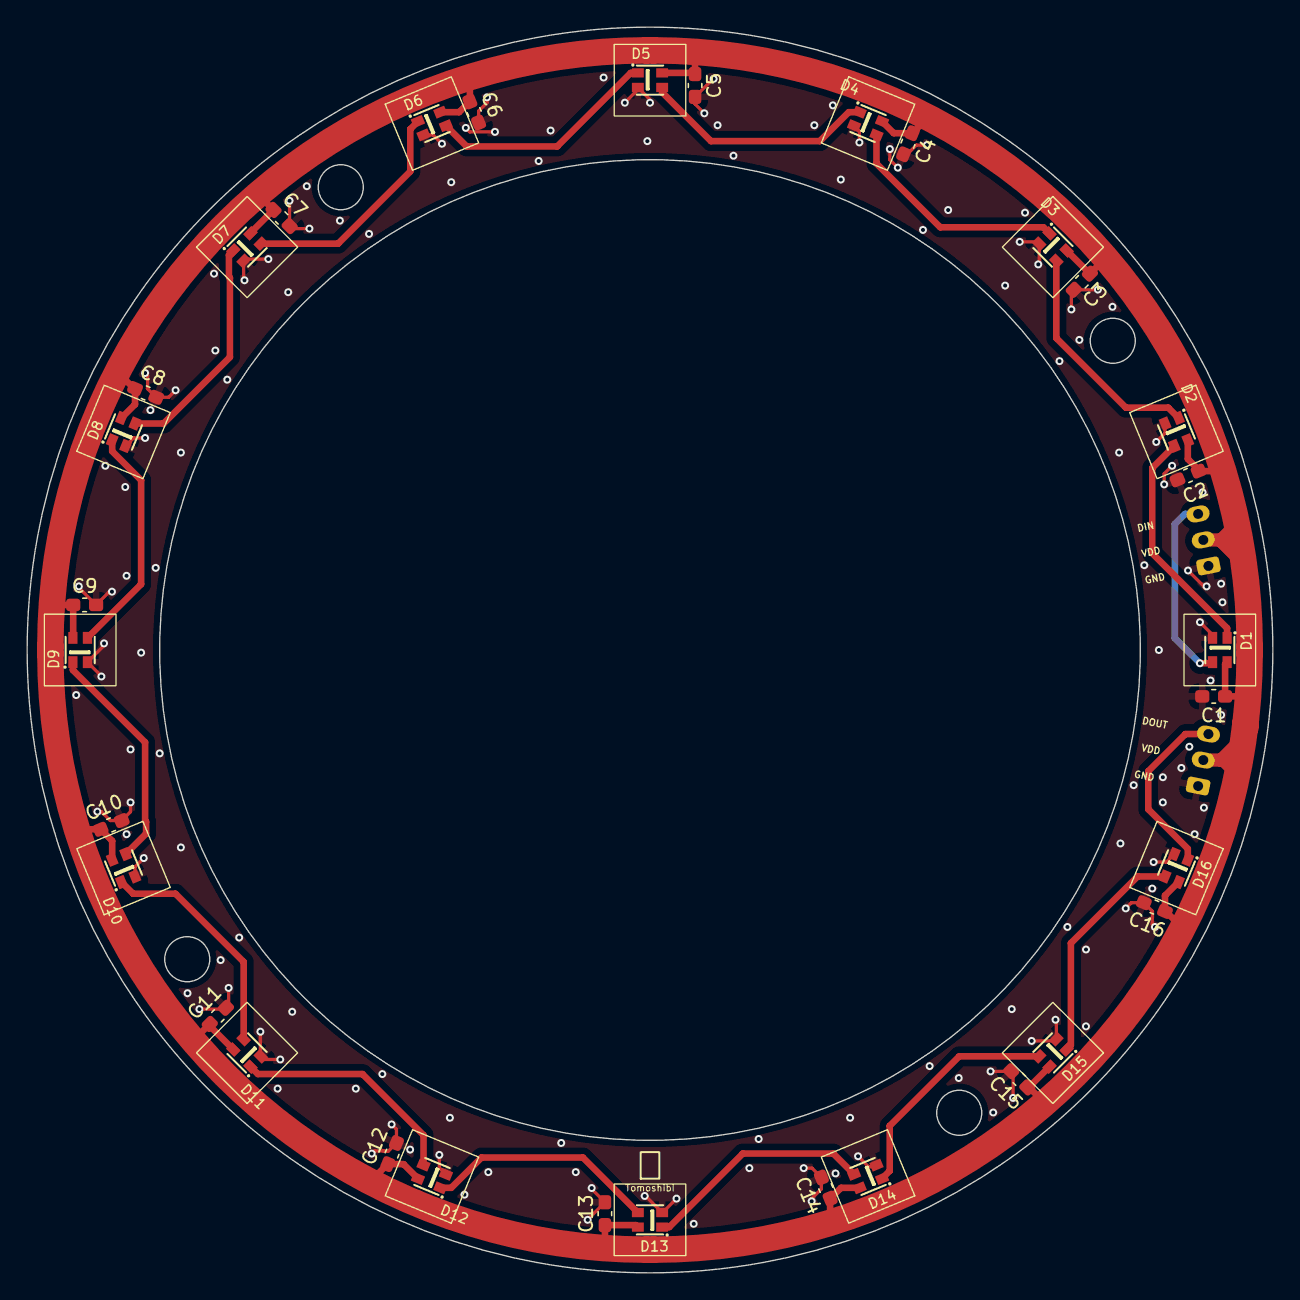
[picture p74: board LED_lighting_large.kicad_pcb from above]

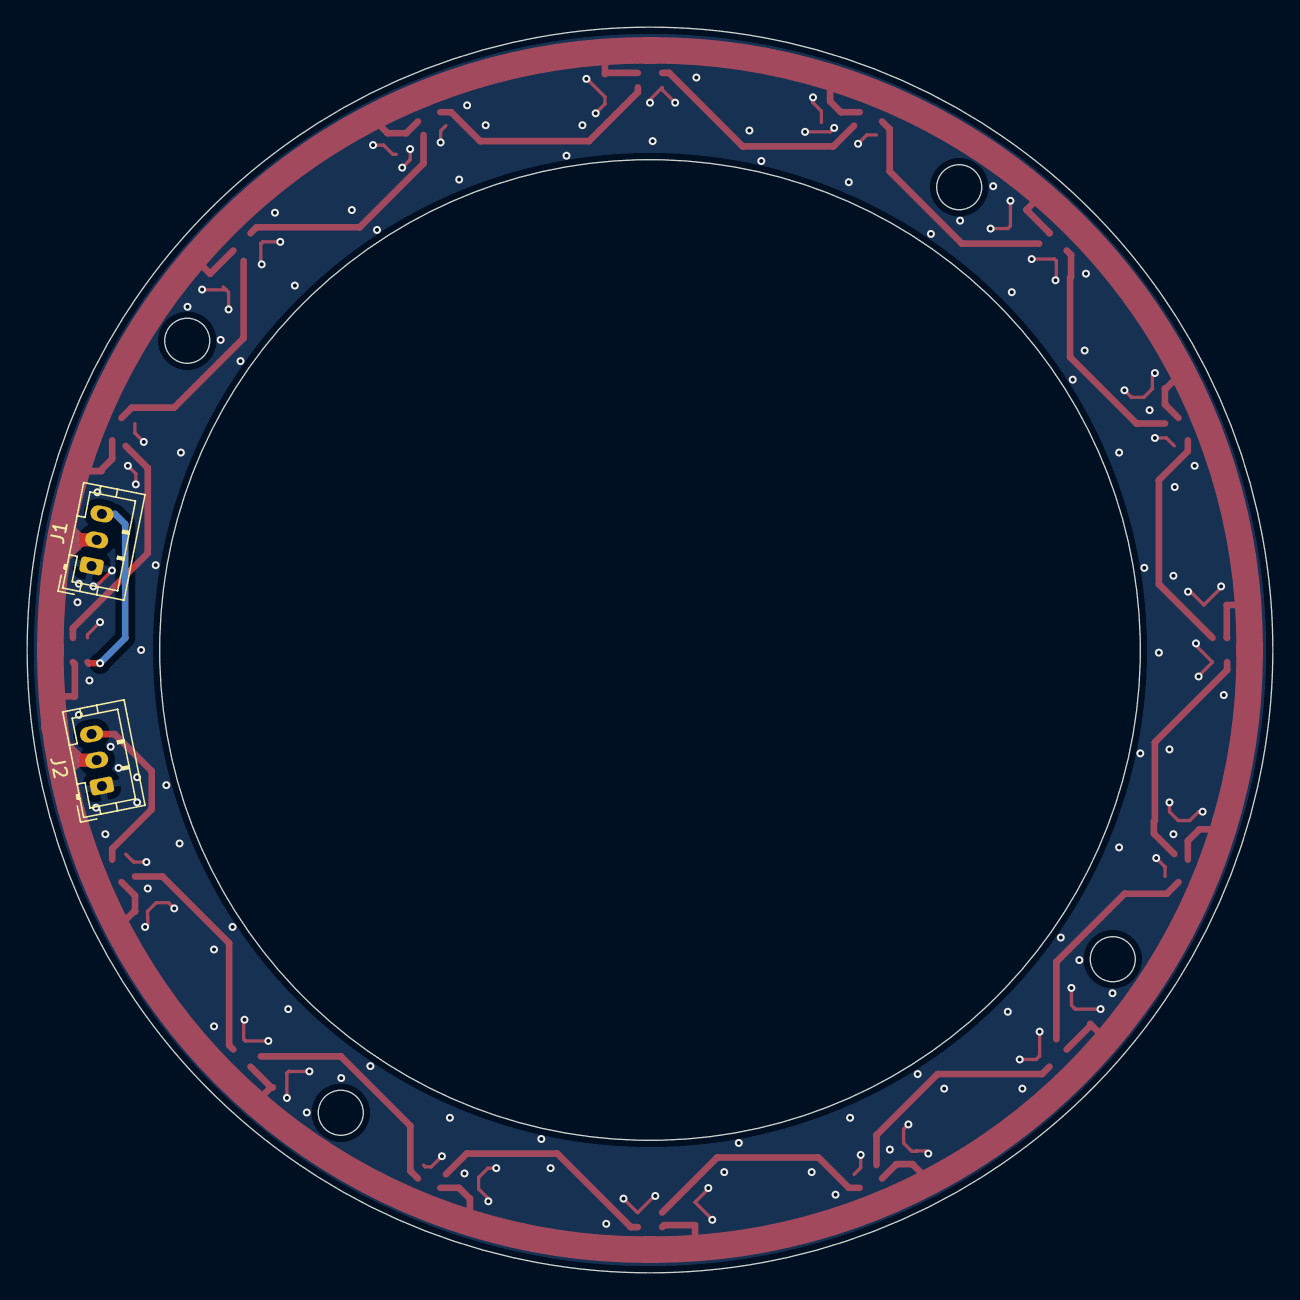
[picture p75: board LED_lighting_large.kicad_pcb from below]

Board: 2 copper layers, 94.0 x 94.0 mm, 34 parts (2 on the bottom side), 19 nets.
