Tomoshibi-technology/RCJ-Japan2024-Circuit/connect/connect.kicad_pcb

## KiCad design connect/connect.kicad_pcb (2024-02-10)

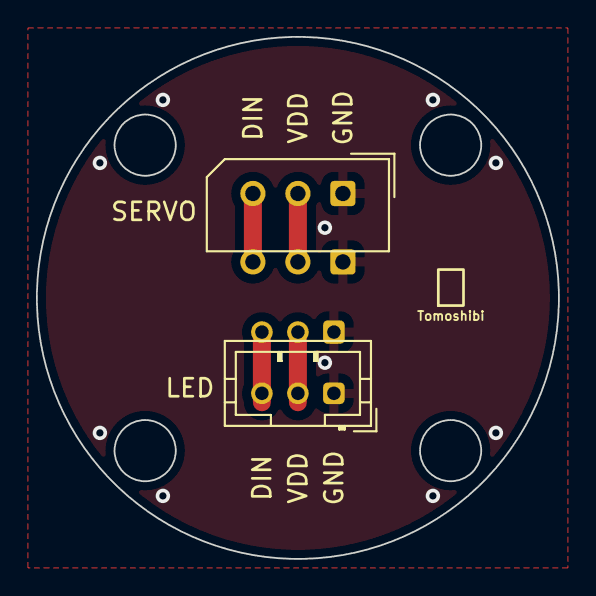
[picture p76: board connect.kicad_pcb from above]

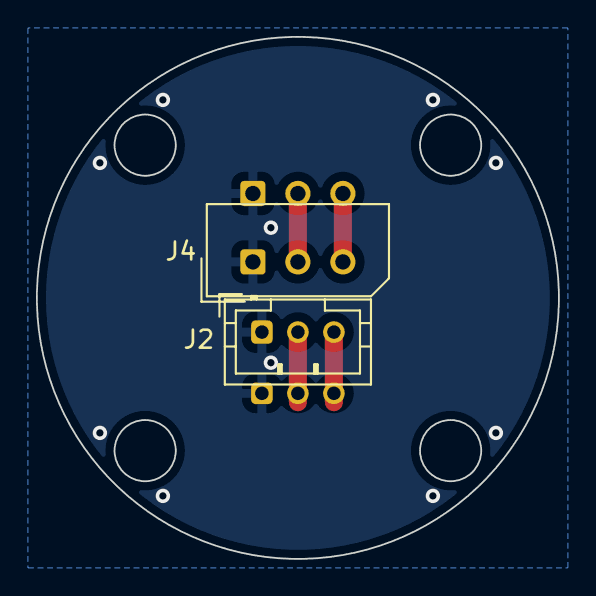
[picture p77: board connect.kicad_pcb from below]

Board: 2 copper layers, 29.0 x 29.0 mm, 4 parts (2 on the bottom side), 5 nets.

Parts:
J2: Conn_01x03_Pin; JST_PH_B3B-PH-K_1x03_P2.00mm_Vertical
J4: Conn_01x03_Pin; Molex_SPOX_5267-03A_1x03_P2.50mm_Vertical
LED: Conn_01x03_Pin; JST_PH_B3B-PH-K_1x03_P2.00mm_Vertical
SERVO: Conn_01x03_Pin; Molex_SPOX_5267-03A_1x03_P2.50mm_Vertical

Connections:
GND: J2.1, J4.1, LED.1, SERVO.1
unnamed: J2.2, LED.2
unnamed: J2.3, LED.3
unnamed: J4.2, SERVO.2
unnamed: J4.3, SERVO.3
