Tomoshibi-technology/RCJ-Japan2024-Circuit/Encoder/Encoder.kicad_pcb

## KiCad design Encoder/Encoder.kicad_pcb (2024-02-10)

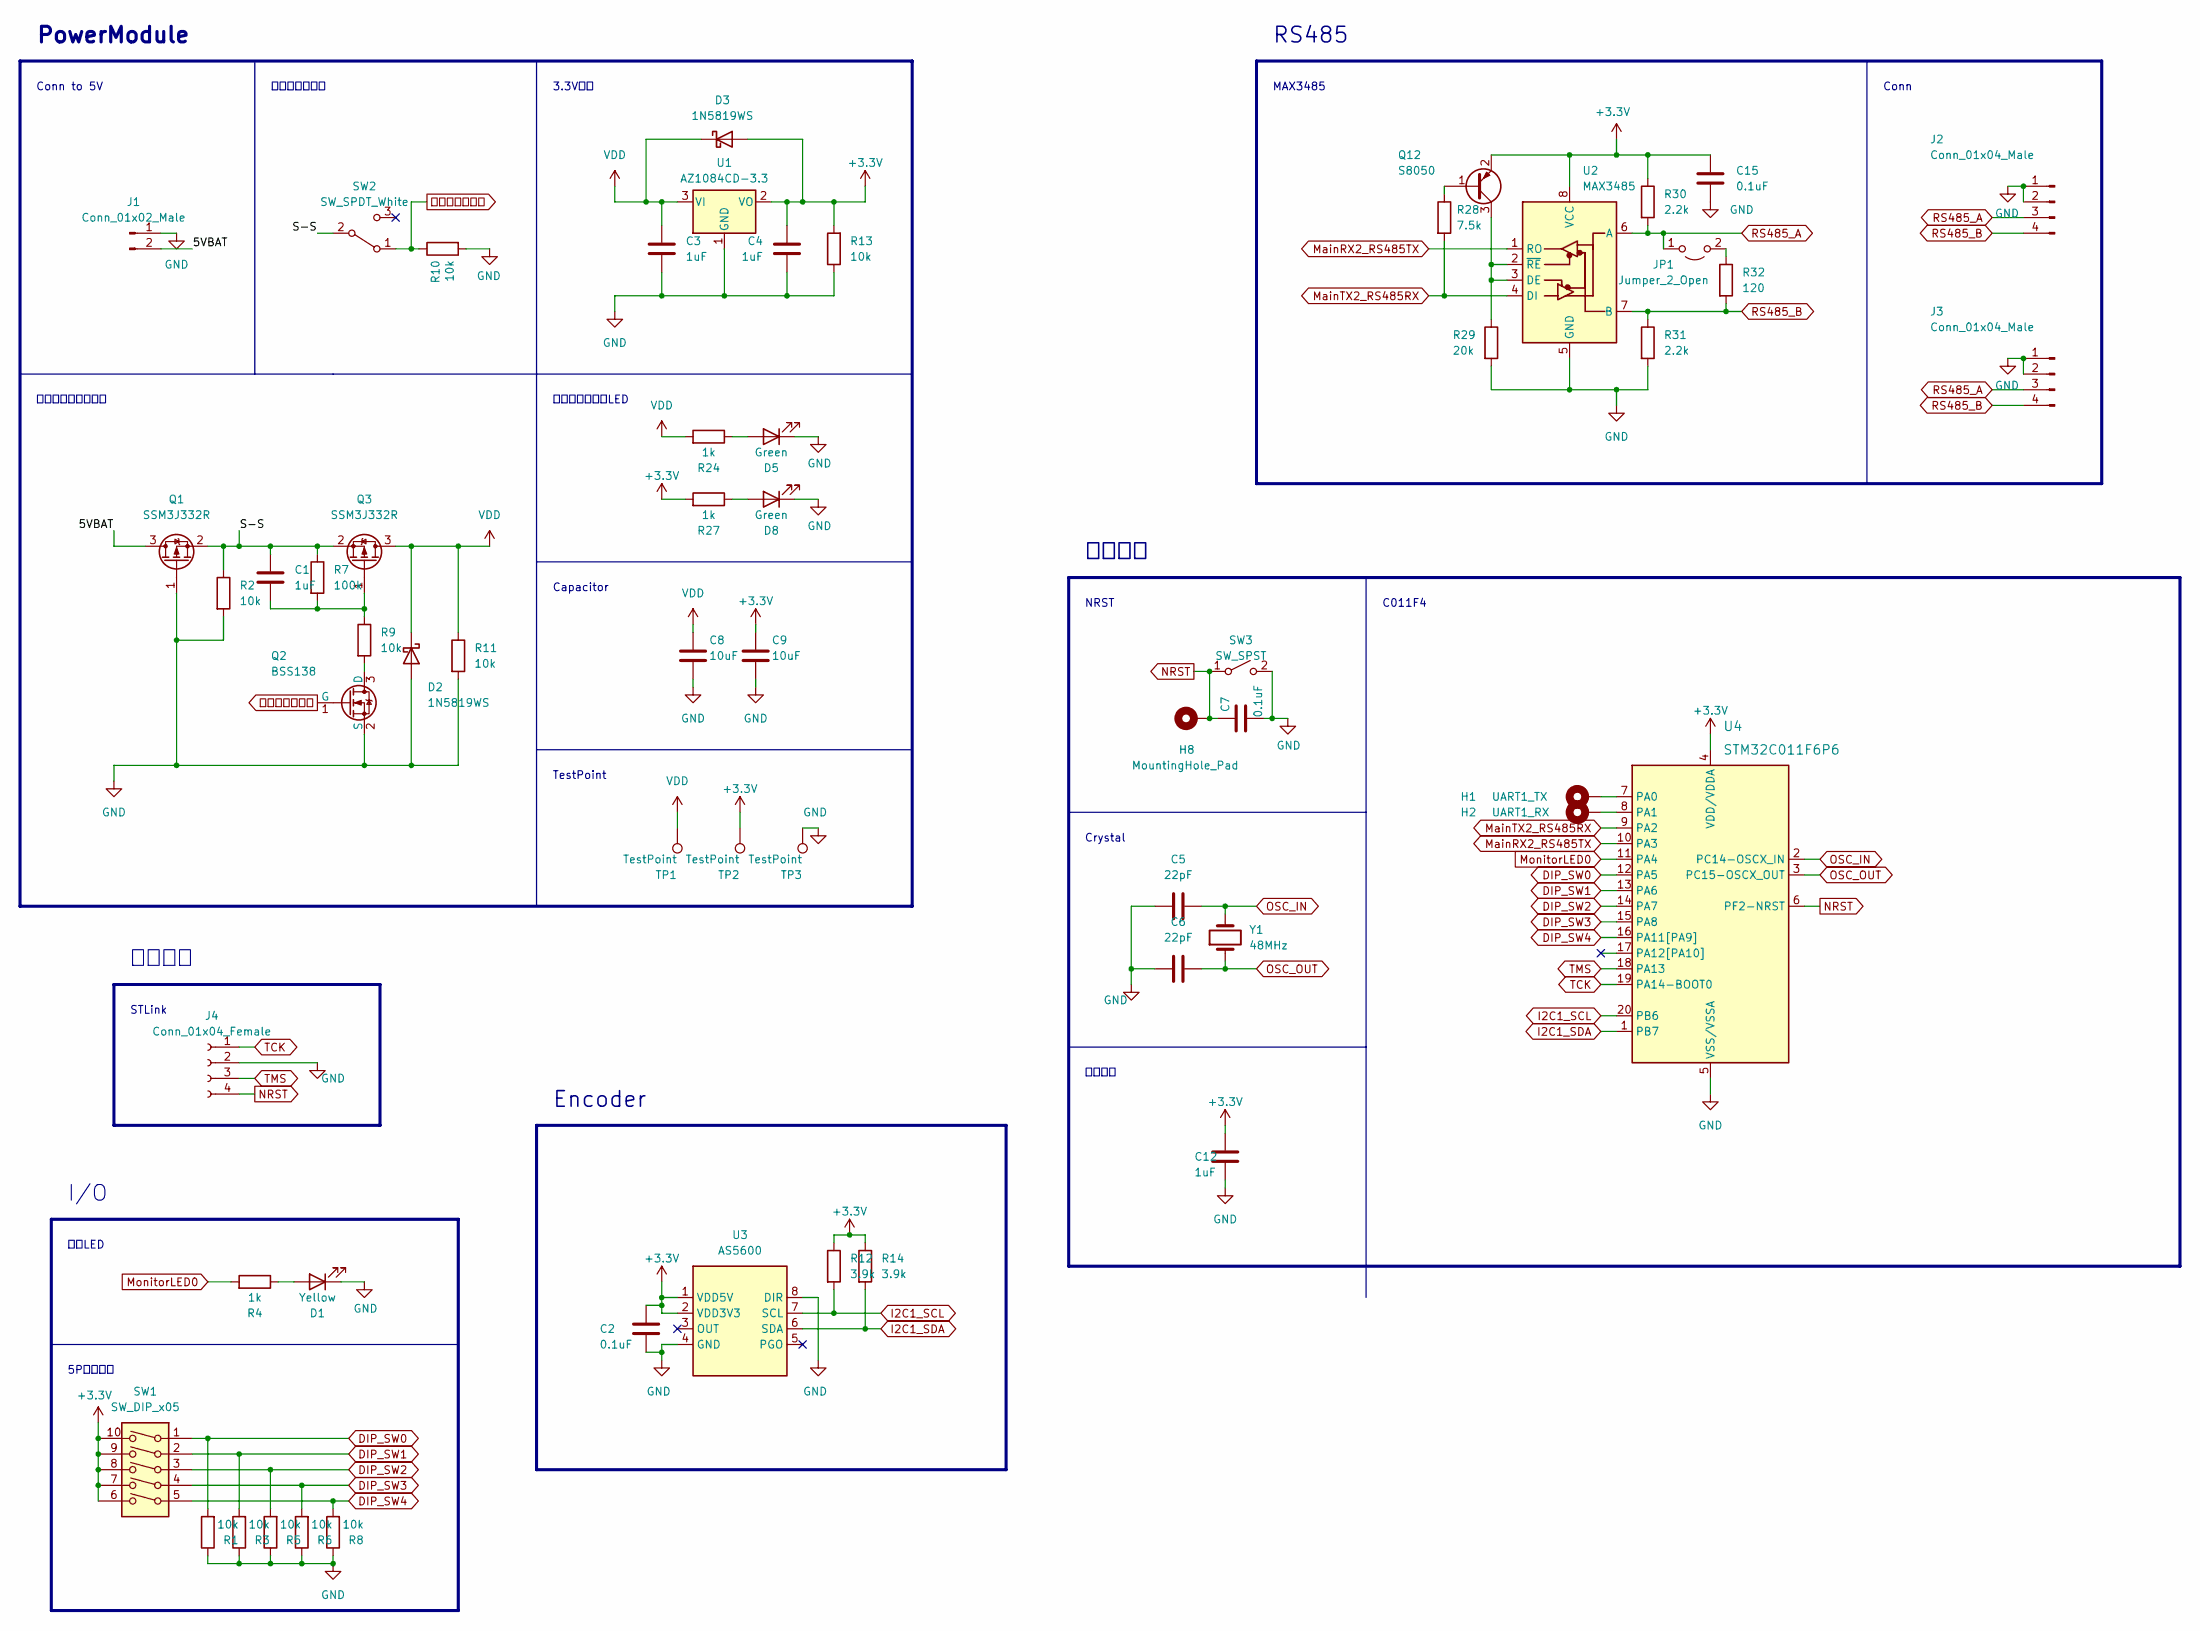
[picture p84: schematic Encoder.kicad_sch]

Parts:
C1, C3, C4, C12: 1uF; C_0402_1005Metric
C2, C7, C15: 0.1uF; C_0402_1005Metric
C5, C6: 22pF; C_0603_1608Metric
C8, C9: 10uF; C_0805_2012Metric
D1: Yellow; LED_0603_1608Metric_Pad1.05x0.95mm_HandSolder
D2, D3: 1N5819WS; D_SOD-323_HandSoldering
D5, D8: Green; LED_0603_1608Metric_Pad1.05x0.95mm_HandSolder
H1: UART1_TX; TestPoint_Pad_1.5x1.5mm
H2: UART1_RX; TestPoint_Pad_1.5x1.5mm
H8: MountingHole_Pad; TestPoint_Pad_1.5x1.5mm
J1: Conn_01x02_Male; Molex_SPOX_5268-02A_1x02_P2.50mm_Horizontal
J2, J3: Conn_01x04_Male; Molex_SPOX_5268-04A_1x04_P2.50mm_Horizontal
J4: Conn_01x04_Female; PinHeader_1x04_P2.54mm_Vertical
JP1: Jumper_2_Open; SolderJumper-2_P1.3mm_Open_TrianglePad1.0x1.5mm
Q1, Q3: SSM3J332R; SOT-23W
Q2: BSS138; SOT-23
Q12: S8050; SOT-23
R1, R2, R3, R5, R6, R8, R9, R10, R11, R13: 10k; R_0402_1005Metric
R4, R24, R27: 1k; R_0402_1005Metric
R7: 100k; R_0402_1005Metric
R12, R14: 3.9k; R_0603_1608Metric
R28: 7.5k; R_0603_1608Metric
R29: 20k; R_0402_1005Metric
R30, R31: 2.2k; R_0402_1005Metric
R32: 120; R_0402_1005Metric
SW1: SW_DIP_x05; SMDIP-10_W7.62mm
SW2: SW_SPDT_White; SW_Slide_SPDT_White
SW3: SW_SPST; SW_SPST_Omron_B3FS-100xP
TP1, TP2, TP3: TestPoint; TestPoint_THTPad_D2.0mm_Drill1.0mm
U1: AZ1084CD-3.3; TO-252-3_TabPin2
U2: MAX3485; SOP-8_3.9x4.9mm_P1.27mm
U3: AS5600; SOP-8_3.9x4.9mm_P1.27mm
U4: STM32C011F6P6; TSSOP-20_4.4x6.5mm_P0.65mm
Y1: 48MHz; Crystal_SMD_HC49-SD

Connections:
+3.3V: C2.1, C4.1, C9.1, C12.1, C15.1, D3.2 (A), Q12.2 (E), R12.1, R13.2, R14.1, R27.2, R30.1, SW1.6, SW1.7, SW1.8, SW1.9, SW1.10, TP2.1, U1.2 (VO), U2.8 (VCC), U3.1 (VDD5V), U3.2 (VDD3V3), U4.4 (VDD/VDDA)
/5VBAT: J1.2, Q1.3 (D)
/S-S: C1.1, Q1.2 (S), Q3.2 (S), R2.1, R7.1, SW2.2 (B)
DIP_SW0: R1.2, SW1.1, U4.12 (PA5)
DIP_SW1: R3.2, SW1.2, U4.13 (PA6)
DIP_SW2: R5.2, SW1.3, U4.14 (PA7)
DIP_SW3: R6.2, SW1.4, U4.15 (PA8)
DIP_SW4: R8.2, SW1.5, U4.16 (PA11[PA9])
GND: C2.2, C3.2, C4.2, C5.1, C6.1, C7.2, C8.2, C9.2, C12.2, C15.2, D1.1 (K), D2.2 (A), D5.1 (K), D8.1 (K), J1.1, J2.1, J2.2, J3.1, J3.2, J4.2, Q1.1 (G), Q2.2 (S), R1.1, R2.2, R3.1, R5.1, R6.1, R8.1, R10.2, R11.2, R13.1, R29.2, R31.2, SW3.2 (B), TP3.1, U1.1 (GND), U2.5 (GND), U3.4 (GND), U3.8 (DIR), U4.5 (VSS/VSSA)
I2C1_SCL: R12.2, U3.7 (SCL), U4.20 (PB6)
I2C1_SDA: R14.2, U3.6 (SDA), U4.1 (PB7)
MainRX2_RS485TX: U2.1 (RO), U4.10 (PA3)
MainTX2_RS485RX: R28.2, U2.4 (DI), U4.9 (PA2)
MonitorLED0: R4.2, U4.11 (PA4)
NRST: C7.1, H8.1, J4.4, SW3.1 (A), U4.6 (PF2-NRST)
unnamed: C1.2, Q3.1 (G), R7.2, R9.1
unnamed: D1.2 (A), R4.1
unnamed: D5.2 (A), R24.1
unnamed: D8.2 (A), R27.1
unnamed: H1.1, U4.7 (PA0)
unnamed: H2.1, U4.8 (PA1)
unnamed: JP1.2 (B), R32.1
unnamed: Q2.3 (D), R9.2
unnamed: Q12.1 (B), R28.1
unnamed: Q12.3 (C), R29.1, U2.2 (~RE), U2.3 (DE)
OSC_IN: C5.2, U4.2 (PC14-OSCX_IN), Y1.2
OSC_OUT: C6.2, U4.3 (PC15-OSCX_OUT), Y1.1
RS485_A: J2.3, J3.3, JP1.1 (A), R30.2, U2.6 (A)
RS485_B: J2.4, J3.4, R31.1, R32.2, U2.7 (B)
TCK: J4.1, U4.19 (PA14-BOOT0)
TMS: J4.3, U4.18 (PA13)
VDD: C3.1, C8.1, D2.1 (K), D3.1 (K), Q3.3 (D), R11.1, R24.2, TP1.1, U1.3 (VI)
主電源スイッチ: Q2.1 (G), R10.1, SW2.1 (A)

Notes on the sheet:
PowerModule
Conn to 5V
Conn
NRST
Encoder
インジケーターLED
主電源スイッチ
パスコン
書き込み
RS485
保護回路・スイッチ
5Pスイッチ
3.3V生成
TestPoint
マイコン
STLink
Crystal
C011F4
Capacitor
監視LED
I/O
MAX3485
