Tomoshibi-technology/RCJ-Japan2024-Circuit/Encoder/Encoder.kicad_pcb

## KiCad design Encoder/Encoder.kicad_pcb (continued)

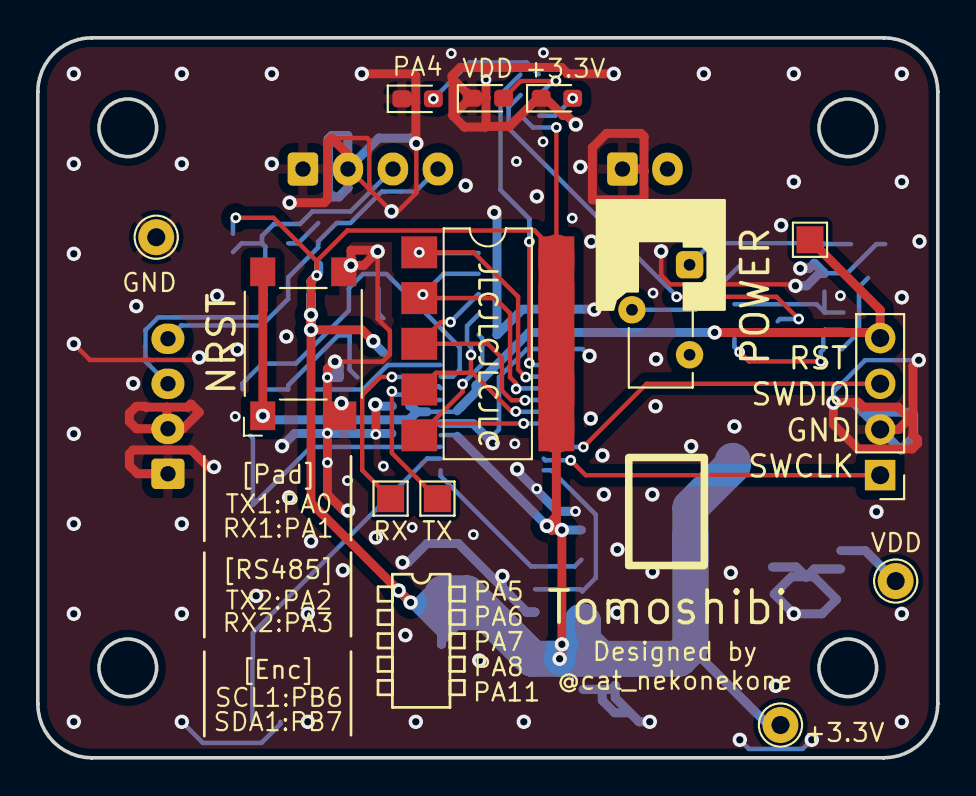
[picture p85: board Encoder.kicad_pcb from above]

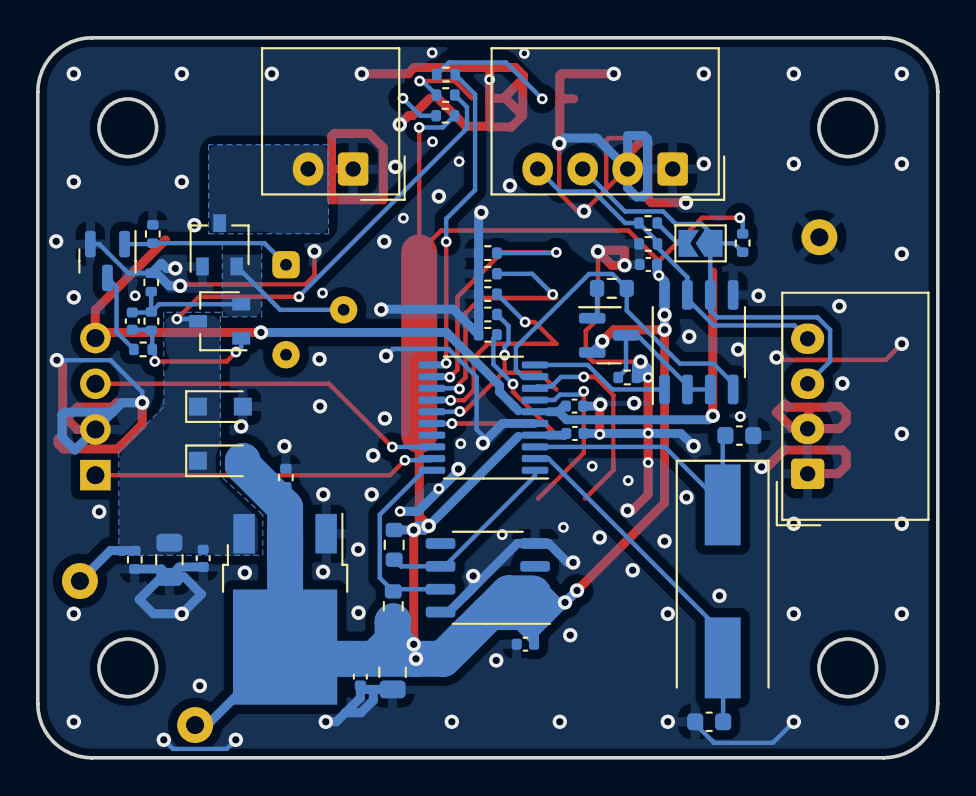
[picture p86: board Encoder.kicad_pcb from below]

Board: 2 copper layers, 50.0 x 40.0 mm, 60 parts (47 on the bottom side), 33 nets.
