Tomoshibi-technology/RCJ-Japan2024-Circuit/IR/IR.kicad_pcb

## KiCad design IR/IR.kicad_pcb (2024-02-10)

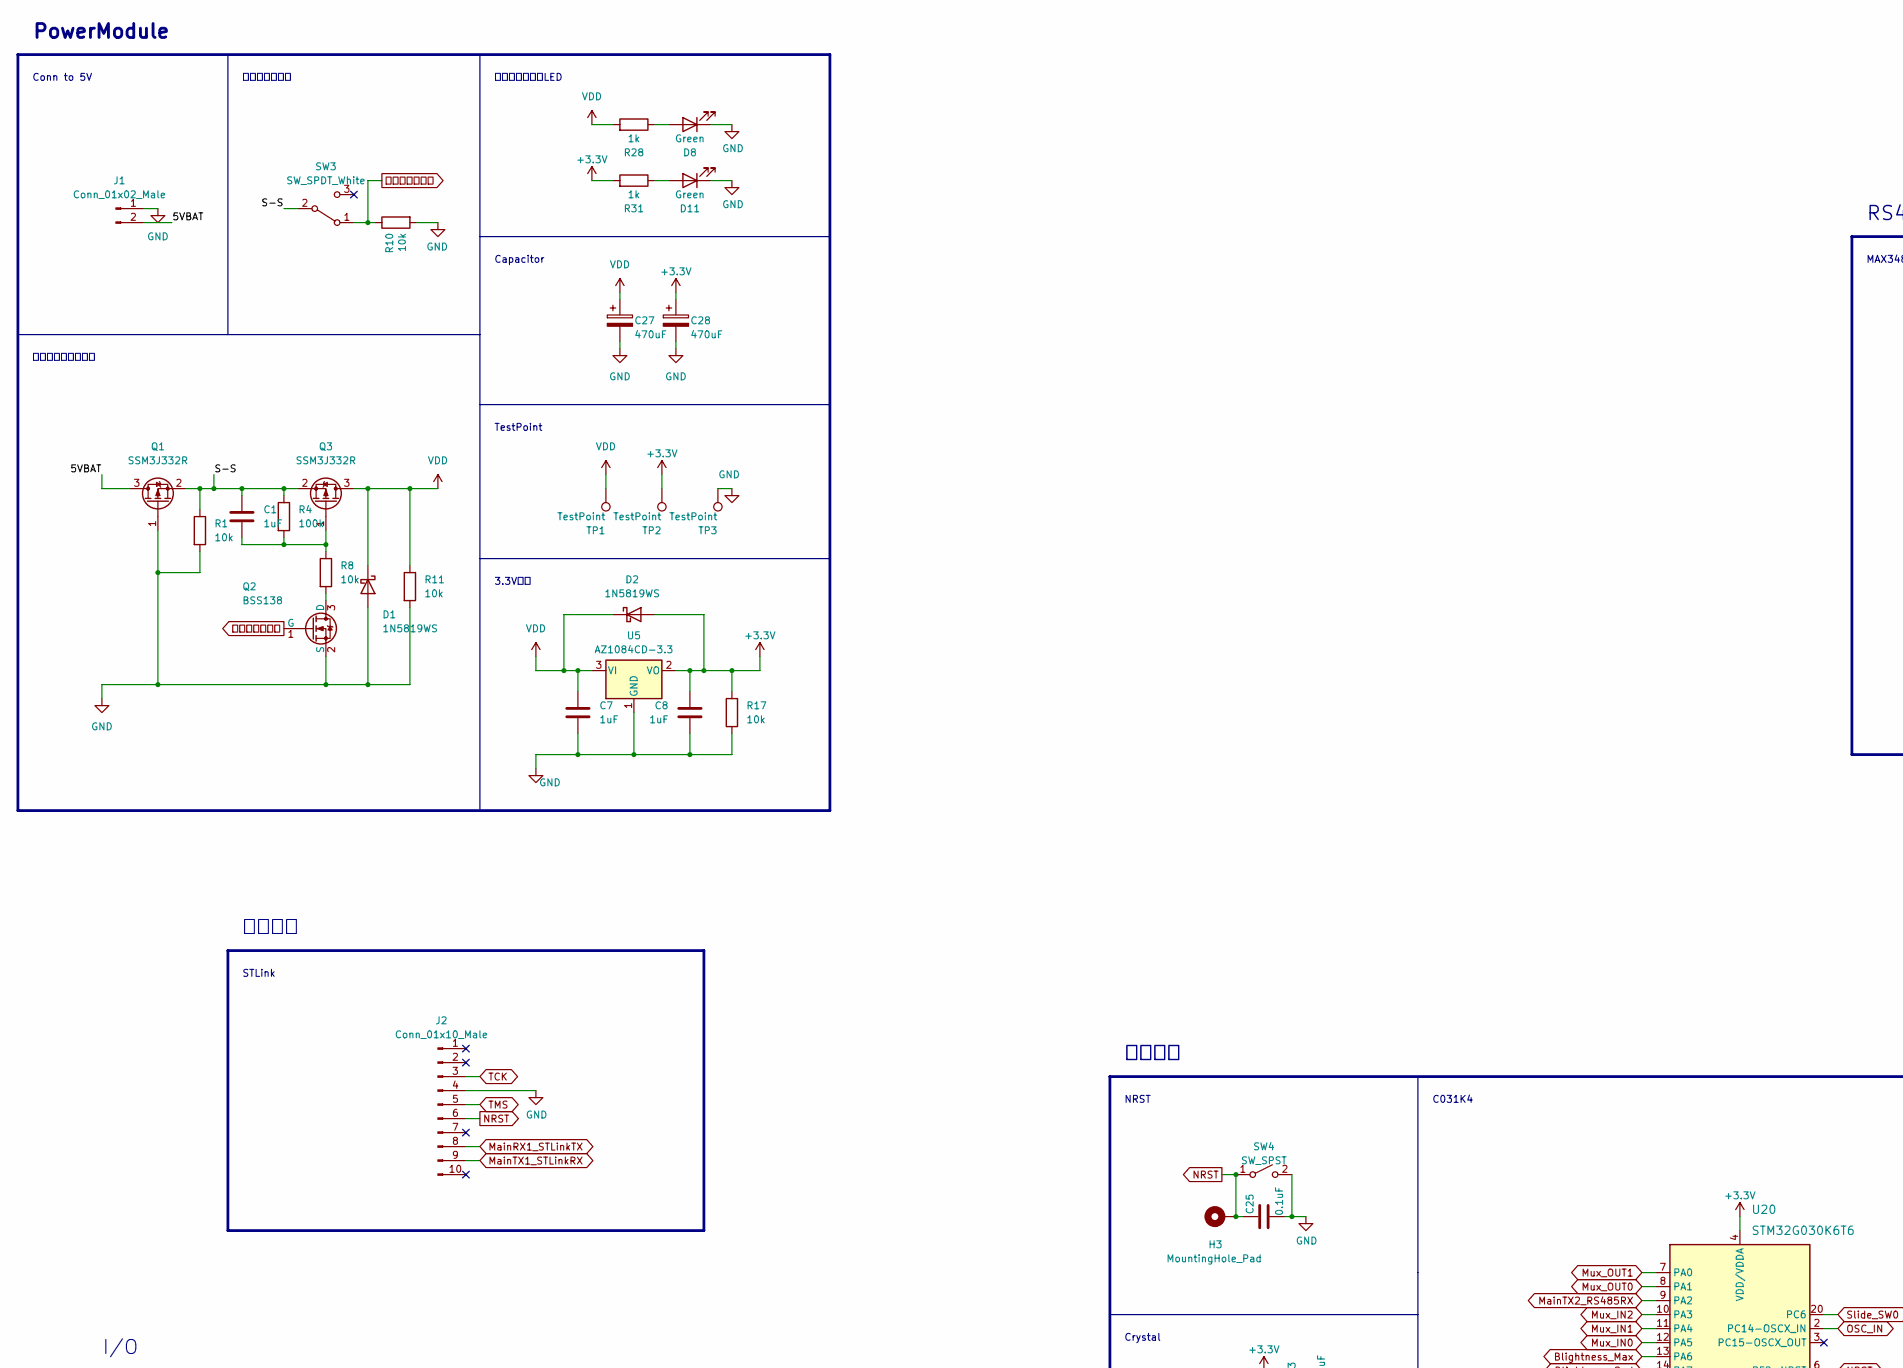
[picture p87: schematic IR.kicad_sch, part in row 1, column 1]

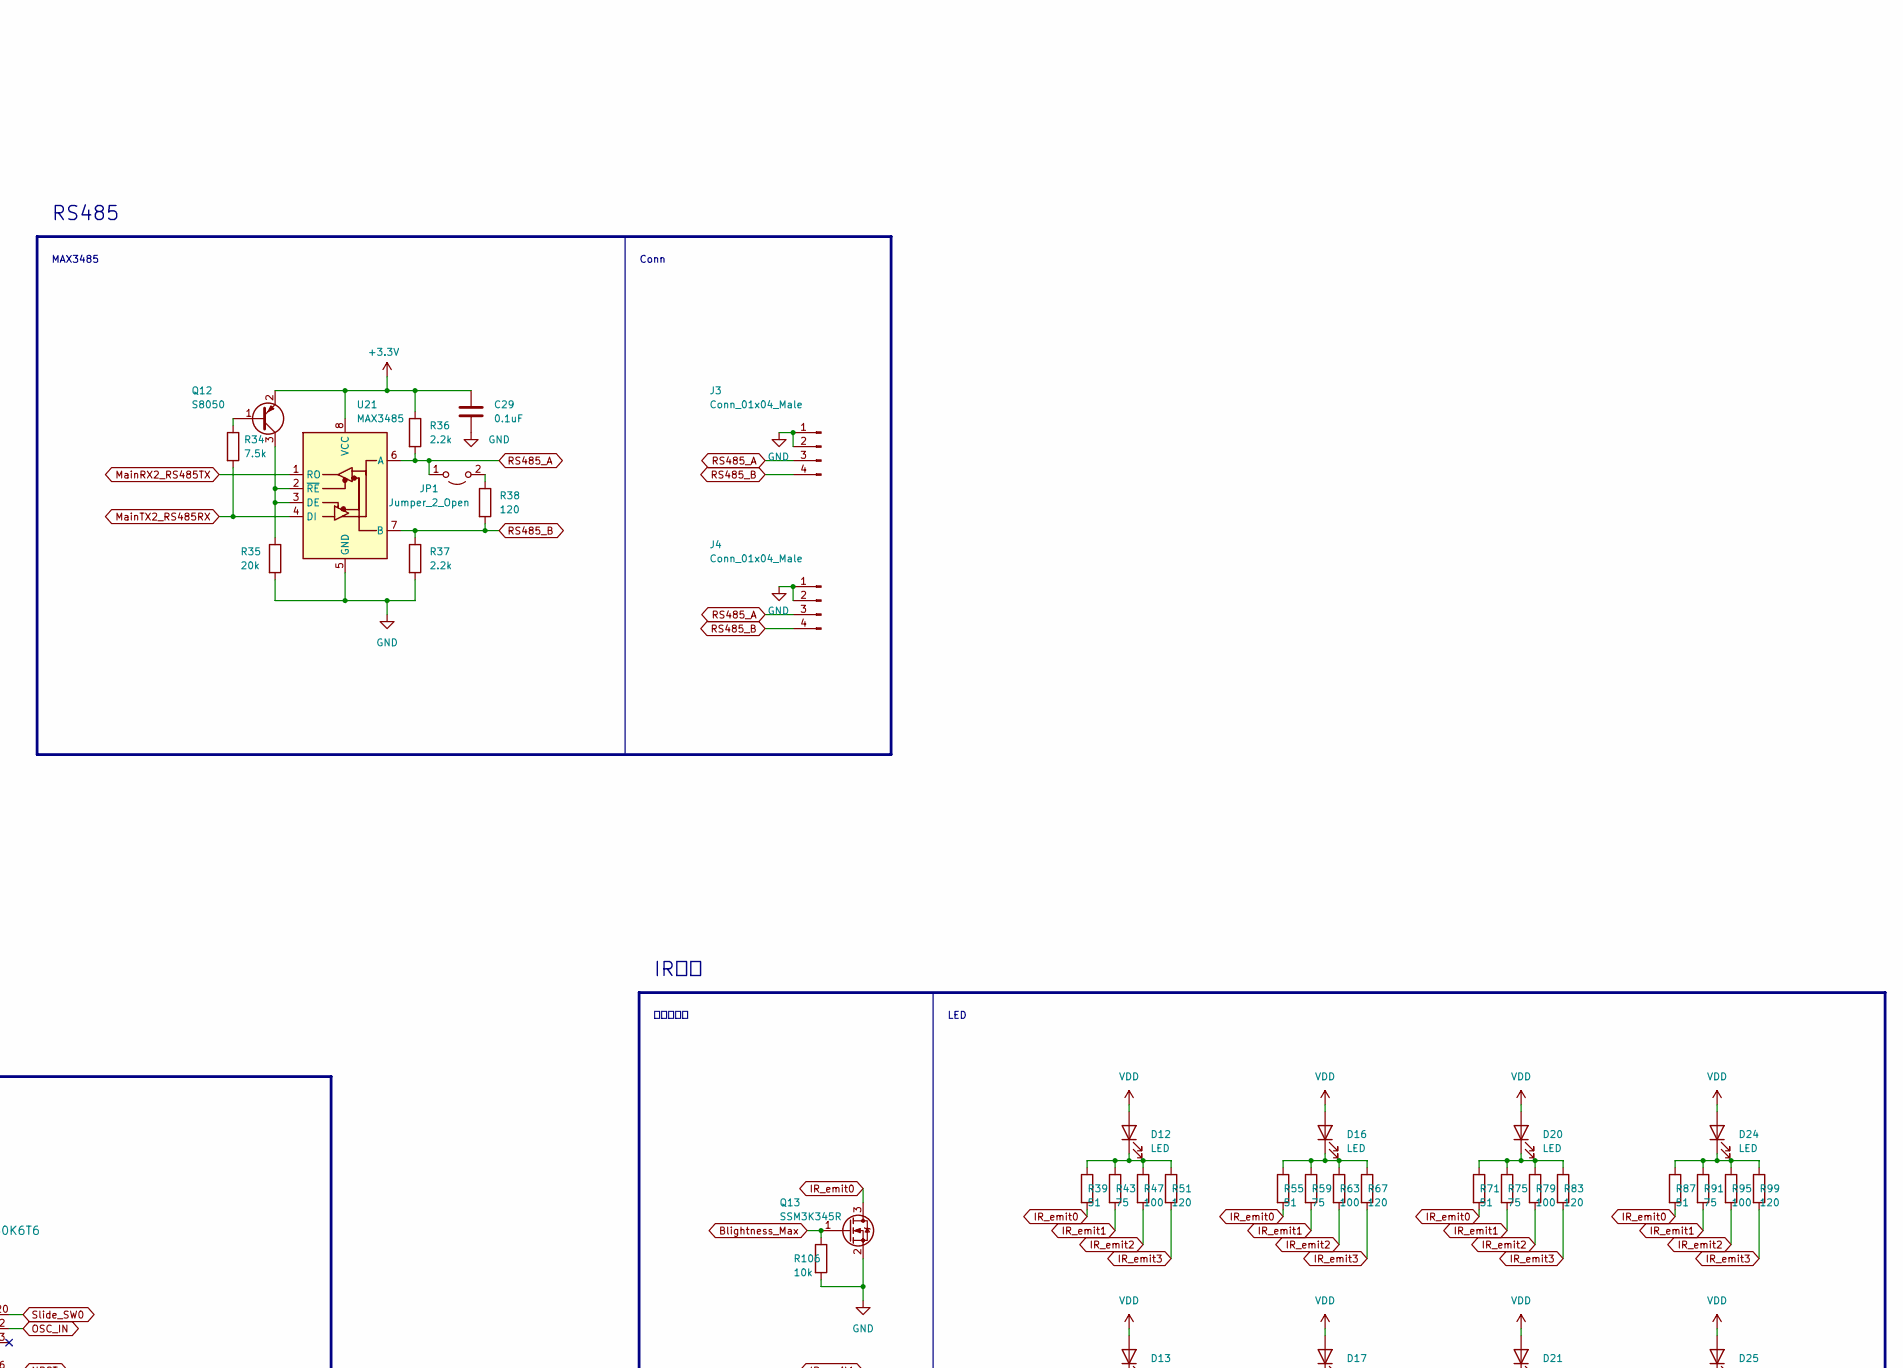
[picture p88: schematic IR.kicad_sch, part in row 1, column 2]

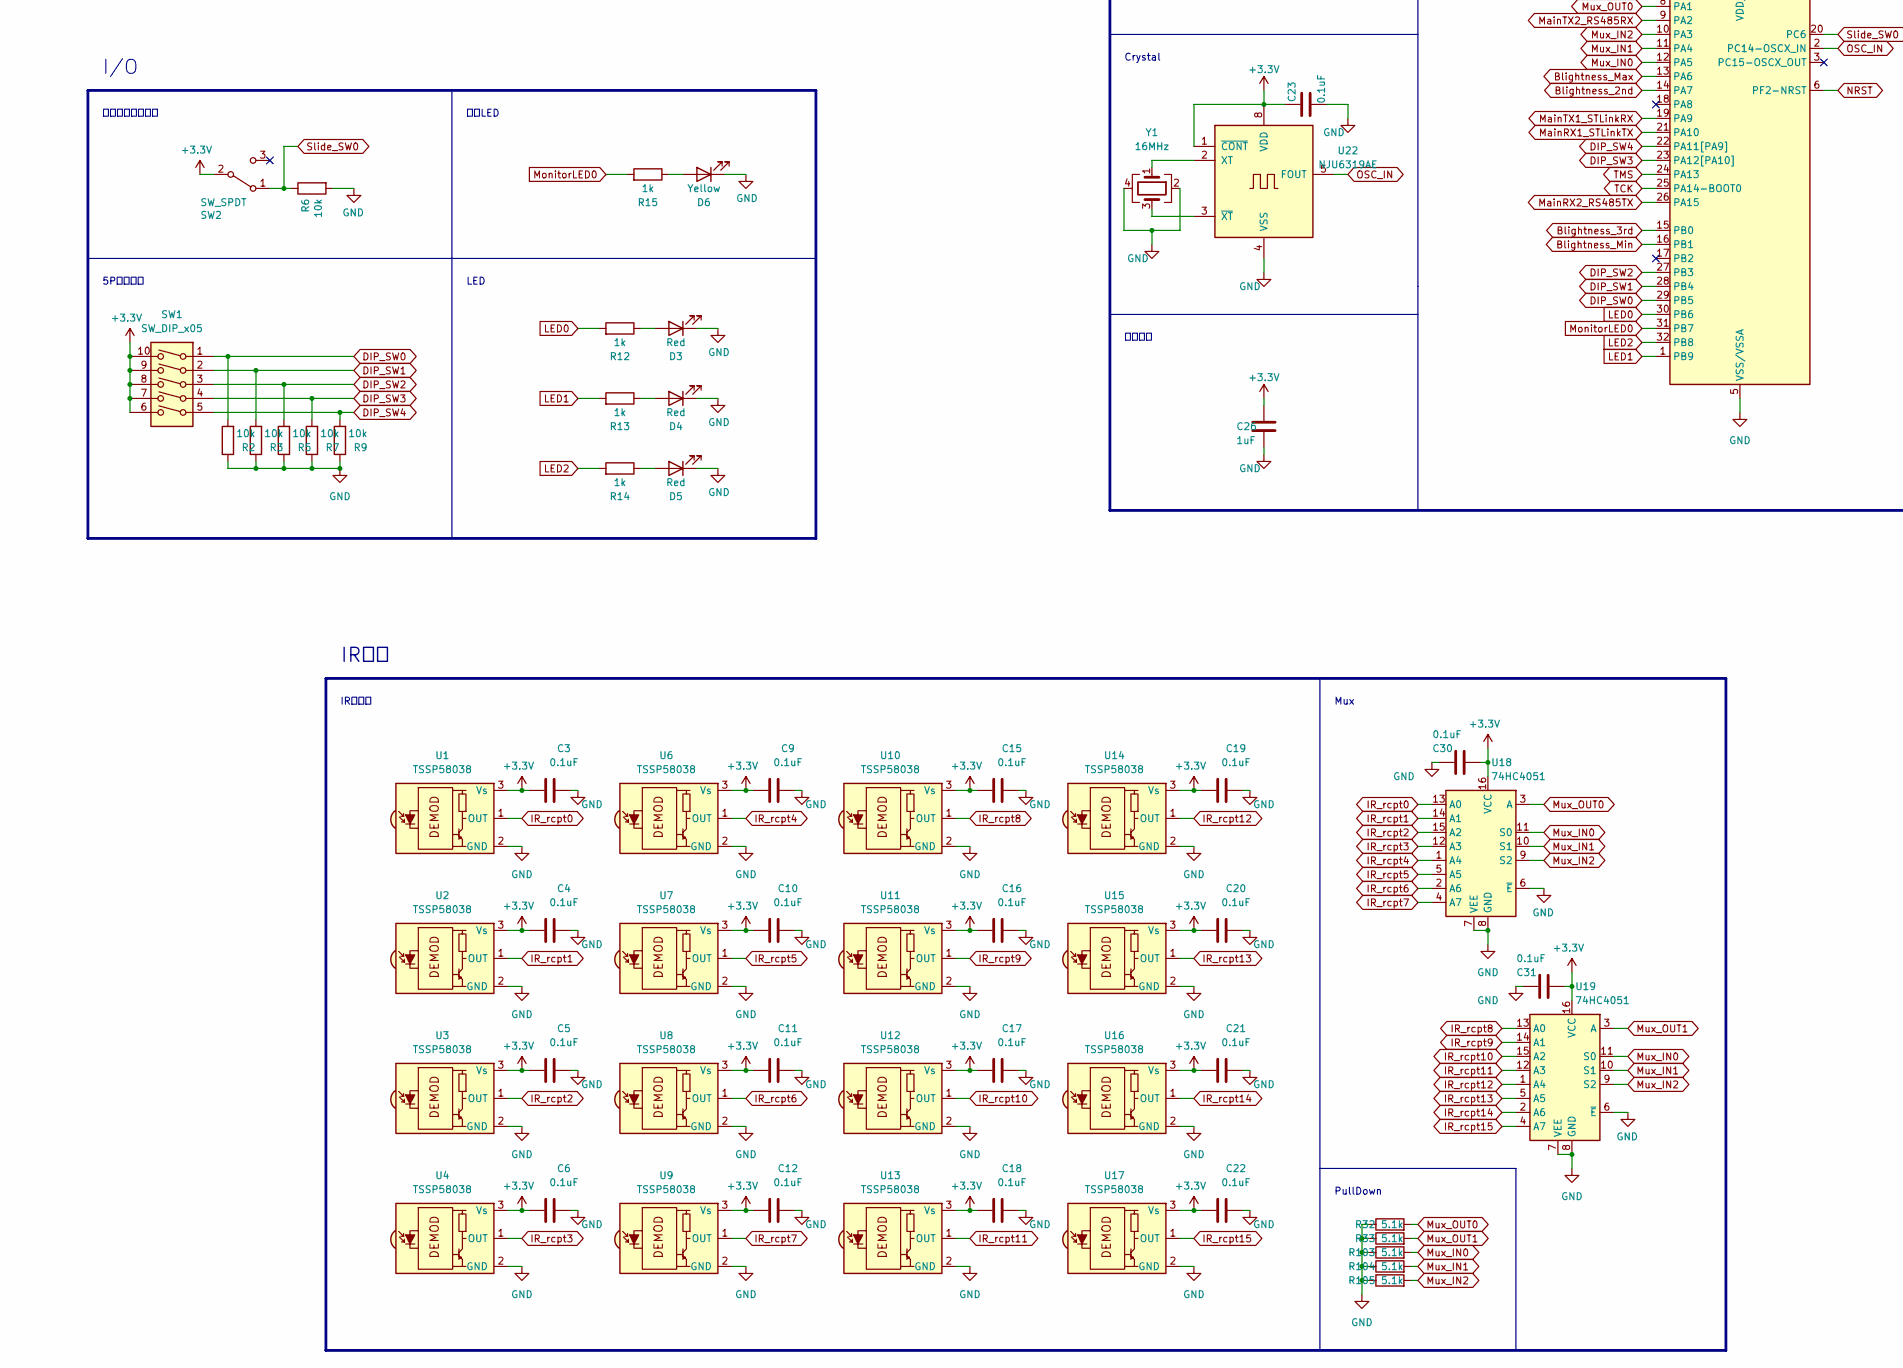
[picture p89: schematic IR.kicad_sch, part in row 2, column 1]

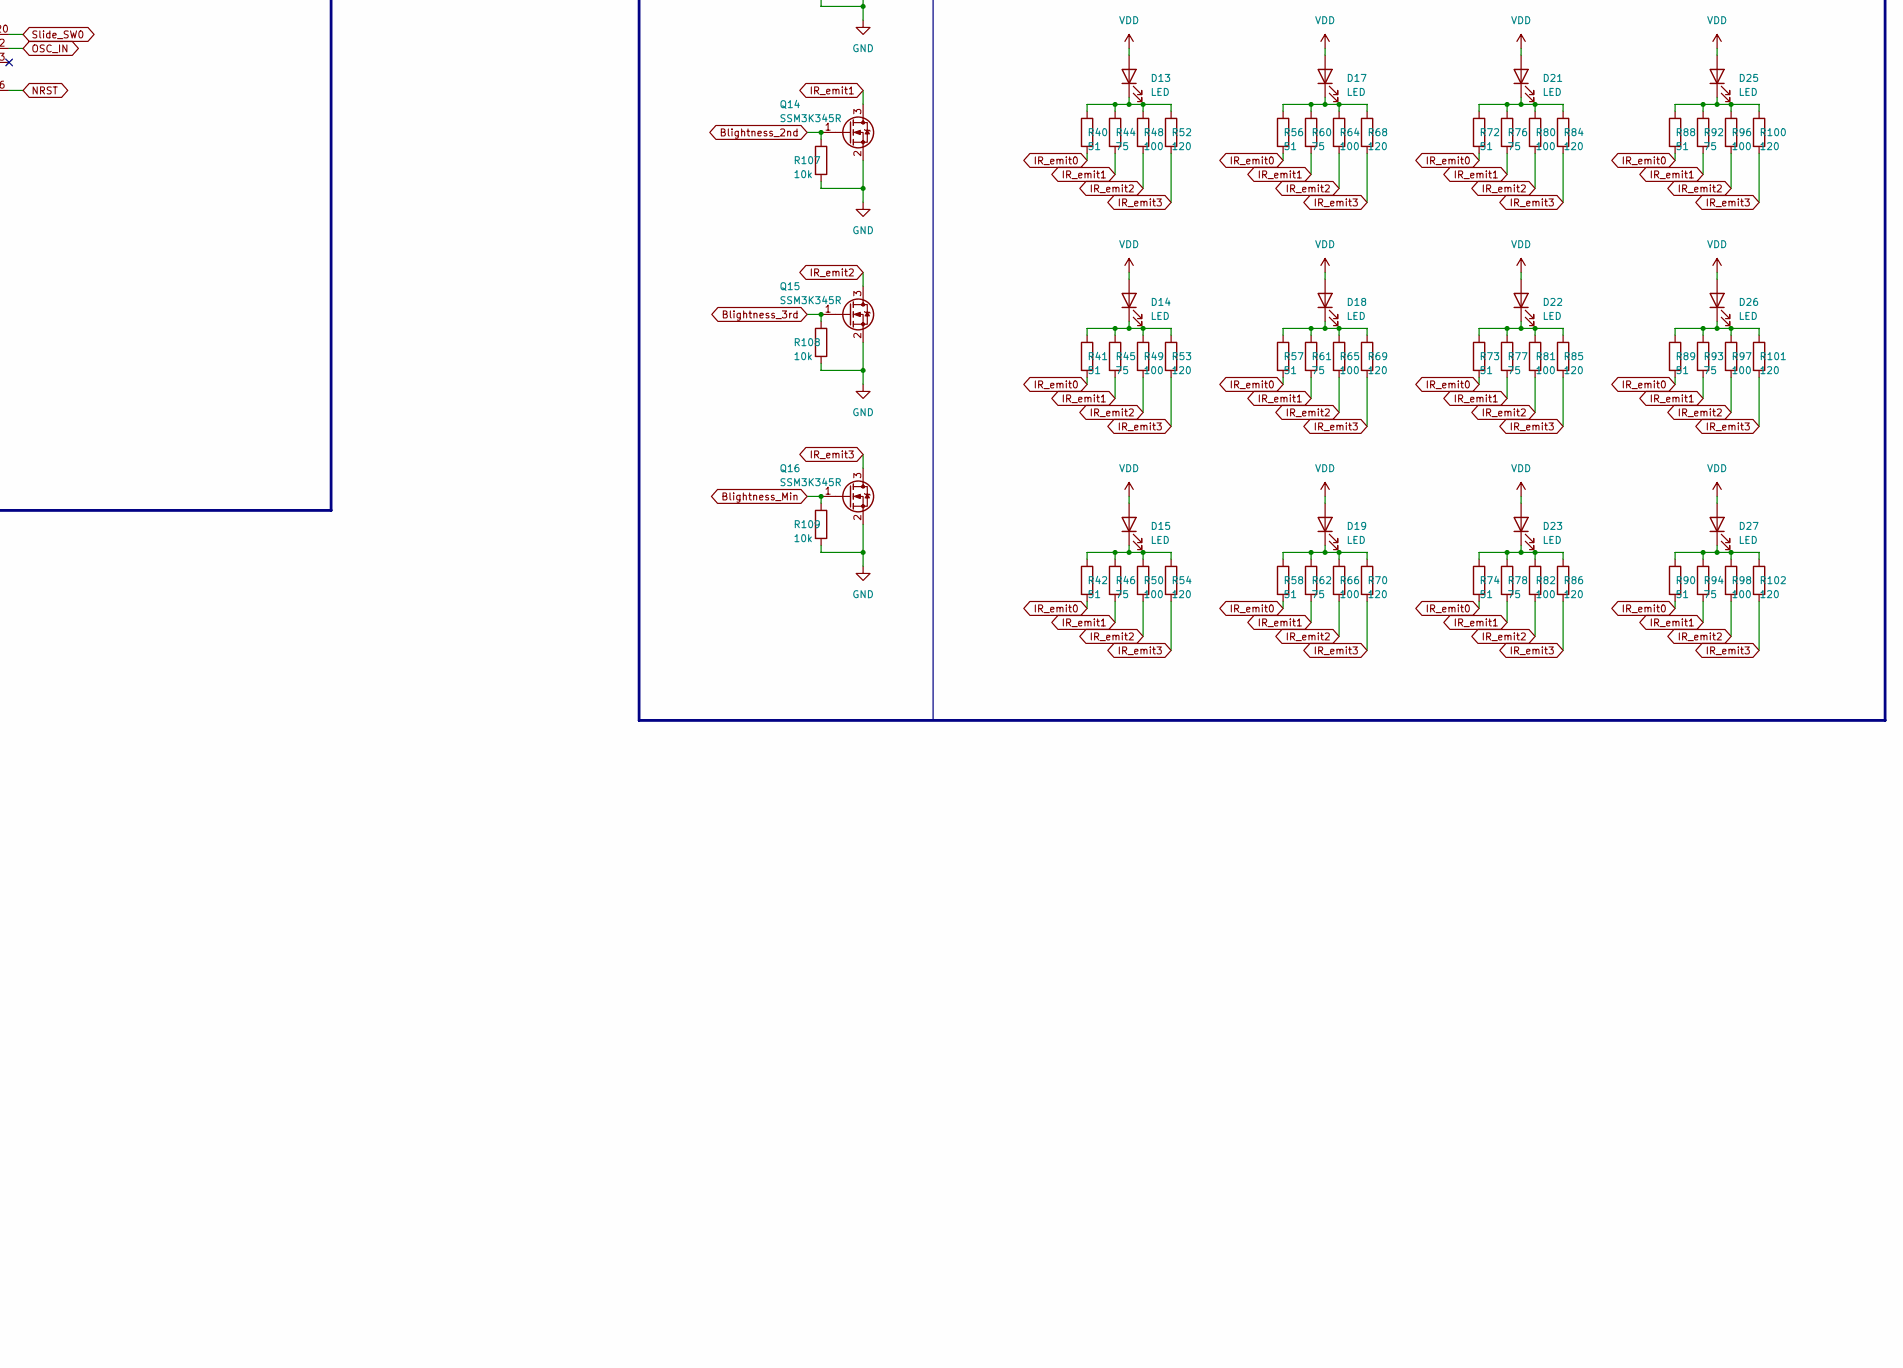
[picture p90: schematic IR.kicad_sch, part in row 2, column 2]

Parts:
C1, C7, C8, C26: 1uF; C_0402_1005Metric
C3, C4, C5, C6, C9, C10, C11, C12, C15, C16, C17, C18, C19, C20, C21, C22, C23, C25, C29, C30, C31: 0.1uF; C_0402_1005Metric
C27, C28: 470uF; C_Elec_8x10.2
D1, D2: 1N5819WS; D_SOD-323_HandSoldering
D3, D4, D5: Red; LED_0603_1608Metric_Pad1.05x0.95mm_HandSolder
D6: Yellow; LED_0603_1608Metric_Pad1.05x0.95mm_HandSolder
D8, D11: Green; LED_0603_1608Metric_Pad1.05x0.95mm_HandSolder
D12, D13, D14, D15, D16, D17, D18, D19, D20, D21, D22, D23, D24, D25, D26, D27: LED; LED_D3.0mm_Horizontal_O1.27mm_Z2.0mm
H3: MountingHole_Pad; TestPoint_Pad_1.5x1.5mm
J1: Conn_01x02_Male; Molex_SPOX_5267-02A_1x02_P2.50mm_Vertical
J2: Conn_01x10_Male; BoxHeader_2x05_P1.27mm_Vertical_SMD
J3, J4: Conn_01x04_Male; Molex_SPOX_5267-04A_1x04_P2.50mm_Vertical
JP1: Jumper_2_Open; PinHeader_1x02_P2.54mm_Vertical
Q1, Q3: SSM3J332R; SOT-23W
Q2: BSS138; SOT-23
Q12: S8050; SOT-23
Q13, Q14, Q15, Q16: SSM3K345R; SOT-23W
R1, R2, R3, R5, R6, R7, R8, R9, R10, R11, R17, R106, R107, R108, R109: 10k; R_0402_1005Metric
R4: 100k; R_0402_1005Metric
R12, R13, R14, R15, R28, R31: 1k; R_0402_1005Metric
R32, R33, R103, R104, R105: 5.1k; R_0402_1005Metric
R34: 7.5k; R_0603_1608Metric
R35: 20k; R_0402_1005Metric
R36, R37: 2.2k; R_0402_1005Metric
R38: 120; R_0402_1005Metric
R39, R40, R41, R42, R55, R56, R57, R58, R71, R72, R73, R74, R87, R88, R89, R90: 51; R_0603_1608Metric
R43, R44, R45, R46, R59, R60, R61, R62, R75, R76, R77, R78, R91, R92, R93, R94: 75; R_0603_1608Metric
R47, R48, R49, R50, R63, R64, R65, R66, R79, R80, R81, R82, R95, R96, R97, R98: 100; R_0603_1608Metric
R51, R52, R53, R54, R67, R68, R69, R70, R83, R84, R85, R86, R99, R100, R101, R102: 120; R_0603_1608Metric
SW1: SW_DIP_x05; DIP-10_W7.62mm
SW2: SW_SPDT; 3P_SPDT_SlideSwitch
SW3: SW_SPDT_White; SW_Slide_SPDT_White
SW4: SW_SPST; SW_SPST_Omron_B3FS-100xP
TP1, TP2, TP3: TestPoint; TestPoint_THTPad_D2.0mm_Drill1.0mm
U1, U2, U3, U4, U6, U7, U8, U9, U10, U11, U12, U13, U14, U15, U16, U17: TSSP58038; TSSP58038_LongPad
U5: AZ1084CD-3.3; TO-252-3_TabPin2
U18, U19: 74HC4051; TSSOP-16_4.4x5mm_P0.65mm
U20: STM32G030K6T6; LQFP-32_7x7mm_P0.8mm
U21: MAX3485; SOP-8_3.9x4.9mm_P1.27mm
U22: NJU6319AE; SOP-8_3.9x4.9mm_P1.27mm
Y1: 16MHz; Crystal_SMD_3225-4Pin_3.2x2.5mm_HandSoldering

Connections:
+3.3V: C3.1, C4.1, C5.1, C6.1, C8.1, C9.1, C10.1, C11.1, C12.1, C15.1, C16.1, C17.1, C18.1, C19.1, C20.1, C21.1, C22.1, C23.1, C26.1, C28.1, C29.1, C30.1, C31.1, D2.2 (A), Q12.2 (E), R17.2, R31.2, R36.1, SW1.6, SW1.7, SW1.8, SW1.9, SW1.10, SW2.2 (B), TP2.1, U1.3 (Vs), U2.3 (Vs), U3.3 (Vs), U4.3 (Vs), U5.2 (VO), U6.3 (Vs), U7.3 (Vs), U8.3 (Vs), U9.3 (Vs), U10.3 (Vs), U11.3 (Vs), U12.3 (Vs), U13.3 (Vs), U14.3 (Vs), U15.3 (Vs), U16.3 (Vs), U17.3 (Vs), U18.16 (VCC), U19.16 (VCC), U20.4 (VDD/VDDA), U21.8 (VCC), U22.1 (~CONT), U22.8 (VDD)
/5VBAT: J1.2, Q1.3 (D)
/S-S: C1.1, Q1.2 (S), Q3.2 (S), R1.1, R4.1, SW3.2 (B)
Blightness_2nd: Q14.1 (G), R107.1, U20.14 (PA7)
Blightness_3rd: Q15.1 (G), R108.1, U20.15 (PB0)
Blightness_Max: Q13.1 (G), R106.1, U20.13 (PA6)
Blightness_Min: Q16.1 (G), R109.1, U20.16 (PB1)
DIP_SW0: R2.2, SW1.1, U20.29 (PB5)
DIP_SW1: R3.2, SW1.2, U20.28 (PB4)
DIP_SW2: R5.2, SW1.3, U20.27 (PB3)
DIP_SW3: R7.2, SW1.4, U20.23 (PA12[PA10])
DIP_SW4: R9.2, SW1.5, U20.22 (PA11[PA9])
GND: C3.2, C4.2, C5.2, C6.2, C7.2, C8.2, C9.2, C10.2, C11.2, C12.2, C15.2, C16.2, C17.2, C18.2, C19.2, C20.2, C21.2, C22.2, C23.2, C25.2, C26.2, C27.2, C28.2, C29.2, C30.2, C31.2, D1.2 (A), D3.1 (K), D4.1 (K), D5.1 (K), D6.1 (K), D8.1 (K), D11.1 (K), J1.1, J2.4, J3.1, J3.2, J4.1, J4.2, Q1.1 (G), Q2.2 (S), Q13.2 (S), Q14.2 (S), Q15.2 (S), Q16.2 (S), R1.2, R2.1, R3.1, R5.1, R6.2, R7.1, R9.1, R10.2, R11.2, R17.1, R32.1, R33.1, R35.2, R37.2, R103.1, R104.1, R105.1, R106.2, R107.2, R108.2, R109.2, SW4.2 (B), TP3.1, U1.2 (GND), U2.2 (GND), U3.2 (GND), U4.2 (GND), U5.1 (GND), U6.2 (GND), U7.2 (GND), U8.2 (GND), U9.2 (GND), U10.2 (GND), U11.2 (GND), U12.2 (GND), U13.2 (GND), U14.2 (GND), U15.2 (GND), U16.2 (GND), U17.2 (GND), U18.6 (~E), U18.7 (VEE), U18.8 (GND), U19.6 (~E), U19.7 (VEE), U19.8 (GND), U20.5 (VSS/VSSA), U21.5 (GND), U22.4 (VSS), Y1.2, Y1.4
IR_emit0: Q13.3 (D), R39.2, R40.2, R41.2, R42.2, R55.2, R56.2, R57.2, R58.2, R71.2, R72.2, R73.2, R74.2, R87.2, R88.2, R89.2, R90.2
IR_emit1: Q14.3 (D), R43.2, R44.2, R45.2, R46.2, R59.2, R60.2, R61.2, R62.2, R75.2, R76.2, R77.2, R78.2, R91.2, R92.2, R93.2, R94.2
IR_emit2: Q15.3 (D), R47.2, R48.2, R49.2, R50.2, R63.2, R64.2, R65.2, R66.2, R79.2, R80.2, R81.2, R82.2, R95.2, R96.2, R97.2, R98.2
IR_emit3: Q16.3 (D), R51.2, R52.2, R53.2, R54.2, R67.2, R68.2, R69.2, R70.2, R83.2, R84.2, R85.2, R86.2, R99.2, R100.2, R101.2, R102.2
IR_rcpt0: U1.1 (OUT), U18.13 (A0)
IR_rcpt1: U2.1 (OUT), U18.14 (A1)
IR_rcpt2: U3.1 (OUT), U18.15 (A2)
IR_rcpt3: U4.1 (OUT), U18.12 (A3)
IR_rcpt4: U6.1 (OUT), U18.1 (A4)
IR_rcpt5: U7.1 (OUT), U18.5 (A5)
IR_rcpt6: U8.1 (OUT), U18.2 (A6)
IR_rcpt7: U9.1 (OUT), U18.4 (A7)
IR_rcpt8: U10.1 (OUT), U19.13 (A0)
IR_rcpt9: U11.1 (OUT), U19.14 (A1)
IR_rcpt10: U12.1 (OUT), U19.15 (A2)
IR_rcpt11: U13.1 (OUT), U19.12 (A3)
IR_rcpt12: U14.1 (OUT), U19.1 (A4)
IR_rcpt13: U15.1 (OUT), U19.5 (A5)
IR_rcpt14: U16.1 (OUT), U19.2 (A6)
IR_rcpt15: U17.1 (OUT), U19.4 (A7)
LED0: R12.2, U20.30 (PB6)
LED1: R13.2, U20.1 (PB9)
LED2: R14.2, U20.32 (PB8)
MainRX1_STLinkTX: J2.8, U20.21 (PA10)
MainRX2_RS485TX: U20.26 (PA15), U21.1 (RO)
MainTX1_STLinkRX: J2.9, U20.19 (PA9)
MainTX2_RS485RX: R34.2, U20.9 (PA2), U21.4 (DI)
MonitorLED0: R15.2, U20.31 (PB7)
Mux_IN0: R103.2, U18.11 (S0), U19.11 (S0), U20.12 (PA5)
Mux_IN1: R104.2, U18.10 (S1), U19.10 (S1), U20.11 (PA4)
Mux_IN2: R105.2, U18.9 (S2), U19.9 (S2), U20.10 (PA3)
Mux_OUT0: R32.2, U18.3 (A), U20.8 (PA1)
Mux_OUT1: R33.2, U19.3 (A), U20.7 (PA0)
NRST: C25.1, H3.1, J2.6, SW4.1 (A), U20.6 (PF2-NRST)
unnamed: C1.2, Q3.1 (G), R4.2, R8.1
unnamed: D3.2 (A), R12.1
unnamed: D4.2 (A), R13.1
unnamed: D5.2 (A), R14.1
unnamed: D6.2 (A), R15.1
unnamed: D8.2 (A), R28.1
unnamed: D11.2 (A), R31.1
unnamed: D12.1 (K), R39.1, R43.1, R47.1, R51.1
unnamed: D13.1 (K), R40.1, R44.1, R48.1, R52.1
unnamed: D14.1 (K), R41.1, R45.1, R49.1, R53.1
unnamed: D15.1 (K), R42.1, R46.1, R50.1, R54.1
unnamed: D16.1 (K), R55.1, R59.1, R63.1, R67.1
unnamed: D17.1 (K), R56.1, R60.1, R64.1, R68.1
unnamed: D18.1 (K), R57.1, R61.1, R65.1, R69.1
unnamed: D19.1 (K), R58.1, R62.1, R66.1, R70.1
unnamed: D20.1 (K), R71.1, R75.1, R79.1, R83.1
unnamed: D21.1 (K), R72.1, R76.1, R80.1, R84.1
unnamed: D22.1 (K), R73.1, R77.1, R81.1, R85.1
unnamed: D23.1 (K), R74.1, R78.1, R82.1, R86.1
unnamed: D24.1 (K), R87.1, R91.1, R95.1, R99.1
unnamed: D25.1 (K), R88.1, R92.1, R96.1, R100.1
unnamed: D26.1 (K), R89.1, R93.1, R97.1, R101.1
unnamed: D27.1 (K), R90.1, R94.1, R98.1, R102.1
unnamed: JP1.2 (B), R38.1
unnamed: Q2.3 (D), R8.2
unnamed: Q12.1 (B), R34.1
unnamed: Q12.3 (C), R35.1, U21.2 (~RE), U21.3 (DE)
unnamed: U22.2 (XT), Y1.1
unnamed: U22.3 (~XT), Y1.3
OSC_IN: U20.2 (PC14-OSCX_IN), U22.5 (FOUT)
RS485_A: J3.3, J4.3, JP1.1 (A), R36.2, U21.6 (A)
RS485_B: J3.4, J4.4, R37.1, R38.2, U21.7 (B)
Slide_SW0: R6.1, SW2.1 (A), U20.20 (PC6)
TCK: J2.3, U20.25 (PA14-BOOT0)
TMS: J2.5, U20.24 (PA13)
VDD: C7.1, C27.1, D1.1 (K), D2.1 (K), D12.2 (A), D13.2 (A), D14.2 (A), D15.2 (A), D16.2 (A), D17.2 (A), D18.2 (A), D19.2 (A), D20.2 (A), D21.2 (A), D22.2 (A), D23.2 (A), D24.2 (A), D25.2 (A), D26.2 (A), D27.2 (A), Q3.3 (D), R11.1, R28.2, TP1.1, U5.3 (VI)
主電源スイッチ: Q2.1 (G), R10.1, SW3.1 (A)

Notes on the sheet:
RS485
Mux
MAX3485
IRセンサ
I/O
Conn to 5V
TestPoint
C031K4
保護回路・スイッチ
STLink
パスコン
明るさ制御
Crystal
監視LED
PowerModule
Capacitor
スライドスイッチ
3.3V生成
5Pスイッチ
マイコン
NRST
IR受光
インジケーターLED
LED
Conn
主電源スイッチ
IR発光
PullDown
書き込み

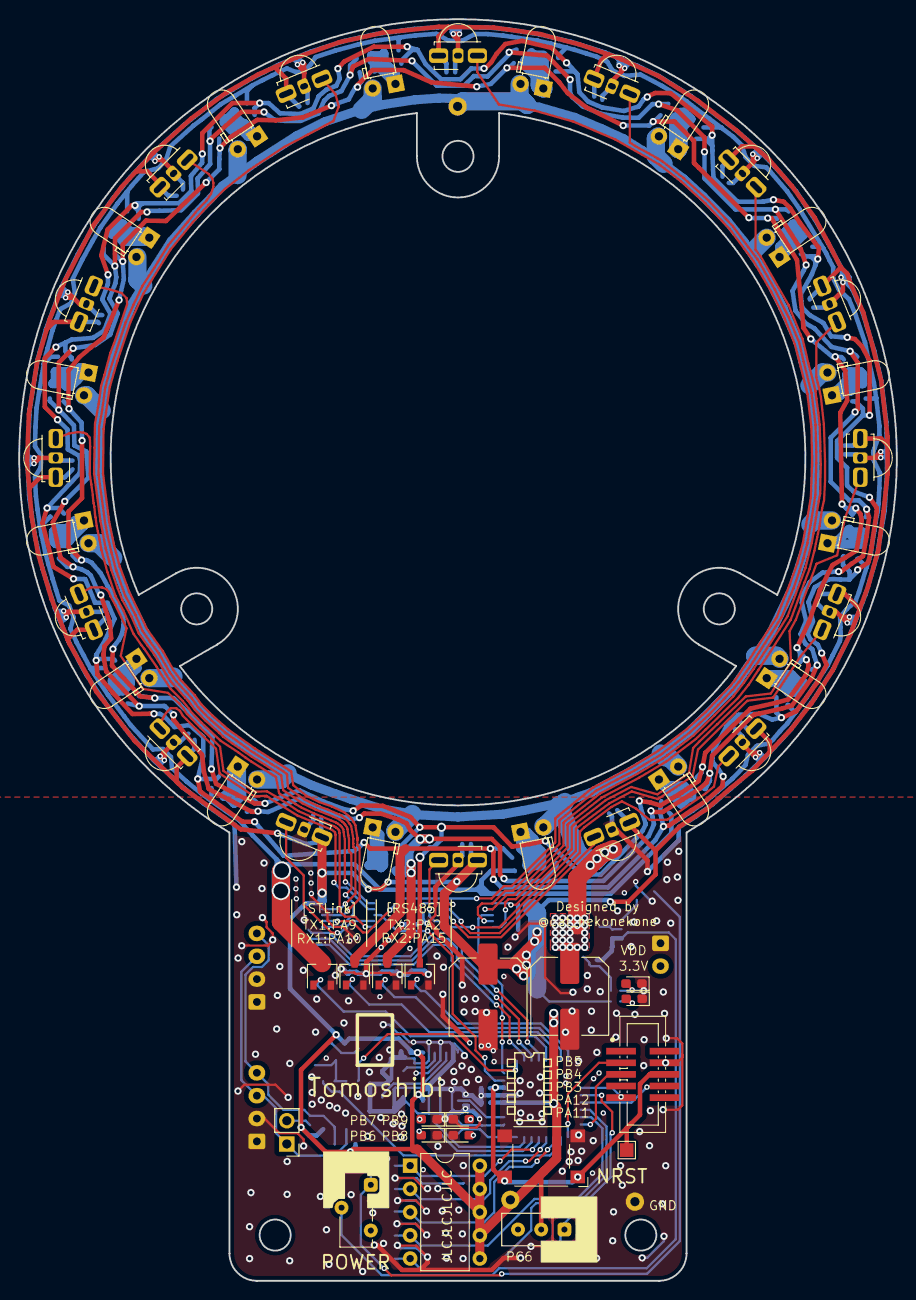
[picture p91: board IR.kicad_pcb from above]

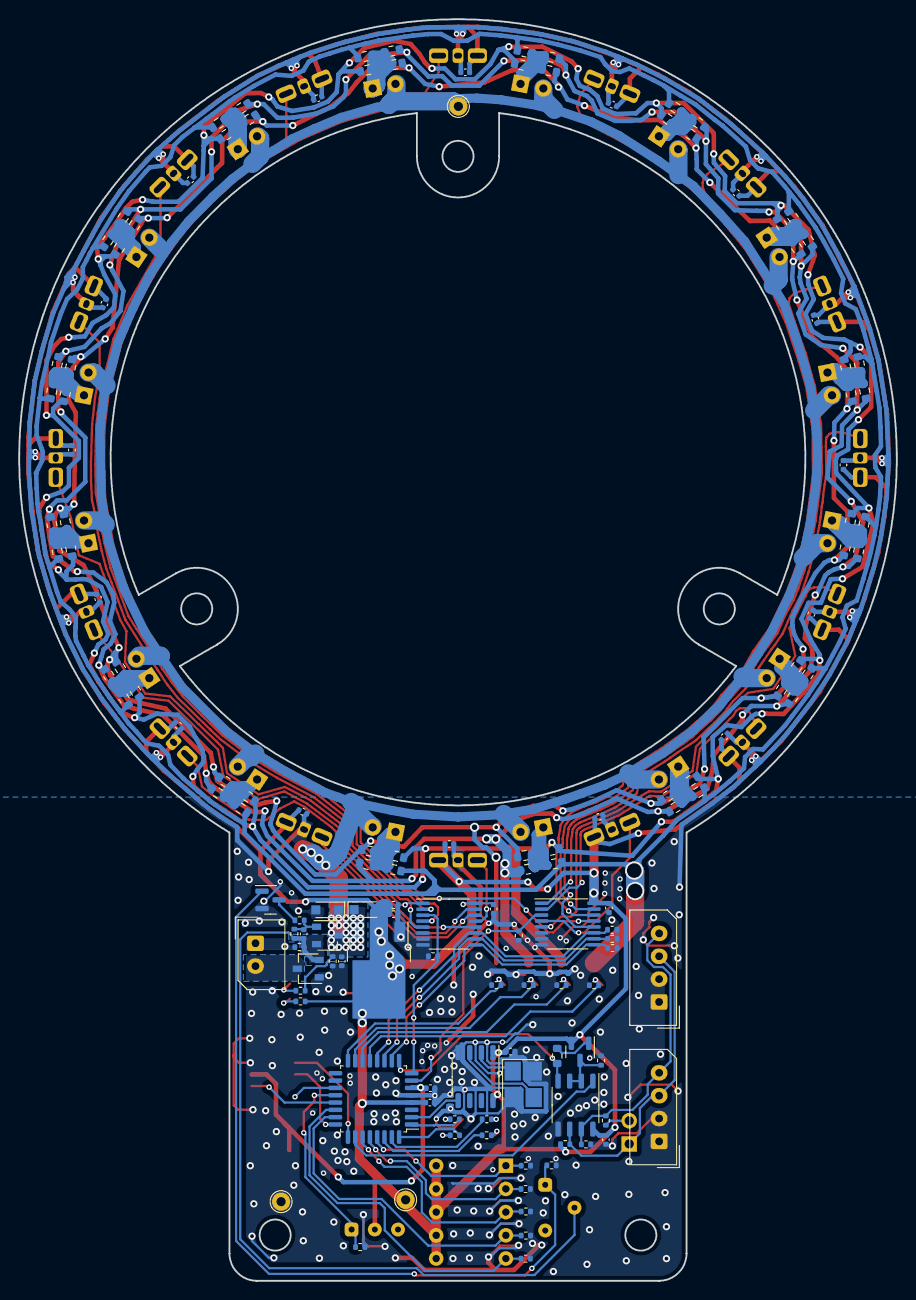
[picture p92: board IR.kicad_pcb from below]

Board: 2 copper layers, 96.0 x 138.0 mm, 191 parts (140 on the bottom side), 84 nets.
