Tomoshibi-technology/RCJ-Japan2024-Circuit/SmallPW/SmallPW.kicad_pcb

## KiCad design SmallPW/SmallPW.kicad_pcb (2024-02-10)

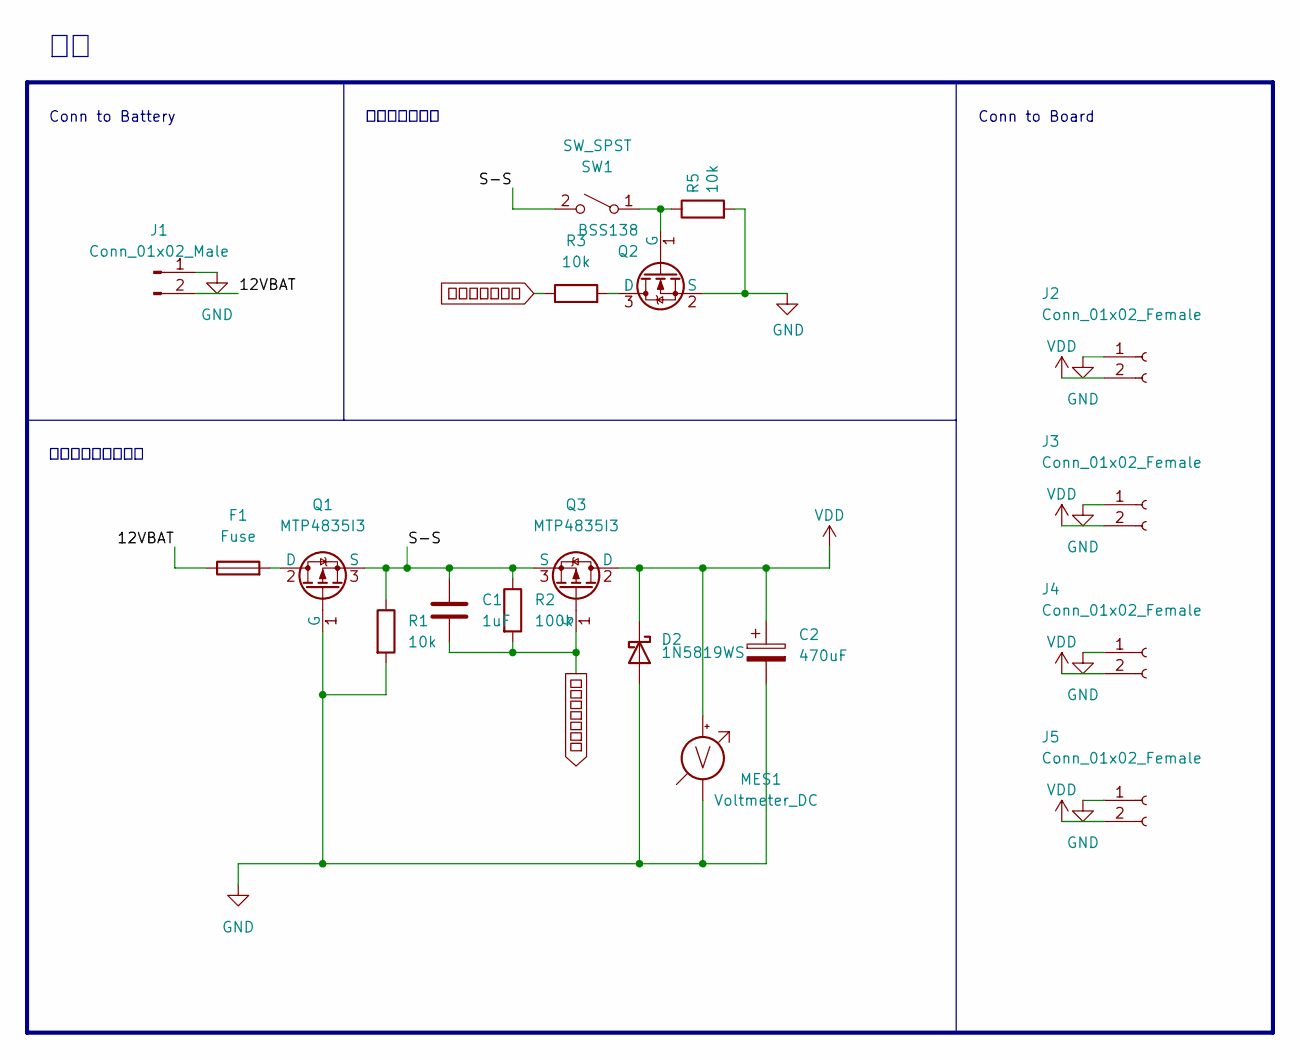
[picture p93: schematic SmallPW.kicad_sch]

Parts:
C1: 1uF; C_0603_1608Metric_Pad1.08x0.95mm_HandSolder
C2: 470uF; C_Elec_8x10.2
D2: 1N5819WS; D_SOD-323_HandSoldering
F1: Fuse; Fuseholder_Blade_Mini_Keystone_3568
J1: Conn_01x02_Male; AMASS_XT30U-M_1x02_P5.0mm_Vertical
J2, J3, J4, J5: Conn_01x02_Female; AMASS_XT30U-F_1x02_P5.0mm_Vertical
MES1: Voltmeter_DC; SuperSmallVoltmeter_twoline
Q1, Q3: MTP4835I3; TO-252-3_TabPin2
Q2: BSS138; SOT-23
R1, R3, R5: 10k; R_0603_1608Metric_Pad0.98x0.95mm_HandSolder
R2: 100k; R_0603_1608Metric_Pad0.98x0.95mm_HandSolder
SW1: SW_SPST; DS-850K-S-ON

Connections:
/12VBAT: F1.1, J1.2
/S-S: C1.1, Q1.3 (S), Q3.3 (S), R1.1, R2.1, SW1.2 (B)
GND: C2.2, D2.2 (A), J1.1, J2.1, J3.1, J4.1, J5.1, MES1.1 (-), Q1.1 (G), Q2.2 (S), R1.2, R5.2
unnamed: F1.2, Q1.2 (D)
unnamed: Q2.1 (G), R5.1, SW1.1 (A)
unnamed: Q2.3 (D), R3.2
VDD: C2.1, D2.1 (K), J2.2, J3.2, J4.2, J5.2, MES1.2 (+), Q3.2 (D)
主電源スイッチ: C1.2, Q3.1 (G), R2.2, R3.1

Notes on the sheet:
Conn to Board
Conn to Battery
保護回路・スイッチ
主電源スイッチ

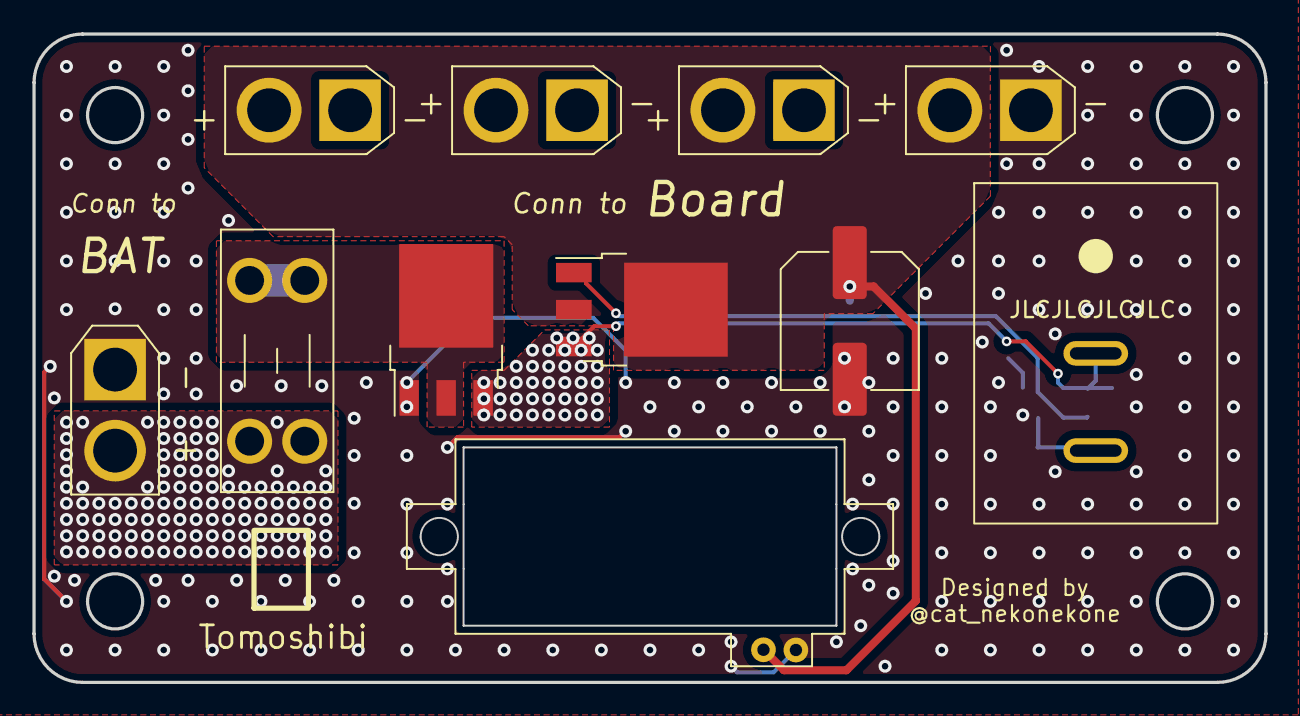
[picture p94: board SmallPW.kicad_pcb from above]

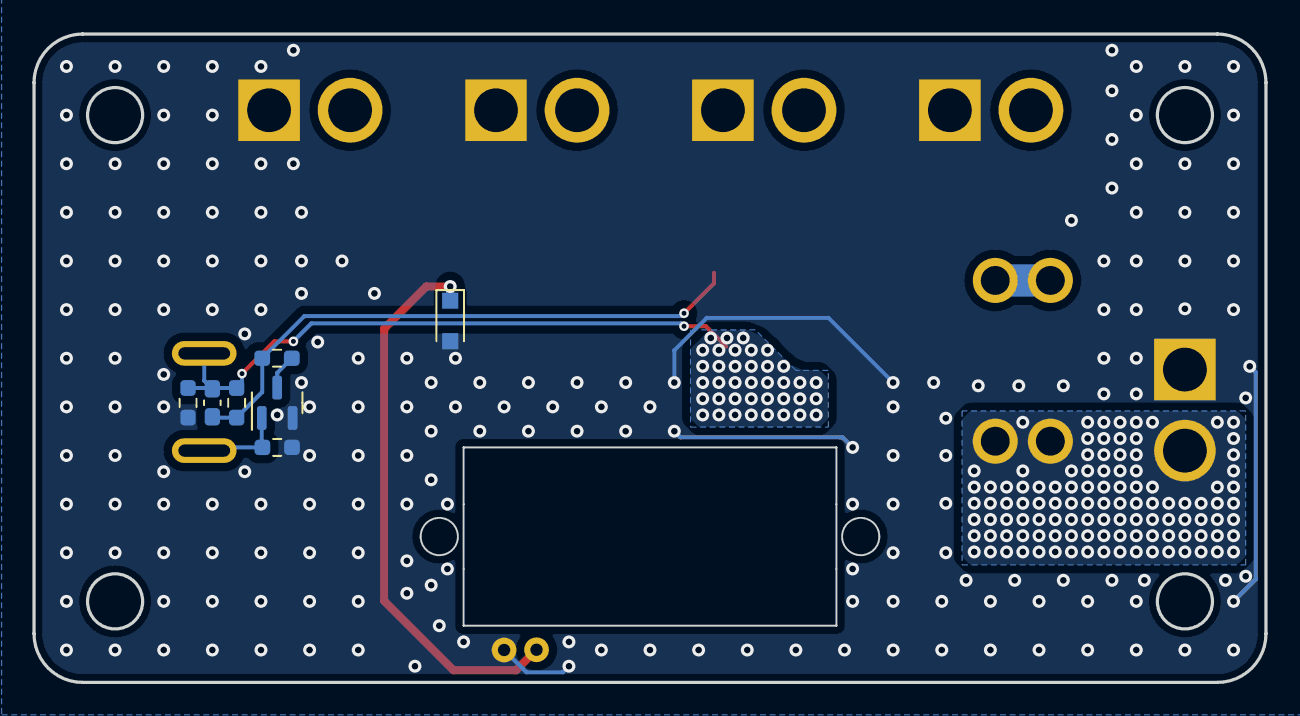
[picture p95: board SmallPW.kicad_pcb from below]

Board: 2 copper layers, 76.0 x 40.0 mm, 18 parts (7 on the bottom side), 8 nets.
