Tomoshibi-technology/RCJ-Japan2024-Circuit/SmallMD/SmallMD.kicad_pcb

## KiCad design SmallMD/SmallMD.kicad_pcb (2024-02-10)

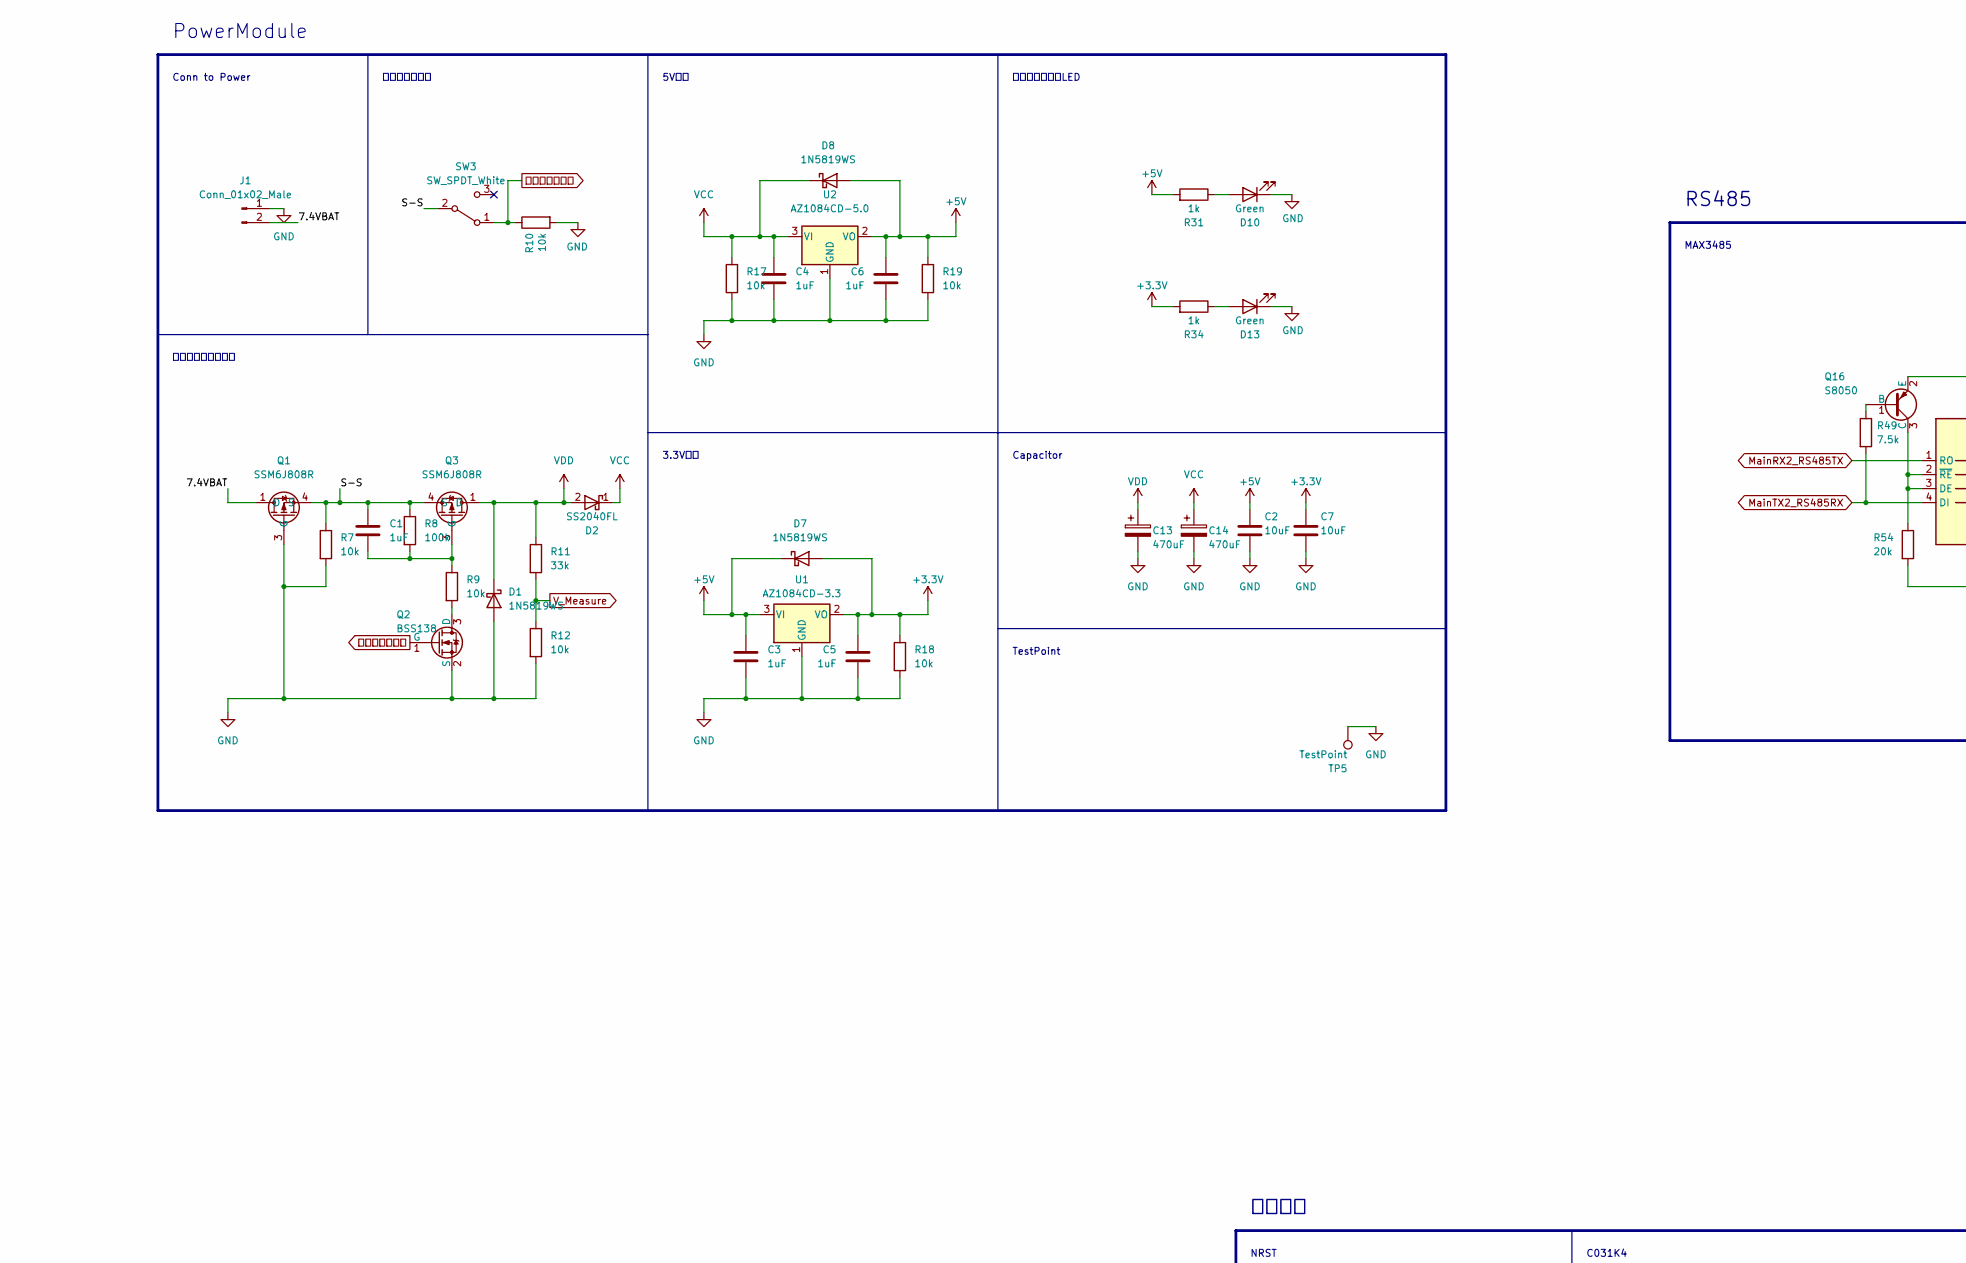
[picture p96: schematic SmallMD.kicad_sch, part in row 1, column 1]

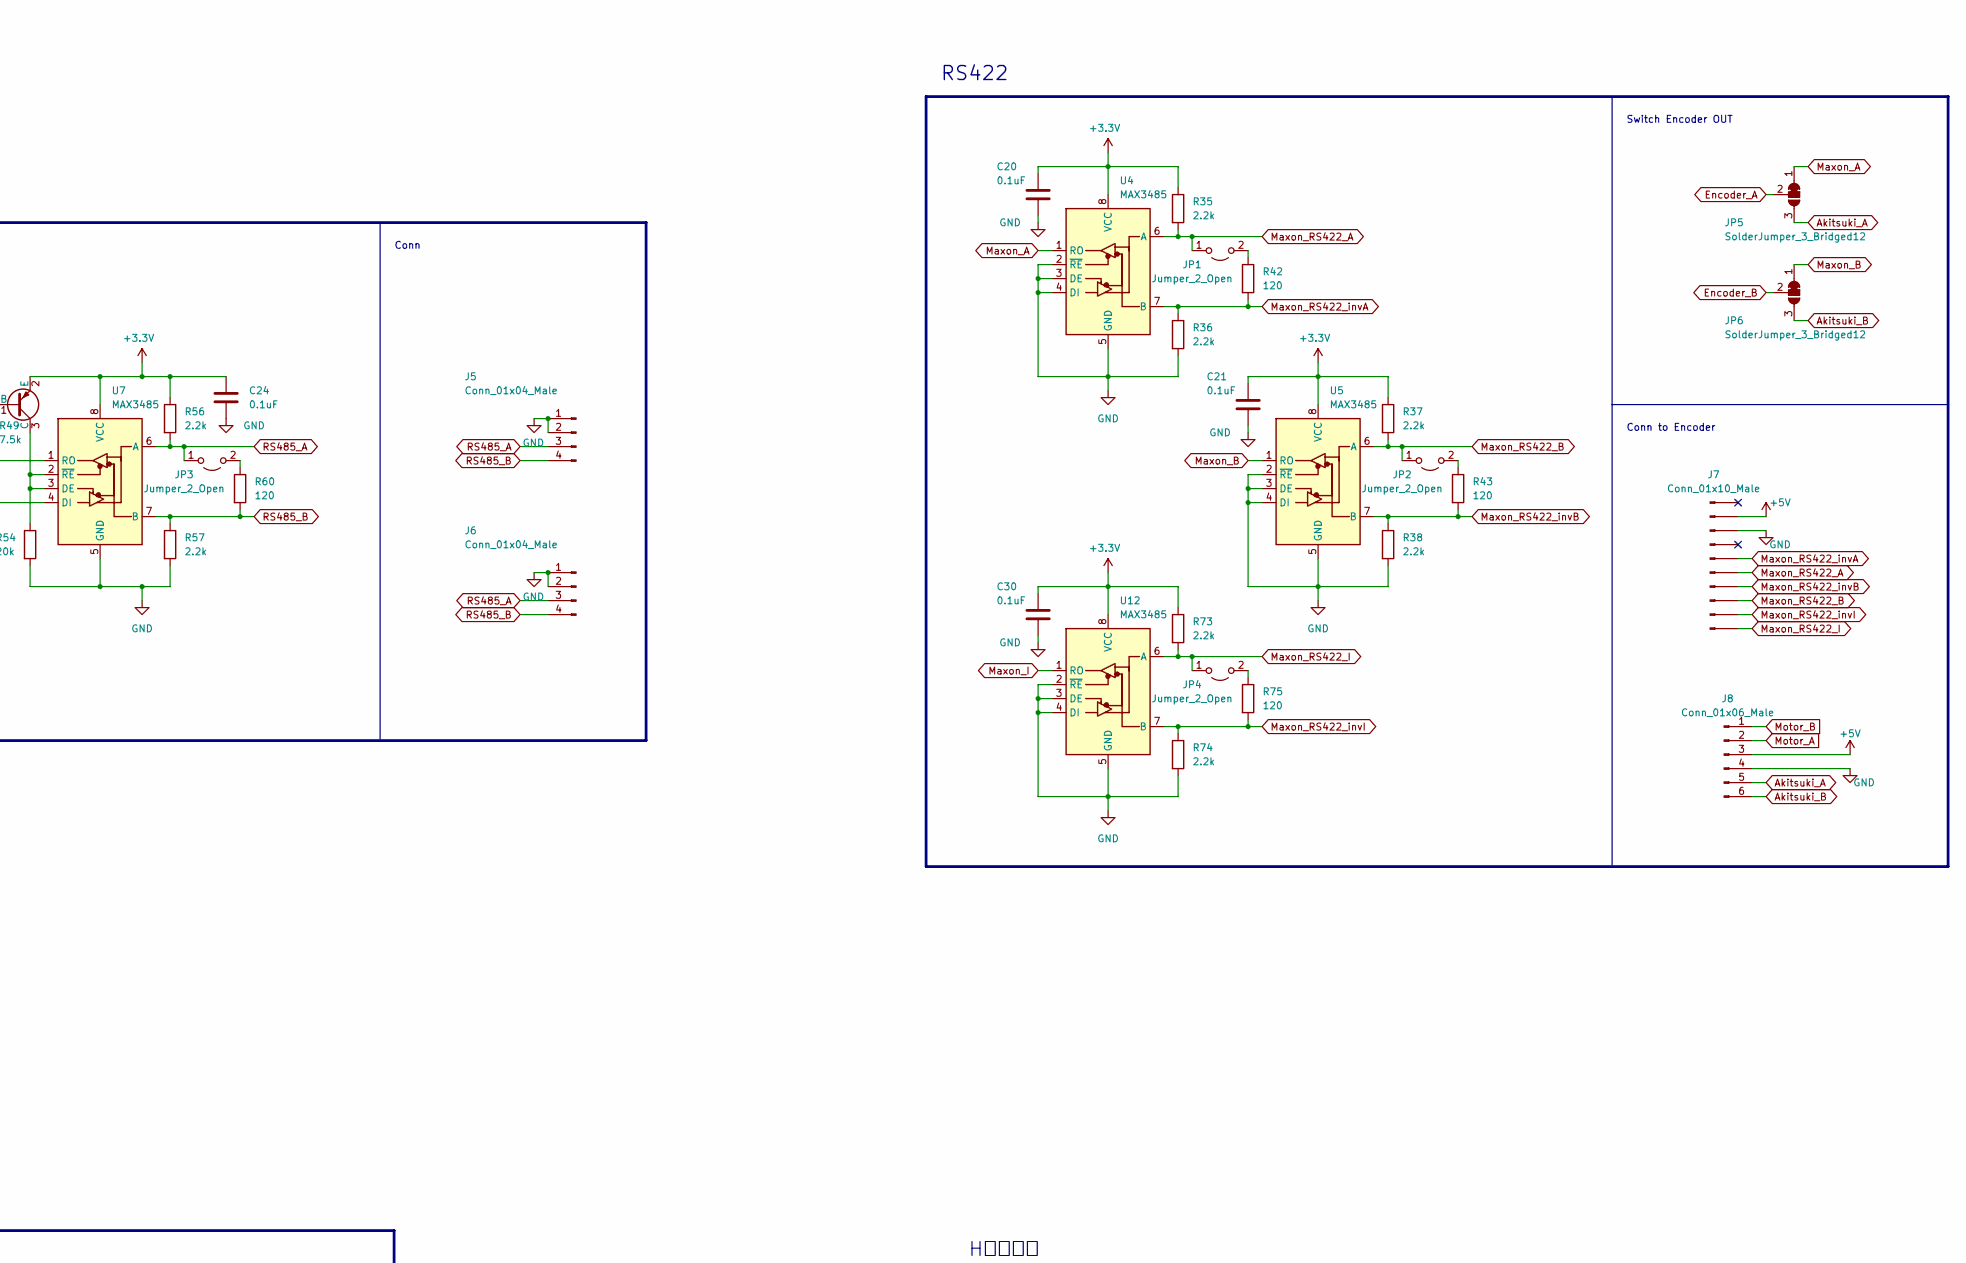
[picture p97: schematic SmallMD.kicad_sch, part in row 1, column 2]

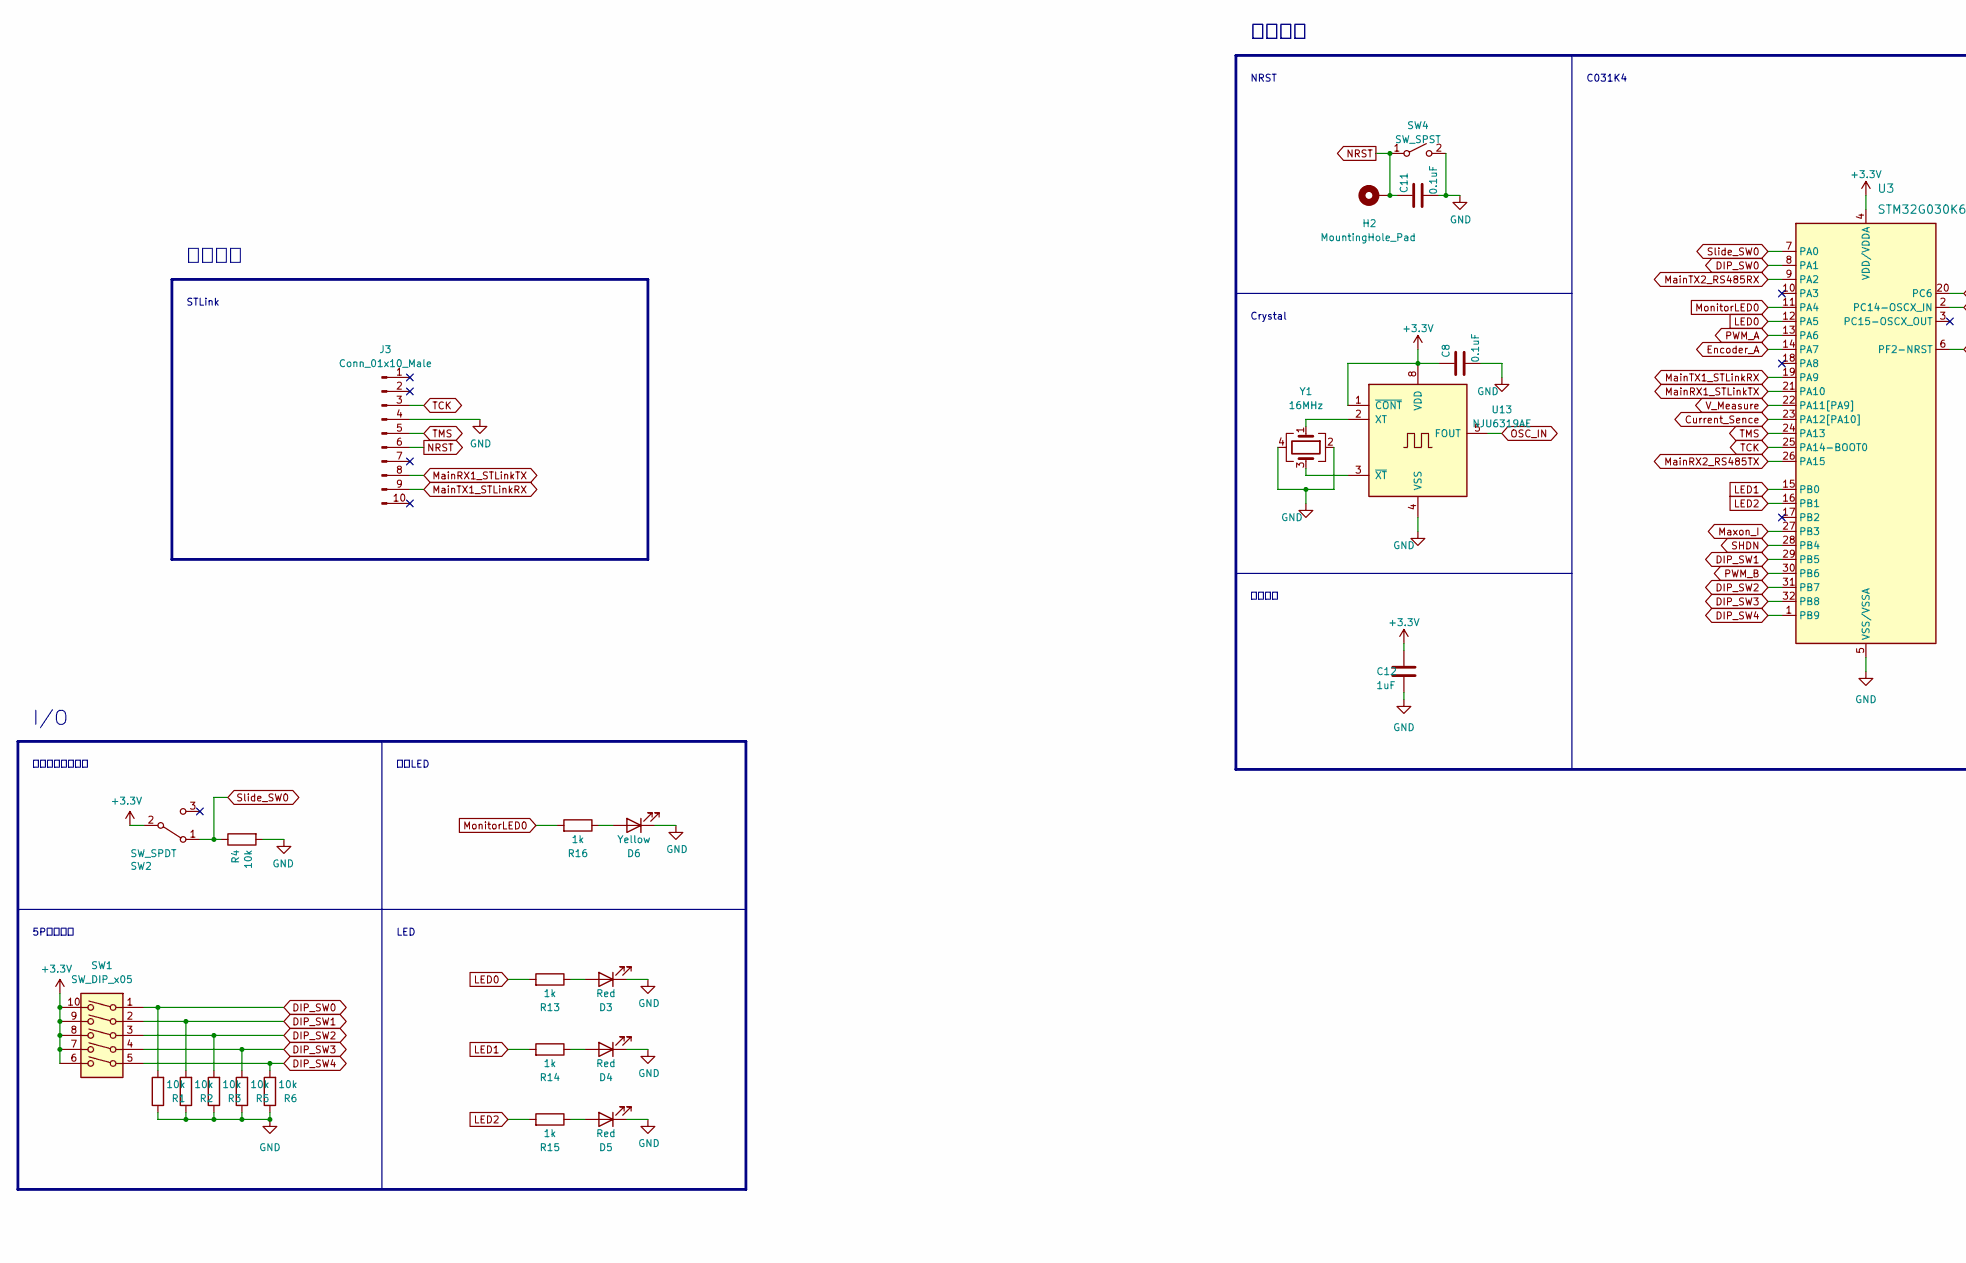
[picture p98: schematic SmallMD.kicad_sch, part in row 2, column 1]

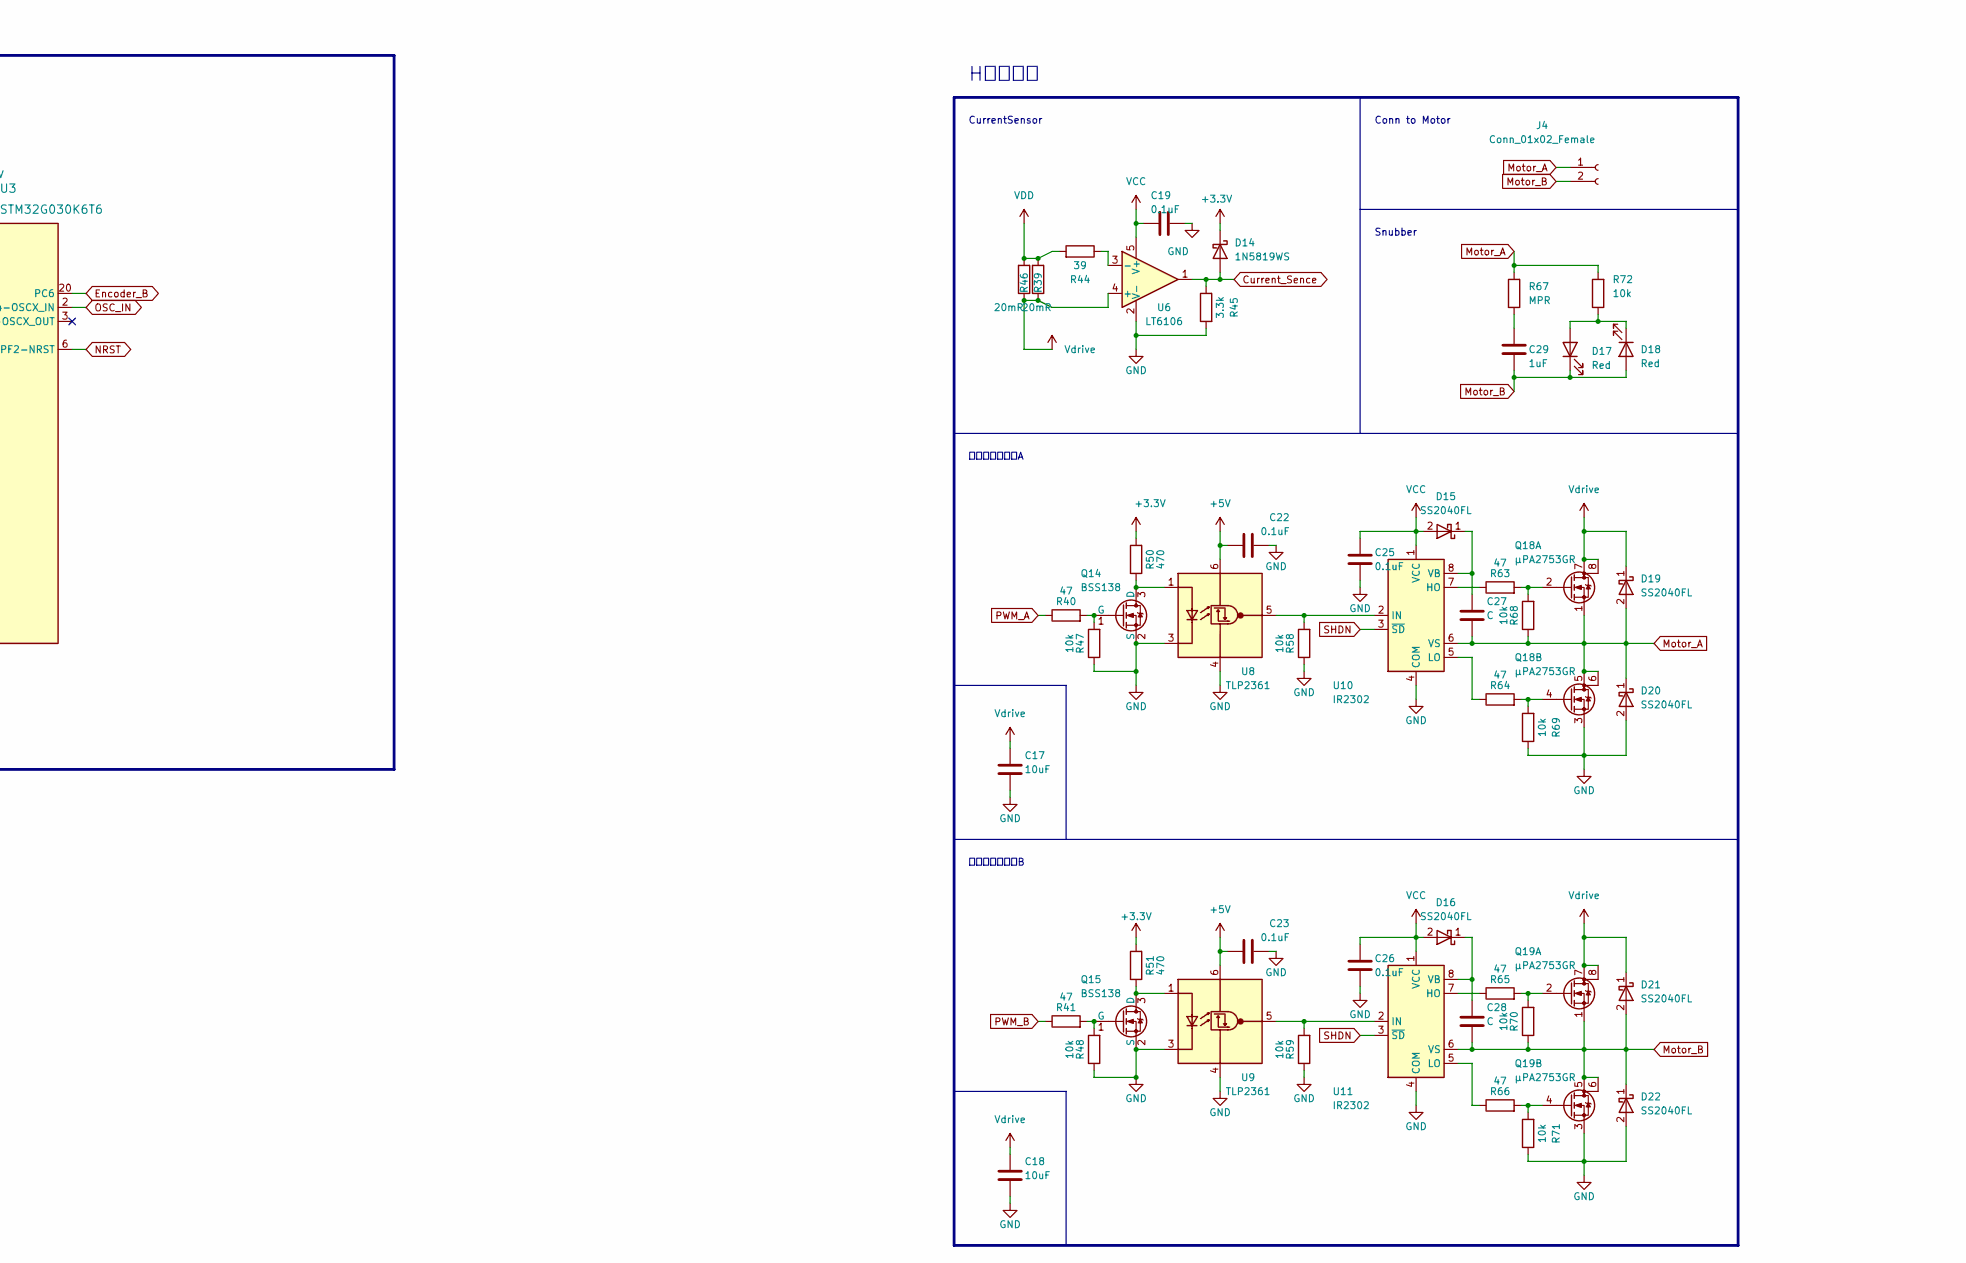
[picture p99: schematic SmallMD.kicad_sch, part in row 2, column 2]

Parts:
C1, C3, C4, C5, C6, C12, C29: 1uF; C_0402_1005Metric
C2, C7, C17, C18: 10uF; C_0805_2012Metric
C8, C11, C19, C20, C21, C22, C23, C24, C25, C26, C30: 0.1uF; C_0402_1005Metric
C13, C14: 470uF; C_Elec_8x10.2
C27, C28: C; C_1210_3225Metric_Pad1.33x2.70mm_HandSolder
D1, D7, D8, D14: 1N5819WS; D_SOD-323_HandSoldering
D2, D15, D16, D19, D20, D21, D22: SS2040FL; D_SOD-123
D3, D4, D5, D17, D18: Red; LED_0603_1608Metric_Pad1.05x0.95mm_HandSolder
D6: Yellow; LED_0603_1608Metric_Pad1.05x0.95mm_HandSolder
D10, D13: Green; LED_0603_1608Metric_Pad1.05x0.95mm_HandSolder
H2: MountingHole_Pad; TestPoint_Pad_1.5x1.5mm
J1: Conn_01x02_Male; AMASS_XT30U-M_1x02_P5.0mm_Vertical
J3: Conn_01x10_Male; BoxHeader_2x05_P1.27mm_Vertical_SMD
J4: Conn_01x02_Female; AMASS_XT30U-F_1x02_P5.0mm_Vertical
J5, J6: Conn_01x04_Male; Molex_SPOX_5267-04A_1x04_P2.50mm_Vertical
J7: Conn_01x10_Male; IDC-Header_2x05_P2.54mm_Vertical
J8: Conn_01x06_Male; JST_PH_B6B-PH-K_1x06_P2.00mm_Vertical
JP1, JP2, JP4: Jumper_2_Open; SolderJumper-2_P1.3mm_Open_TrianglePad1.0x1.5mm
JP3: Jumper_2_Open; PinHeader_1x02_P2.54mm_Vertical
JP5, JP6: SolderJumper_3_Bridged12; SolderJumper-3_P2.0mm_Open_TrianglePad1.0x1.5mm_NumberLabels
Q1, Q3: SSM6J808R
Q2, Q14, Q15: BSS138; SOT-23
Q16: S8050; SOT-23
Q18, Q19: μPA2753GR; SOP-8_3.9x4.9mm_P1.27mm
R1, R2, R3, R4, R5, R6, R7, R9, R10, R17, R18, R19, R47, R48, R58, R59, R68, R69, R70, R71, R72: 10k; R_0402_1005Metric
R8: 100k; R_0402_1005Metric
R11: 33k; R_0603_1608Metric
R12: 10k; R_0603_1608Metric
R13, R14, R15, R16, R31, R34: 1k; R_0402_1005Metric
R35, R36, R37, R38, R56, R57, R73, R74: 2.2k; R_0402_1005Metric
R39, R46: 20mR; R_2512_6332Metric
R40, R41, R63, R64, R65, R66: 47; R_0603_1608Metric
R42, R43, R60, R75: 120; R_0402_1005Metric
R44: 39; R_0603_1608Metric_Pad0.98x0.95mm_HandSolder
R45: 3.3k; R_0603_1608Metric_Pad0.98x0.95mm_HandSolder
R49: 7.5k; R_0603_1608Metric
R50, R51: 470; R_0402_1005Metric
R54: 20k; R_0402_1005Metric
R67: MPR; R_Axial_DIN0309_L9.0mm_D3.2mm_P12.70mm_Horizontal
SW1: SW_DIP_x05; DIP-10_W7.62mm
SW2: SW_SPDT; 3P_SPDT_SlideSwitch
SW3: SW_SPDT_White; SW_Slide_SPDT_White
SW4: SW_SPST; SW_Push_1P1T_NO_Vertical_Wuerth_434133025816
TP5: TestPoint; TestPoint_THTPad_D2.0mm_Drill1.0mm
U1: AZ1084CD-3.3; TO-252-3_TabPin2
U2: AZ1084CD-5.0; TO-252-3_TabPin2
U3: STM32G030K6T6; LQFP-32_7x7mm_P0.8mm
U4, U5, U7, U12: MAX3485; SOP-8_3.9x4.9mm_P1.27mm
U6: LT6106; SOT-23-5
U8, U9: TLP2361; SO-6_4.4x3.6mm_P1.27mm
U10, U11: IR2302; SOP-8_3.9x4.9mm_P1.27mm
U13: NJU6319AE; SOP-8_3.9x4.9mm_P1.27mm
Y1: 16MHz; Crystal_SMD_3225-4Pin_3.2x2.5mm_HandSoldering

Connections:
+3.3V: C5.1, C7.1, C8.1, C12.1, C20.1, C21.1, C24.1, C30.1, D7.2 (A), D14.1 (K), Q16.2 (E), R18.2, R34.2, R35.1, R37.1, R50.1, R51.1, R56.1, R73.1, SW1.6, SW1.7, SW1.8, SW1.9, SW1.10, SW2.2 (B), U1.2 (VO), U3.4 (VDD/VDDA), U4.8 (VCC), U5.8 (VCC), U7.8 (VCC), U12.8 (VCC), U13.1 (~CONT), U13.8 (VDD)
+5V: C2.1, C3.1, C6.1, C22.1, C23.1, D7.1 (K), D8.2 (A), J7.2, J8.3, R19.2, R31.2, U1.3 (VI), U2.2 (VO), U8.6 (VDD), U9.6 (VDD)
/7.4VBAT: J1.2, Q1.1 (D), Q1.2 (D), Q1.5 (D), Q1.6 (D)
/S-S: C1.1, Q1.4 (S), Q3.4 (S), R7.1, R8.1, SW3.2 (B)
Akitsuki_A: J8.5, JP5.3 (B)
Akitsuki_B: J8.6, JP6.3 (B)
Current_Sence: D14.2 (A), R45.1, U3.23 (PA12[PA10]), U6.1
DIP_SW0: R1.2, SW1.1, U3.8 (PA1)
DIP_SW1: R2.2, SW1.2, U3.29 (PB5)
DIP_SW2: R3.2, SW1.3, U3.31 (PB7)
DIP_SW3: R5.2, SW1.4, U3.32 (PB8)
DIP_SW4: R6.2, SW1.5, U3.1 (PB9)
Encoder_A: JP5.2 (C), U3.14 (PA7)
Encoder_B: JP6.2 (C), U3.20 (PC6)
GND: C2.2, C3.2, C4.2, C5.2, C6.2, C7.2, C8.2, C11.2, C12.2, C13.2, C14.2, C17.2, C18.2, C19.1, C20.2, C21.2, C22.2, C23.2, C24.2, C25.2, C26.2, C30.2, D1.2 (A), D3.1 (K), D4.1 (K), D5.1 (K), D6.1 (K), D10.1 (K), D13.1 (K), D20.2 (A), D22.2 (A), J1.1, J3.4, J5.1, J5.2, J6.1, J6.2, J7.3, J8.4, Q1.3 (G), Q2.2 (S), Q14.2 (S), Q15.2 (S), Q18.3 (S), Q19.3 (S), R1.1, R2.1, R3.1, R4.2, R5.1, R6.1, R7.2, R10.2, R12.2, R17.1, R18.1, R19.1, R36.2, R38.2, R45.2, R47.1, R48.1, R54.2, R57.2, R58.1, R59.1, R69.1, R71.1, R74.2, SW4.2 (B), TP5.1, U1.1 (GND), U2.1 (GND), U3.5 (VSS/VSSA), U4.2 (~RE), U4.3 (DE), U4.4 (DI), U4.5 (GND), U5.2 (~RE), U5.3 (DE), U5.4 (DI), U5.5 (GND), U6.2 (V-), U7.5 (GND), U8.3 (K), U8.4 (GND), U9.3 (K), U9.4 (GND), U10.4 (COM), U11.4 (COM), U12.2 (~RE), U12.3 (DE), U12.4 (DI), U12.5 (GND), U13.4 (VSS), Y1.2, Y1.4
LED0: R13.2, U3.12 (PA5)
LED1: R14.2, U3.15 (PB0)
LED2: R15.2, U3.16 (PB1)
MainRX1_STLinkTX: J3.8, U3.21 (PA10)
MainRX2_RS485TX: U3.26 (PA15), U7.1 (RO)
MainTX1_STLinkRX: J3.9, U3.19 (PA9)
MainTX2_RS485RX: R49.2, U3.9 (PA2), U7.4 (DI)
Maxon_A: JP5.1 (A), U4.1 (RO)
Maxon_B: JP6.1 (A), U5.1 (RO)
Maxon_I: U3.27 (PB3), U12.1 (RO)
Maxon_RS422_A: J7.6, JP1.1 (A), R35.2, U4.6 (A)
Maxon_RS422_B: J7.8, JP2.1 (A), R37.2, U5.6 (A)
Maxon_RS422_I: J7.10, JP4.1 (A), R73.2, U12.6 (A)
Maxon_RS422_invA: J7.5, R36.1, R42.2, U4.7 (B)
Maxon_RS422_invB: J7.7, R38.1, R43.2, U5.7 (B)
Maxon_RS422_invI: J7.9, R74.1, R75.2, U12.7 (B)
MonitorLED0: R16.2, U3.11 (PA4)
Motor_A: C27.2, D19.2 (A), D20.1 (K), J4.1, J8.2, Q18.1 (S), Q18.5 (D), Q18.6 (D), R67.1, R68.1, R72.2, U10.6 (VS)
Motor_B: C28.2, C29.2, D17.1 (K), D18.2 (A), D21.2 (A), D22.1 (K), J4.2, J8.1, Q19.1 (S), Q19.5 (D), Q19.6 (D), R70.1, U11.6 (VS)
NRST: C11.1, H2.1, J3.6, SW4.1 (A), U3.6 (PF2-NRST)
unnamed: C1.2, Q3.3 (G), R8.2, R9.1
unnamed: C27.1, D15.1 (K), U10.8 (VB)
unnamed: C28.1, D16.1 (K), U11.8 (VB)
unnamed: C29.1, R67.2
unnamed: D3.2 (A), R13.1
unnamed: D4.2 (A), R14.1
unnamed: D5.2 (A), R15.1
unnamed: D6.2 (A), R16.1
unnamed: D10.2 (A), R31.1
unnamed: D13.2 (A), R34.1
unnamed: D17.2 (A), D18.1 (K), R72.1
unnamed: JP1.2 (B), R42.1
unnamed: JP2.2 (B), R43.1
unnamed: JP3.2 (B), R60.1
unnamed: JP4.2 (B), R75.1
unnamed: Q2.3 (D), R9.2
unnamed: Q14.1 (G), R40.2, R47.2
unnamed: Q14.3 (D), R50.2, U8.1 (A)
unnamed: Q15.1 (G), R41.2, R48.2
unnamed: Q15.3 (D), R51.2, U9.1 (A)
unnamed: Q16.1 (B), R49.1
unnamed: Q16.3 (C), R54.1, U7.2 (~RE), U7.3 (DE)
unnamed: Q18.2 (G), R63.2, R68.2
unnamed: Q18.4 (G), R64.2, R69.2
unnamed: Q19.2 (G), R65.2, R70.2
unnamed: Q19.4 (G), R66.2, R71.2
unnamed: R44.1, U6.3 (-)
unnamed: R58.2, U8.5 (VO), U10.2 (IN)
unnamed: R59.2, U9.5 (VO), U11.2 (IN)
unnamed: R63.1, U10.7 (HO)
unnamed: R64.1, U10.5 (LO)
unnamed: R65.1, U11.7 (HO)
unnamed: R66.1, U11.5 (LO)
unnamed: U13.2 (XT), Y1.1
unnamed: U13.3 (~XT), Y1.3
OSC_IN: U3.2 (PC14-OSCX_IN), U13.5 (FOUT)
PWM_A: R40.1, U3.13 (PA6)
PWM_B: R41.1, U3.30 (PB6)
RS485_A: J5.3, J6.3, JP3.1 (A), R56.2, U7.6 (A)
RS485_B: J5.4, J6.4, R57.1, R60.2, U7.7 (B)
SHDN: U3.28 (PB4), U10.3 (~SD), U11.3 (~SD)
Slide_SW0: R4.1, SW2.1 (A), U3.7 (PA0)
TCK: J3.3, U3.25 (PA14-BOOT0)
TMS: J3.5, U3.24 (PA13)
VCC: C4.1, C14.1, C19.2, C25.1, C26.1, D2.1 (K), D8.1 (K), D15.2 (A), D16.2 (A), R17.2, U2.3 (VI), U6.5 (V+), U10.1 (VCC), U11.1 (VCC)
VDD: C13.1, D1.1 (K), D2.2 (A), Q3.1 (D), Q3.2 (D), Q3.5 (D), Q3.6 (D), R11.1, R39.2, R44.2, R46.2
V_Measure: R11.2, R12.1, U3.22 (PA11[PA9])
Vdrive: C17.1, C18.1, D19.1 (K), D21.1 (K), Q18.7 (D), Q18.8 (D), Q19.7 (D), Q19.8 (D), R39.1, R46.1, U6.4 (+)
主電源スイッチ: Q2.1 (G), R10.1, SW3.1 (A)

Notes on the sheet:
Switch Encoder OUT
Hブリッジ
I/O
スライドスイッチ
保護回路・スイッチ
PowerModule
LED
C031K4
TestPoint
RS422
インジケーターLED
マイコン
NRST
5V生成
Conn to Motor
STLink
ハーフブリッジA
Crystal
CurrentSensor
RS485
5Pスイッチ
Capacitor
3.3V生成
MAX3485
Snubber
Conn
Conn to Encoder
Conn to Power
書き込み
監視LED
主電源スイッチ
ハーフブリッジB
パスコン

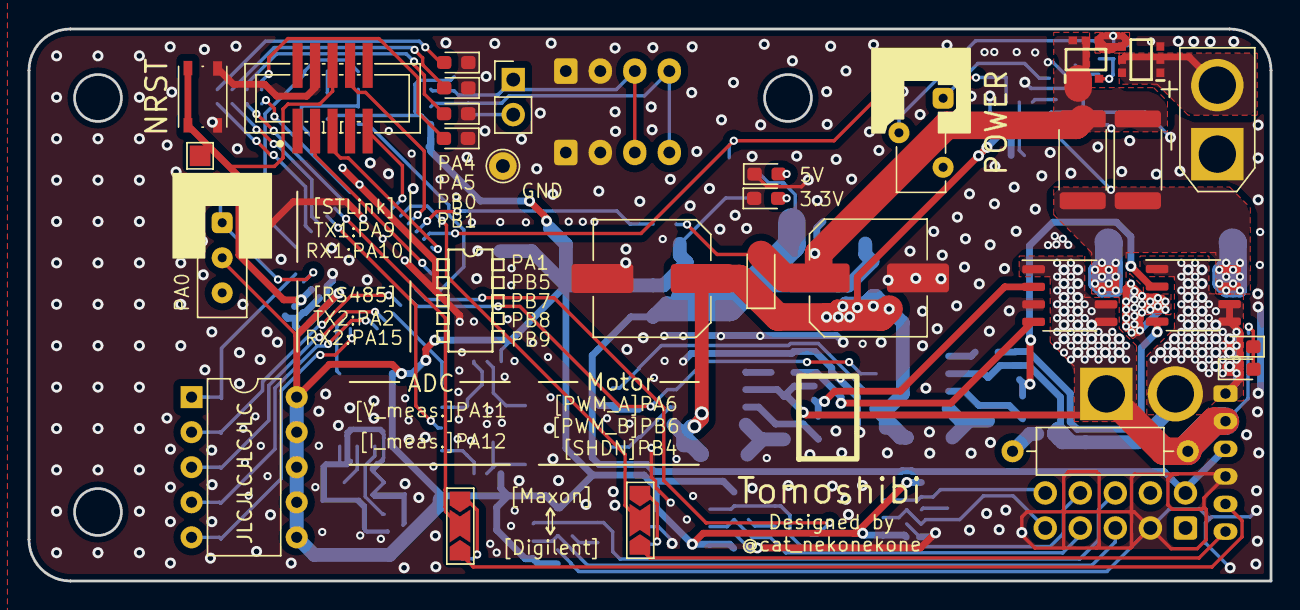
[picture p100: board SmallMD.kicad_pcb from above]

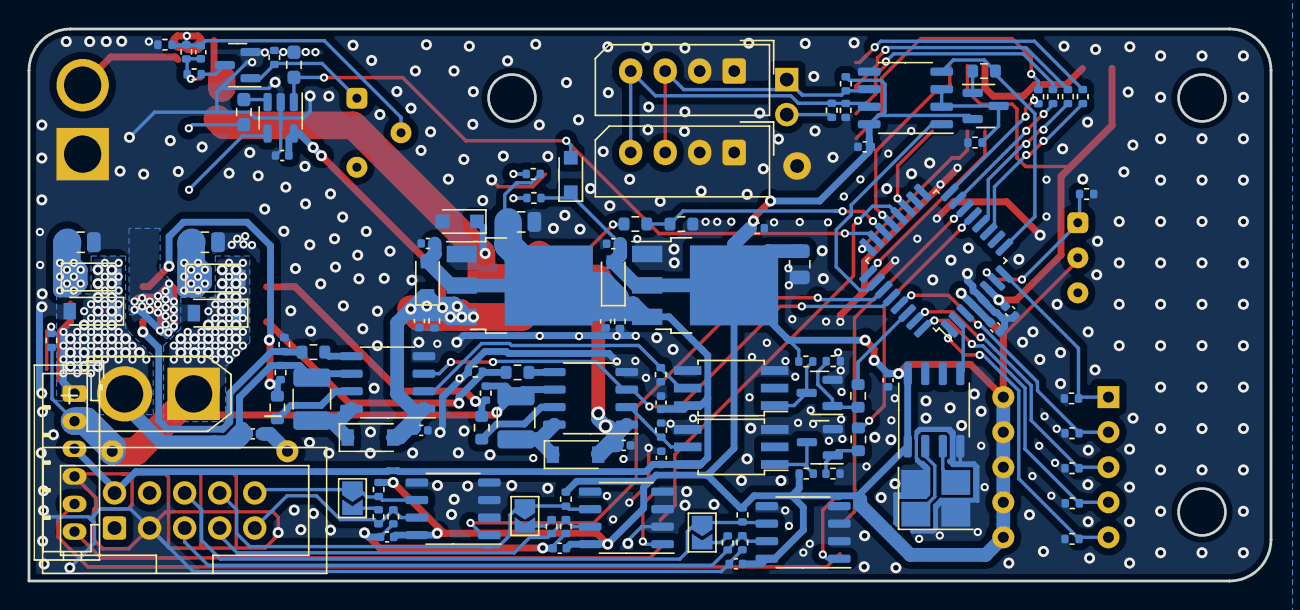
[picture p101: board SmallMD.kicad_pcb from below]

Board: 2 copper layers, 90.0 x 40.0 mm, 143 parts (114 on the bottom side), 84 nets.
