Tomoshibi-technology/RCJ-Japan2024-Circuit/(commit log)

2024-01-30 回路設計
    [Encoder.kicad_sch, IR.kicad_sch, LargeMD.kicad_sch, Pannel.kicad_sch, Pole.kicad_sch, SmallMD.kicad_sch]
2024-01-30 MV2_EncoderのDXFデータ追加
    [MV2_Encoder_OUTLINE.dxf, MV2_Encoder_SILK.dxf]
2024-01-30 IR基板のエッジとシルク追加
    [IR_EdgeCuts.dxf, IR_Silkscreen.dxf]
2024-01-30 MV2_MDのDXFデータ
    [MV2_MD_BK_SILK.dxf, MV2_MD_FR_SILK.dxf, MV2_MD_OUTLINE.dxf]
2024-01-30 IR基板のEdgeCuts修正
    [IR_EdgeCuts.dxf]
2024-01-30 MV2_MDのDXFデータ修正
    [MV2_MD_BK_SILK2.dxf]
2024-02-01 構成図追加
    [Encoder.kicad_sch, IR.kicad_pcb, IR.kicad_sch, LargeMD.kicad_sch, Pannel.kicad_sch, Pole.kicad_sch, SmallMD.kicad_sch]
2024-02-01 MV2 PWのDXFde-ta
    [MV2_PW_OUTLINE.dxf, MV2_PW_SILK.dxf]
2024-02-01 SmallMDの基板外形追加
    [SmallMD_EdgeCuts.dxf, SmallMD_Silkscreen.dxf]
2024-02-01 回路図pdf出力
    [Encoder.kicad_pcb, Encoder.kicad_sch, IR.kicad_sch, LargeMD.kicad_sch, Pannel.kicad_sch, Pole.kicad_sch, SmallMD.kicad_sch, SmallPW.kicad_sch]
2024-02-01 SmallMDの裏面実装禁止エリア追加
    [SmallMD_裏面実装禁止エリア.dxf]
2024-02-01 SmallPW基板外形追加
    [SmallPW_EdgeCuts.dxf, SmallPW_背面実装禁止エリア.dxf]
2024-02-01 定期更新
    [Encoder.kicad_pcb, Encoder.kicad_sch, SmallPW.kicad_pcb, SmallPW.kicad_sch]
2024-02-02 MV2 PWの入れ替え
    [MV2_PW_SILK.dxf, MV2_PW_SILK2.dxf]
2024-02-02 MV2 PanelのDXFデータ
    [MV2_Panel_BK_SILK.dxf, MV2_Panel_FW_SILK.dxf, MV2_Panel_OUTLINE.dxf]
2024-02-03 IR基板外形の修正
    [IR_EdgeCuts.dxf, IR_Silkscreen.dxf]
2024-02-04 IR、SmallMD、SmallPWのdxf追加
    [IR_Silkscreen.dxf, SmallMD_EdgeCuts.dxf, SmallMD_Silkscreen_B.dxf, SmallMD_Silkscreen_F.dxf, SmallPW_EdgeCuts.dxf, SmallPW_Silkscreen_B.dxf, SmallPW_Silkscreen_F.dxf]
2024-02-04 エンコーダー基板配線完了
    [Encoder.kicad_pcb, Encoder.kicad_sch, IR.kicad_sch, LargeMD.kicad_pcb, LargeMD.kicad_sch, LargePW.kicad_sch, MV2_Panel_BK_SILK.dxf, MV2_Panel_FW_SILK.dxf]
2024-02-06 Mother外形追加
    [mother.dxf]
2024-02-06 人力曲面配線中
    [Encoder.kicad_sch, IR.kicad_pcb, IR.kicad_sch, LargeMD.kicad_pcb, SmallMD.kicad_pcb, SmallMD.kicad_sch]
2024-02-06 ゴリ押し人力配線
    [IR.kicad_pcb]
2024-02-07 基板類の外形にフィレットをかけた
    [IR_EdgeCuts.dxf, IR_Silkscreen.dxf, SmallMD_EdgeCuts.dxf, SmallMD_Silkscreen_B.dxf, SmallMD_Silkscreen_F.dxf, SmallPW_EdgeCuts.dxf, SmallPW_Silkscreen_B.dxf, SmallPW_Silkscreen_F.dxf]
2024-02-07 IR半分
    [IR.kicad_pcb, IR.kicad_sch]
2024-02-07 IR基板のシルクスクリーン変更
    [IR_Silkscreen.dxf]
2024-02-07 LargeMDほぼ完成
    [Encoder.kicad_pcb, IR.kicad_pcb, IR.kicad_sch, LargeMD.kicad_pcb, LargeMD.kicad_sch, LargePW.kicad_pcb, LargePW.kicad_sch, Panel.kicad_sch]
2024-02-07 SmallMDほぼ完成
    [BOM-SmallPW.csv, LargePW.kicad_pcb, LargePW.kicad_sch, SmallMD.kicad_pcb, SmallMD.kicad_sch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]
2024-02-10 製造ファイル出力
    [BOM-Encoder.csv, BOM-IR.csv, BOM-LargeMD.csv, BOM-SmallMD.csv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]
2024-02-10 製造ファイル出力その2
    [LargeMD-CuBottom.gbr, LargeMD-CuTop.gbr, LargeMD-EdgeCuts.gbr, LargeMD-MaskBottom.gbr, LargeMD-MaskTop.gbr, LargeMD-NPTH.drl, LargeMD-PTH.drl, LargeMD-PasteBottom.gbr]
2024-02-10 アームLED基板とアーム接続基板追加
    [BOM-LED_lighting_large.csv, BOM-connect.csv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]
2024-02-10 回路図プロット
2024-02-13 DCDC回路図変更
    [LargePW.kicad_pcb, LargePW.kicad_sch, MV2_Panel_BK_SILK.dxf, MV2_Panel_FW_SILK.dxf, MV2_Panel_OUTLINE.dxf, Mother_Ctrl.kicad_pcb, Mother_Ctrl.kicad_sch, Mother_UI.kicad_pcb]
2024-02-17 回路図ほぼ完成
    [Encoder.kicad_sch, LargePW.kicad_pcb, Mother_Ctrl.kicad_sch, Mother_UI.kicad_sch, Panel.kicad_pcb, Panel.kicad_sch, Pole.kicad_pcb, Pole.kicad_sch]
2024-02-20 Pole,Panelほぼ完成
    [ESPピン表.xlsx, Mother_Ctrl.kicad_sch, Mother_UI.kicad_sch, Panel.kicad_pcb, Panel.kicad_sch, Pole.kicad_pcb, Pole.kicad_sch, 部品表.xlsx]
2024-02-26 Mother_Ctrl回路図プロット
    [Mother_Ctrl-B_Silkscreen.dxf, Mother_Ctrl-Edge_Cuts.dxf, Mother_Ctrl-F_Silkscreen.dxf, Mother_Ctrl.kicad_pcb, Mother_Ctrl.kicad_sch, Mother_UI.kicad_pcb, Mother_UI.kicad_sch, Panel.kicad_pcb]
2024-02-27 回路図確定
    [Mother_Ctrl-F_Silkscreen.dxf, Mother_Ctrl.kicad_pcb, Mother_Ctrl.kicad_sch, Mother_UI.kicad_pcb, Mother_UI.kicad_sch]
2024-02-28 多分完成
    [BOM-LargePW.csv, BOM-Mother_Ctrl.csv, BOM-Mother_UI.csv, BOM-Panel.csv, BOM-Pole.csv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]
2024-03-25 全国大会終わり
2024-04-02 パネルPDF更新
2024-04-02 DCDC全国仕様書き起こし
2024-11-15 gitignore追加
